bjthemost-hub/l103-drv8313-as5600/firmware/命令表与使用说明_UART与CAN_2026-09-28.md

# CH32L103_DRV8313_FOC_CAN —— 命令表与使用说明（UART + CAN）

**适用固件**：本仓库 `firmware/`
**整理日期**：2026-09-28 ｜ **依据**：全部逐条读源码核过（`cmd.c` / `motion_pv.c` / `can_bus.c` / `can_bus.h` / `board.h` / `faults.h` / `motion_pv.h`），
行号在文中标出；**不是**凭记忆或二手转述。没有实测过的项在末尾单列。

---

## 0. 两个口

| 口 | 物理 | 参数 | 说明 |
|---|---|---|---|
| UART1 控制台 | WCH-Link 自带的串口桥 → **COM15** | **115200** 8N1，命令以**回车**结束 | 人机调试口 |
| CAN1 | SN65HVD230，`PB8`=RX / `PB9`=TX | 标准帧 11bit；位时序 `board.h:73-75` = 预分频 2 / BS1 15tq / BS2 8tq / SJW 1tq（共 24tq）；`can_bus.h` 顶部注释写 **1 Mbps**（未量总线波形） | 上位机/总线控制口 |

- UART **不分大小写**（`cmd.c:495` 把小写折成大写），允许前导空格。
- **CAN 数据全部小端**（`can_bus.h` 顶部）。
- **发帧之前先认转接卡**：下面这些是**板子认的**帧。达妙那块 DM-USB2CAN 要在 COM5 上再套一层
  30 字节信封，沁恒 CH9433 EVB 直接发裸帧 —— 见 **§9**。
- 只有一方能开 COM15：脚本被打断会吊住端口，需要
  `Get-CimInstance Win32_Process | ? { $_.CommandLine -match '<脚本名>' }` 找出来 `Stop-Process -Force`。

---

## 0.5 ★ 铁律（都是踩出来的，先看这条）

> 这一段是从工程根那份索引文档搬进来的（2026-09-29 单一化）。**编号沿用旧表** ——
> 固件 `board.h` 的注释里写的"见命令表 铁律 #9"指的就是这里的第 9 条，别改号。

1. **`A` 对齐会强行拽转子** —— 对齐前电机必须能自由转；带着负载/卡死会对齐失败甚至堵转。
2. **改极对数之后必须重跑 `A`**。改极对数会把"已对齐"作废（零点电角是用旧极对数算的）。
3. **改控制器模式之前先 `B1`**（停+松轴）。`cmd_target` 一个变量被三种控制器共用（角度环=绝对多圈 rad / 速度环=rad/s / 力矩=电压 V），不看模式就切会**满压冲一下**。
4. **螺丝/外壳绝对不能碰 GND** —— 已经因此烧掉两颗 DRV8313 + 一颗 Si2319。
5. **`U`（重校电流零点）必须在电机停转时**做。
6. **上电默认相电压上限 = Vbus/√3，不用再 `L`**（`Motion_ApplyBootVoltageLimit()`，`motion_pv.c:484-493`，
   在 `main.c:140` 于 Flash 参数恢复之后调用）。24 V 母线 → **13.86 V**；Vbus 是参数
   （串口 `#0,0,36` / CAN `0x116` b4..5），改成 36 V 后上限变 20.78 V。
   ~~旧说法「上电默认只有 3.0 V」~~ 那是 `board.h` 里 `MOTOR_VOLTAGE_LIMIT` 还是 `3.0f` 的那版（**2026-09-28 之前**，
   已在 2026-09-29 更正）；现在宏是 `0.0f`（哨兵 = 跟母线走，`board.h:105`）。
7. **角度环输出还卡在 130 rad/s = 1241 rpm**（`MOTOR_VELOCITY_LIMIT`）。
   CAN/串口的速度上限给再大也没用 —— 要更高用 `0x115` 或改 `board.h`（运行时上限 150 rad/s = 1432 rpm）。
8. **汇报时用网名**（`MOT_A_V` / `MOT_B_V` / `ADC0` / `EN_A` / `PWM_A` / `+VDJ` / `G`），不要说 TP 号/位号。
9. **CAN 发帧会堵主循环 —— 所以它是被动设备，而且发帧必须有界**（2026-09-29 定案）
   - **现象**：总线没人给 ACK 时（USB-CAN 适配器没上线 / 没在收），旧固件 `CAN_Bus_SendStd()`
     在 `CAN_TransmitStatus()==Pending` 上**忙等 200000 圈**才放弃，**一帧堵约 162 ms**。
     主循环每 10 ms 想发一帧反馈 -> 被吃满 -> `LoopFOC()`（`main.c:184`）每秒只跑 **3~7 次**（正常 ~2000 次）。
     **2026-09-29 实测**：适配器不在线时 `n_tx=0`、`tx_fail` 猛涨、`TICK loopmax=162.5 ms`（最高 480 ms）、
     `loops=3~7`；适配器上线后 `tx_fail` 冻结、`loopmax=3.7 ms`、`loops≈1490~2110`。
     **排查口诀：`S` 看 `loops`，低于 ~1500 就是被 CAN 这位堵死了**（不是电机坏、不是驱动器坏）。
   - **现在的做法**：① 主动上报默认关（没有周期帧就没人来堵你）；② 发帧改成**按时间有界等待**
     （`CAN_TX_TIMEOUT_US = 2000us`，超时 `CAN_CancelTransmit` 丢帧），超时就取消这一帧 —— 宁可丢帧，不许堵环。

---

## 1. ★ 先记这一张：语义 / 单位（踩过事故的地方）

| 命令 | 绝对还是相对 | 单位 | 依据 |
|---|---|---|---|
| `G<x>@<rpm>` | **绝对**目标位置 | `x` = **圈**（不是弧度、不是度） | `cmd.c:682-688`（`Motion_RunPV(turns*_2PI, ...)`）+ `motion_pv.c:183`（`tgt_rad = target_rad` 直接赋值） |
| `P<deg>` | **绝对** | 度（可多圈） | `cmd.c:551-554` |
| `C<turns>` | **相对**（`+=`） | 圈 | `cmd.c:557-560` |
| `V<rpm>` | 速度目标 | rpm（机械） | `cmd.c:544-548` |
| `T<volts>` | 力矩目标 | V（相电压） | `cmd.c:538-541` |
| `N[<rpm>]` | 去**机械零点** | rpm | `cmd.c:622-624` + `motion_pv.c:604-618` |
| CAN `0x100` | 默认**绝对**（bit0 置 1 才相对） | mrad / 0.01 rad/s | `can_bus.h` 0x100 |

**`G` 的坑（2026-09-28 实锤）**：我把"相对 20 圈"算成弧度 `-131.2537` 发过去，固件按**圈**读
→ 目标是 `-131.25 × 2π = -824.8 rad`（-131 圈），电机真的跑出去又跑回来。
**要相对移动 N 圈**：先读 `S` 的 `shaft`，算 `目标圈数 = shaft/2π + N`，再发 `G<目标圈数>@<rpm>`。

**"小数字 ≠ 小幅度"**：想小幅验证，必须取一个**贴住当前位置**的绝对目标（先读当前位置再算），
别随手填个 `0.05`。

---

## 2. UART 命令表

### 2.1 只读 / 诊断

| 命令 | 作用 | 备注（出处） |
|---|---|---|
| `H` / `?` | 帮助 | `cmd.c:236-253` |
| `S` | 打一行状态 | `cmd.c:514-518` |
| `S0` / `S1` | 关 / 开 周期自动打印状态 | 非 0 值即开（`cmd.c:515`） |
| `W` | 运动 / 位置日志状态 | `cmd.c:618-620` |
| `Y` | AS5600 诊断（含 `raw/ang/AGC/MAG/err`，另有 `ANGLE(0x0E)/CONF(0x07)`） | `cmd.c:585-587`、`:297-300` |
| `Q` | DRV8313 / TIM3 引脚与复用诊断 | `cmd.c:594-596` |
| `I` | 故障现场 | `cmd.c:657-660` |
| `#` | 看电机参数（极对数/堵转/母线） | `cmd.c:645-649` |
| `K` | CAN 状态；`K0`/`K1` 反馈关/开；`KR` 清计数器 | `cmd.c:607-612` |
| `J` | 发一帧 CAN 测试帧 | `cmd.c:614-616` |
| `R` | 强制 I2C 总线恢复 | `cmd.c:589-592` |
| `X0` / `X1` | 关 / 开传感器轮询（`X1` 打的是 5 ms） | `cmd.c:580-583` |

### 2.2 使能 / 安全

| 命令 | 作用 | 备注（出处） |
|---|---|---|
| `E` | 合 EN **并进角度环保持当前位置** | 没对齐直接拒：`ERR: align first before enable`（`cmd.c:571-574`） |
| `D` | 失能（松轴，输出高阻） | `cmd.c:576-578` |
| `B` | 停 + **保持**（在原地） | `cmd.c:666-668` + `motion_pv.c:213-235` |
| `B1` | 停 + **松轴**（coast，断 EN） | 同上（参数非 0 即释放） |
| `O` | 清堵转故障（顺带重新使能并保持） | `cmd.c:662-664` + `motion_pv.c:636-655` |
| `A` | 对齐（**会强行拽转子**，电机必须能自由转） | `cmd.c:598-605` |
| `U` | 重标电流零点（**电机必须停着**） | `cmd.c:670-678` |
| `Z` | 把当前角度定义成 0 **并存 Flash** | `cmd.c:692-699`；改前先想清楚，它会覆盖零点 |
| `F` | 把当前位置设为**机械零点** | `cmd.c:627-630` + `motion_pv.c:433` |

### 2.3 运动

| 命令 | 语法 | 语义 | 备注（出处） |
|---|---|---|---|
| 模式 | `M0..M4` | 0=力矩(V) 1=速度环 2=角度环 3=速度开环 4=角度开环 | `M1`/`M2` **必须先对齐**；会**丢掉上一条 PV 轨迹**（`Motion_AbortPV`）（`cmd.c:520-535`） |
| 力矩 | `T<volts>` | 相电压（力矩） | 钳在 ±`voltage_limit`（`cmd.c:540`） |
| 速度 | `V<rpm>` | 机械转速 | 力矩模式下拒：`ERR: torque mode, use T<volts>`（`cmd.c:544-548`） |
| 位置(绝对) | `P<deg>` | **绝对**机械角，可多圈 | `cmd.c:551-554`；**在 HOLD 下会被每拍覆盖掉**（见坑） |
| 位置(相对) | `C<turns>` | `cmd_target += val*2π` | `cmd.c:557-560`；**它不切模式**——在 IDLE/力矩模式下会被当力矩电压用（见坑） |
| 位置(绝对+限速) | `G<turns>@<rpm>` | 走到**绝对**圈数，速度上限 rpm | `@` 省略或为 0 → 默认 **30 rpm**（`cmd.c:683-688`）；**它自己切角度环**、按速度曲线走、走完保持 |
| 回零 | `N[<rpm>]` | 走回机械零点 | 没设过零位 → `HOME: no mech zero set`（`motion_pv.c:606-610`）；速度 0 → 默认 `MOTION_HOME_VLIM_DEF = 3.14159 rad/s = 30 rpm`（`board.h:132`） |
| 设零 | `F` | 当前位置 = 机械 0 | 只写机械零点，不重置传感器累计角 |

### 2.4 参数 / 校准

| 命令 | 语法 | 说明（出处） |
|---|---|---|
| 相电压上限 | `L<volts>` | 钳在 `(0, vbus/√3]`；24 V 母线 → 最大 **13.86 V**（`cmd.c:563-568`） |
| 电机参数 | `#<pp>,<A>[,<V>]` | 极对数 / 堵转阈值(A) / 母线电压(V)；**下一项给 0 = 不改**（`#0,0,36` 只改母线）。写 Flash（`cmd.c:632-655`） |
| 量程 | — | 极对数 `1..64`（`board.h:49-50`）；堵转 `0.1..3.0 A`（`board.h:51-52`，>2.5 A 会提示 DRV8313 自身限流）；母线 `8.0..36.0 V`（`board.h:92-95`，下限出处 DRV8313 手册 6.3，上限出处用户给的关节 24~36 V） |
| 直流保持 | `@<V>[,<s>]` | 量母线电流 / 量相电阻用；默认 2 s（`cmd.c:501-506`），帮助文本写"max 5s"（`cmd.c:252`），`Cmd_DcHold` 内部的钳位本次**没逐行读** |

> ⚠ **改极对数会把"已对齐"作废**（`zero_electric_angle` 是拿旧极对数算的）→ 改完**必须重跑 `A`**，
> 否则电角度整圈都错（没劲 / 抖 / 发热 / 不走）。

> 动作的"快慢"（加减速、位置环、前馈）**不是运行时命令**，是编译期常数 —— 见 **§13**。

### 2.5 板载动作脚本（`*`，2026-09-29 上机实测）

一条命令把"等多久 → 以多快转多少 → 停多久"排成序列，**在板子上跑**，上位机不用一直喂命令
（另一颗没有 shell 的单片机发完就能走）。实现在 `motion_pv.c` 的 `Motion_Seq_*` 一段。

| 语法 | 作用 |
|---|---|
| `*{<等待us>,<±rpm>,<角度deg>,<停留ms>}{...}{...}` | 追加 N 段（`;` 也能分段，空格随便加） |
| `*!` / `*!<n>` | 跑一遍 / 跑 n 遍（n>99 按 99 算） |
| `*0` | 清空队列 **（运行中不会停，见下面的坑）** |
| `*?` | 打印队列与累计角度 |

字段**固定四个位置**，逗号分隔（第 1 列和第 4 列**单位不一样**，这是最容易记错的地方）：

| 字段 | 单位 | 含义 | 允许范围 |
|---|---|---|---|
| ① 等待 `wait` | **微秒 us** | **这一段开跑前**先等多久 | 0 .. 10000000（= 10 s） |
| ② 速度 `rpm` | rpm（机械转速） | **速度上限**；**符号就是方向**（负 = 反转） | 绝对值 1 .. 1432；不能是 0 |
| ③ 角度 `deg` | 度 | 相对**本遍起点**要转多少；**必须正数** | 0 < deg ≤ 36000（100 圈） |
| ④ 停留 `dwell` | **毫秒 ms** | **这一段跑完**再停多久才进下一段 | 0 .. 60000（= 60 s） |

**逐字段读一条例子**：`*{0,60,90,0}{1000000,-60,90,0}`

| 段 | ① 等待 | ② 速度 | ③ 角度 | ④ 停留 | 读出来的意思 |
|---|---|---|---|---|---|
| 1 | `0` | `+60` | `90` | `0` | 按下 `*!` **立刻**开跑；正方向、上限 60 rpm、转 90°；跑完**不停**，直接进第 2 段 |
| 2 | `1000000` | `-60` | `90` | `0` | **先等 1000000 us = 1 s**（这是第 2 段开跑前的等待），再反方向 60 rpm 转 90°；跑完结束 |

合起来就是：**正转 90° → 停 1 秒 → 反转 90° → 停**，净回到本遍起点。

> ⚠ 单位陷阱：第 ① 列是**微秒**、第 ④ 列是**毫秒**。
> "等 1 秒"要写 `1000000`；"停 1 秒"要写 `1000`。写成 `{1000,...}` 只是等 **1 毫秒**。
> 实测（`t24_wait.log`）：dwell=0 时 `wait=1000000` 的转场 = **+1002 ms**；
> 而 `wait=1000`（1 ms）与 `wait=0` 在本仪器上**分不出来**（地板约 1–2 ms）。

- **方向 = `rpm` 那一栏的符号**；**`deg` 必须写正数** —— 负角度一律拒，方向只能有一处（2026-09-28 的单位/符号事故）。
- 角度是**相对本遍起点**（按下开始那一刻的实际位置）算的：不跨段累积、不跨遍累积，**不用先设机械零位**。
- 上机实测（2026-09-29）：
  - 上限：16 段（`SEQ_MAX_SEG`）；`wait` 0..10000000 us；`dwell` 0..60000 ms；
    `deg` 0<deg≤36000（100 圈）；`|rpm| ≤ 1432`。**越界整行回退**，不会留半条脚本。
  - 一行只放得下 ~128 字符（`LINE_MAX`）：约 12 段。要 16 段就分两行**追加累加**。
  - 段与段的间隔 = **上一段的 `dwell` + 这一段的 `wait`**（2026-10-06 实测：dwell=2000 ms 量到 1996 ms、
    wait=2000 ms 量到 1997 ms）。**两者都为 0 时从 2026-10-06 起一点死等都没有**，见下面「段间不停顿」。
  - 每段的 `wait` 在**每一遍开头也会重放**一次。
  - 到位瞬间残余 2–8°，静置约 100 ms 后收敛到 mrad 级 → 想落点稳，段间给 100–200 ms 停留。
    （2026-10-06 起：只有**给了** wait/dwell 才会停 —— 两个都写 0 就一点不等，见下条「段间不停顿」。）
  - 段耗时很稳：16 段×2 遍 = 32 段 / 39.2 s，两遍之和与单遍×2 只差 7 ms；峰值电流 0.18 A（阈值 2.00 A）。
#### 段间不停顿（2026-10-06 起，上机实测）

判据一条：**这一段没设"开始前等待"和"跑完停留"（`wait=0` 且 `dwell=0`），就不该有任何停顿**。

| 情形 | 行为 | 实测（2026-10-06，COM15 主机时间戳） |
|---|---|---|
| 同向 + 同速度上限 + `wait=0` + `dwell=0` 的连续段 | **并成一次运动**：目标一次给到底，中途不减速停车。日志打 `seg 1-3/3` 并多一行 `^ 3 段接续成一次运动 (中途不停)`，`MOT: PV target=` 只出现一次 | 3×3000° @500 rpm：**4387 / 4385 ms**（本补丁之前的实测基线 3×2365 = 7095 ms）；3×3000° 反向同为 4385 ms；3×300° @300 rpm：1331 ms |
| 换向（`+` 后接 `−`）、或同向但速度上限不同，且后面那段 `wait=0`/`dwell=0` | 仍是**两次运动**（换向要过零，物理免不掉），但中间**一个 tick 的死等都没有**：上一段参考到位就发下一段 | 换向 3000°→−3000°：第 1 段 `done in 2265 ms` 与第 2 段 `MOT: PV target=` 落在**同一毫秒** |
| 后面那段设了 `wait` 或 `dwell` | 按设的等，不再额外叠那最多 100 ms 的定点窗口 | dwell=2000 ms → 间隔 1996 ms；wait=2000 ms → 1997 ms |
| 这一段的 `dwell ≠ 0` | **不并**（自己要停就不能并），先停够再走 | `{0,300,300,2000}{0,300,300,0}`：两段分开，中间 1996 ms |

- 合并**只**发生在"同向 + 同速度上限"（一条 PV 轨迹只有一个速度上限）。想连速度都不掉，就写成一段或统一速度上限。
- 两个都是 0 时，那最多 100 ms 的"定点窗口"也**不走了**：`seq_next_is_immediate()`（`motion_pv.c`）判断"接在后面那段是不是 0/0"，是就直接进下一段。旧行为 = 剖面减速到零 **+** 这个白等（实测残差 6~8°，够不到 `SEQ_SETTLE_RAD = 0.02 rad` 门槛，每次都走满超时支）。
- 代价：合并的那几段中途**不**定点，残余（实测 ≈0.12 rad ≈ 7°）留到这一组跑完才收敛。要每段都落得准，就**别**让它合并 —— 给该段一个非 0 的 `dwell` 即可。

- ⚠ **两个坑**：
  1. **运行中 `*0` 不会停**：`Motion_Seq_Clear()` 只清队列不动 `seq_run`，在 `*!n`(n≥2) 时会把残留的
     第一段继续跑完剩余的遍数（2026-09-29 实测，轴多走了 4×45°）。**停脚本请用 `B1` / `B`**（实测有效），
     或 `D` 失能 —— 这两种都会打 `SEQ: aborted, script dropped`。
  2. 开始跑要求**已对齐 + 已使能**：否则被拒（`SEQ: refused - not aligned` / `- driver disabled`）。
- CAN 侧的等价入口见 §3.4。

---

### 2.6 相电流波形流（`SW`，2026-10-06 加）

给上位机画实时相电流曲线用。**这条一发出去，UART1 就不再是文本控制台** ——
上位机必须切成"按二进制收"（工作台上位机的「波形」页会自动切）。

| 命令 | 作用 | 备注（出处） |
|---|---|---|
| `SW` | 打印一行：`WAVE: ON/OFF div=… (frames ~…/s) samples=… frames=… txdrop=…` | `cmd.c:533` + `wave.c:Wave_PrintInfo` |
| `SW1` / `SW0` | 开 / 关波形流 | 开会先打一行文本 `WAVE: ON …`，那行之后才是二进制 |
| `SWD<div>` | 分频：每 `div` 个采样点发一帧，`1..200`（默认 **2**） | `div<1` → `ERR: SWD<div> 1..200`（`cmd.c:536-543`） |
| `SWB<baud>` | 改 UART1 波特率（`9600..3000000`），**会自动先关波形流** | 回显在改之前用**旧**波特率发出（`cmd.c:544-553` + `wave.c:Wave_SetBaud`） |

**帧格式 —— 9 字节，小端**：

| 偏移 | 内容 |
|---|---|
| 0-1 | 帧头 `0xAA 0x55` |
| 2 | 类型 `0x01` = 三相相电流（`0x02` 留给母线 I/V，**只是预留，固件不发**） |
| 3-4 | `iU` int16，**0.001 A/LSB** |
| 5-6 | `iV` int16，同上 |
| 7-8 | `iW` int16，同上 |

- 板子采样周期 500 µs（`CS_TASK_MIN_US`），所以**标称帧率 = 2000/div**；`SWD2` → 1000 帧/s。
- **`iU` 是反推的**（`iu = -(iv+iw)`，`csense.c:204`）；`iV` 来自 PA4 / U8（V 相），
  `iW` 来自 PA1 / U10（W 相）。所以 **`iU+iV+iW ≈ 0`** —— 上位机拿它当帧校验排误同步。
- 一帧 9 B：**`SWD2` 在 115200 下是能收全的工作点**（工作台上位机实测 757 帧/s、误同步 0）；
  `SWD1` 会超过链路上限而丢帧。

**不影响 FOC**（设计前提，2026-10-06 实测）：`Wave_Sample()` 只往 2048 B 发送环形缓冲塞 9 字节就返回，
缓冲满就丢字节并计 `txdrop`，**不等待、不进 FOC 中断**。电机 500 rpm 稳转下实测：
波形关 `loopmax = 814 µs` vs 波形开 `809..832 µs`，且固件 `txdrop` 没涨。

> ⚠ 坑：板子在**失能**状态下每秒会打一段 `FAULT/CAN/TICK` 状态行
> （`main.c:243` `if(!Motion_IsEnabled() || Cmd_AutoStatus())`）。波形流开着时这坨 ASCII 会混进帧流，
> 上位机表现为「杂散」每秒涨 ~700、帧率掉到 ~650。**使能之后自动静音**，杂散归零。
> 要彻底消掉得再加一档 `auto_status = 2`（全静音），**没做**。

## 3. CAN 命令帧（主机 → 板，标准帧）

### 3.1 `0x100` 位置-速度（PV）

| 字节 | 类型 | 含义 |
|---|---|---|
| b0..3 | int32 | 目标位置，**mrad**（0.001 rad），可正可负、可多圈 |
| b4..5 | int16 | 速度上限，**0.01 rad/s** |
| b6 | flags | bit0=1 相对（相对收到命令那一刻）/ 0 绝对；bit1=1 运行 / 0 停止；bit2=1 停止时松轴 / 0 停止时保持；bit3=1 清堵转（顺带重新使能）；bit4=1 立刻把当前位置存 Flash；bit5=1 目标用**机械坐标**（需先设过机械零位）；**bit0 与 bit5 同时置位按 bit0（相对）** |
| b7 | — | 保留 0 |

### 3.2 `0x101` 纯速度

| 字节 | 类型 | 含义 |
|---|---|---|
| b0..1 | int16 | 速度，**0.01 rad/s** |
| b2 | flags | 同 `0x100` 的 b6（**bit0 / bit5 被忽略**） |
| b3..7 | — | 保留 0 |

### 3.3 其余命令

| ID | 内容 | 字节 | 回复 |
|---|---|---|---|
| `0x110` | 使能/失能 | b0: 1=使能(合 EN + 角度环保持当前位置) / 0=失能(松轴)；使能要求**已对齐**，否则回 `0x1A0`(NOT_ALIGNED) | `0x181` |
| `0x111` | 回机械原点 | b0..1 int16 速度上限 0.01 rad/s（**0 → 默认 30 rpm**） | `0x181`；没设过零位回 `0x1A0`(CMD_REJECT) |
| `0x112` | 把当前位置设为机械 0 点（立即存 Flash） | b0..7 保留 | `0x181` + `0x182` |
| `0x113` | 询问 | b0: 0=位置+速度→`0x181`，1=配置→`0x182`，2=故障→`0x183`，3=电机参数→`0x184`，`0xFF`=全回 | 按 b0 |
| `0x114` | 故障主动上报配置 | b0: 0=关 1=开（默认开）；b1: 周期重报间隔 ×100ms（0=只在变化时报，默认 10=1s） | `0x182` |
| `0x115` | 设角度环速度上限 | b0..1 int16，0.01 rad/s（≤0 忽略）；上限受 `MOTOR_VELOCITY_LIMIT_MAX=150 rad/s=1432rpm` 钳（`board.h:110`） | `0x181` |
| `0x116` | 设电机参数并存 Flash | b0 uint8 极对数（0=不改）；b1..2 int16 堵转 0.01 A（0=不改）；b3 flags **bit0 必须=1**（防呆确认位，给 0 直接拒）；b4..5 int16 母线 0.01 V（0=不改，dlc<6 视为没给） | `0x184` + `0x182` |
| `0x120` | 动作脚本**加一段**（一帧一段）：b0..1 uint16 开始前等待 [100 us]；b2..3 int16 速度 [rpm，符号=方向]；b4..5 int16 角度 [0.1 度，必须正数]；b6..7 uint16 跑完停留 [10 ms] | `0x181`；被拒回 `0x1A0`(CMD_REJECT) |
| `0x121` | 动作脚本**控制**：b0 0=清空 / 1=开始 / 2=打印；b1=遍数（0 或 1 = 一遍） | `0x181` |
| `0x122` | 动作脚本**加一段·大角度版**（2026-10-06）：布局与 `0x120` **逐字节相同**，只有角度刻度不同 —— b4..5 int16 角度 **[1 度]**（`0x120` 是 0.1 度）。要在一条帧里给 >3276.7 度的段就用它（上限 32767 度，再按 `deg ≤ 36000` 判） | `0x181`；被拒回 `0x1A0`(CMD_REJECT) |

保留 ID：`0x102..0x10F`、`0x117..0x11F`、`0x123..0x17F`。（`0x122` 已于 2026-10-06 启用作大角度段。）

> `0x116` 的几条参数是**一起校验、一起生效**：只要有一条越界就整条不作数（不会改一半），通过后只写一次 Flash。
> 拒绝条件：越界 / b3.bit0=0 / 要改极对数时驱动还在使能中。

### 3.4 `0x120` / `0x122` / `0x121` 板载动作脚本（2026-09-29 起，2026-10-06 加 `0x122`）

三帧加一帧控制，就能让板子自己跑一串动作，**上位机发完可以走**：

    主机 -> 0x120  00 00 | 3C 00 | 84 03 | 32 00    # +90度 @60rpm, 跑完停 0.5s, 不等
    主机 -> 0x120  00 00 | C4 FF | 84 03 | 32 00    # -90度 @60rpm, 停 0.5s
    主机 -> 0x121  01 01                            # 开始, 1 遍

- 实测（`work\can_seq.log` / `can_seq2.log`）：每帧回一行 `SEQ: +1 seg (CAN) -> queue n/16`；
  `0x121` b0=1 回 `SEQ: RUN 3 seg(s) x 1 pass(es)`；跑完 `SEQ: all done`。
- **进度读 `0x184`**：`b6` = 这一遍还剩几段（实测 3→2→1→0），`b7` = 正在跑第几遍（0 = 没跑）。
  上位机轮询 `0x113` b0=3 就行，不用猜。
- 单位换算**上机验过**：`wait` ×100 us、`dwell` ×10 ms（故意各设一档量转场间隔，没有 10 倍误差）。
- 非法帧（例如 rpm=0）串口打 `SEQ ERR: ...`；源码还会 `Fault_ReportReject`，
  但**被动模式下没观测到 `0x1A0` 事件帧（未验证）**。
- 运行中想停：`0x100` flags bit2（停+松轴）或串口 `B1`；**`0x121` b0=0 只是清队列，不停正在跑的**。
  （2026-10-06 又踩一次：在 dwell 里清队列，正在跑的脚本**被截断**，后半段不再跑 —— 停脚本只能用 `B1`/`B`/`D`。）
- **`0x122`（大角度段，2026-10-06 上机实测）**：角度字段只有 16 位，`0x120` 用 0.1 度/LSB 顶到 **3276.7 度**；
  要更长就得牺牲分辨率，`0x122` 用 **1 度/LSB**，上限 32767 度（再受 `deg ≤ 36000` 钳）。
  - 刻度实测（同一串字节 `00 00 64 00 5A 00 00 00`）：发 `0x120` → 队列打 `9.0 deg @ 100 rpm`；发 `0x122` → 打 `90.0 deg @ 100 rpm`。
  - 真跑：一条 `0x122` **+4000 度 @300 rpm** → 位移 **+4000.10 度**（+11.111 圈，`done in 3083 ms`）；反向 `rpm=-300` 同样 4000 度 → **−3999.99 度**。
  - 两条帧进的是同一个 `Motion_Seq_AddSeg()`，**落点 / 同向接续 / 等待 / 停留的行为完全一致**（方向仍在 `rpm` 的符号里，`deg` 仍必须写正数）。

---

## 4. CAN 反馈帧（板 → 主机）

### 4.1 `0x180` 周期反馈 / `0x181` 即时状态（布局完全相同）

| 字节 | 类型 | 含义 |
|---|---|---|
| b0..3 | int32 | 当前**机械坐标**位置，mrad（多圈）＝ 原始累计位置 − 机械零位 |
| b4..5 | int16 | 当前速度，0.01 rad/s |
| b6 | uint8 | 状态位，见 §4.3 |
| b7 | int8 | 相电流，0.1 A（三相重构后取 \|i\| 最大的那相，带符号） |

周期 = `CAN_FB_PERIOD_US = 10000`（**10 ms**，`can_bus.h`）。

### 4.2 `0x182` 配置 / `0x183` 故障 / `0x184` 电机参数 / `0x1A0` 故障事件

| ID | 字节 | 含义 |
|---|---|---|
| `0x182` | b0..3 int32 | 机械零位在原始坐标系里的位置，mrad |
| | b4..5 uint16 | 母线电压，**0.1 V**（本版硬件没有 VM 采样 → 打的是配置值） |
| | b6 flags | bit0 已设机械零位；bit1 已对齐；bit2 有 VM 采样；bit3 驱动已使能；bit4 故障主动上报开 |
| | b7 uint8 | 上报周期，×100 ms |
| `0x183` | b0..1 uint16 | 当前活动故障位（`CAN_FAULT_*`） |
| | b2..3 uint16 | 锁存故障位（出现过就保持，直到被清） |
| | b4..7 uint32 | 累计故障事件帧数 |
| `0x184` | b0 uint8 | 当前极对数 |
| | b1..2 int16 | 当前堵转阈值，0.01 A |
| | b3 flags | bit0 参数来自 Flash（不是编译默认）；bit1 已对齐；bit2 驱动已使能 |
| | b4..5 int16 | 当前母线电压，0.01 V |
| | b6 uint8 | 动作脚本：这一遍还剩几段（0 = 没在跑） |
| | b7 uint8 | 动作脚本：正在跑第几遍（0 = 没在跑） |
| `0x1A0` | b0..1 uint16 | 故障位 |
| | b2 | 0=发生 / 1=消失 |
| | b3 | b4..5 是什么：0 无 / 1 电流(0.01A) / 2 电压(0.1V) / 3 被拒命令 ID |
| | b4..5 int16 | 附加值 |
| | b6..7 uint16 | 事件时刻，ms（上电起，会回绕） |

### 4.3 状态位（`can_bus.h`）与故障位（`faults.h`）

| 状态位 | 值 | 含义 |
|---|---|---|
| `CAN_ST_RUN` | 0x01 | 位置/速度环正在跑 |
| `CAN_ST_ARRIVED` | 0x02 | 已到目标 |
| `CAN_ST_STALL` | 0x04 | 堵转过流锁存，PWM 已停 |
| `CAN_ST_SENSOR_ERR` | 0x08 | AS5600 读失败 |
| `CAN_ST_ALIGNED` | 0x10 | 有可用对齐参数 |
| `CAN_ST_POS_RESTORED` | 0x20 | 位置来自 Flash 恢复 |
| `CAN_ST_ENABLED` | 0x40 | DRV8313 EN 已合上 |
| `CAN_ST_ZERO_SET` | 0x80 | 已设过机械零位 |

| 故障位 | 值 | 含义 |
|---|---|---|
| `CAN_FAULT_STALL` | 0x0001 | 堵转（已停 PWM + 松轴） |
| `CAN_FAULT_OVERCURRENT` | 0x0002 | 相电流超限 |
| `CAN_FAULT_DISABLED` | 0x0004 | 使能过又被失能（**历史标志，不挡出力**） |
| `CAN_FAULT_VM_LOW` | 0x0008 | 母线电压低（需 VM 采样） |
| `CAN_FAULT_SENSOR` | 0x0010 | AS5600 读失败 |
| `CAN_FAULT_NOT_ALIGNED` | 0x0020 | 没对齐（有命令因此被拒） |
| `CAN_FAULT_FLASH_FAIL` | 0x0040 | 位置保存 Flash 写失败 |
| `CAN_FAULT_DRV_NFAULT` | 0x0080 | DRV8313 nFAULT 被拉低 |
| `CAN_FAULT_CMD_REJECT` | 0x0100 | 命令被拒（脉冲 1s） |

---

## 5. 典型流程

**A. 上电到能动（UART）**
```
#            看参数（pole_pairs / stall / vbus 是不是你要的）
E            合闸 + 进角度环保持
S            确认 en=1 aligned=1 stalled=0
G0.05@30     贴住当前位置的小幅验证（★ 绝对圈数）
```
> 换过电机或改过极对数：先 `A` 对齐（电机必须能自由转），再看 `S` 的 `aligned=1`。

**B. 走一段相对距离（UART）**
```
S                      记下 shaft（rad）
# 目标圈数 = shaft/2π ± N
G<目标圈数>@<rpm>       例如 shaft=-0.01 rad、要顺时针 20 圈 → G-20.002@300
```

**C. 设机械零点（UART 或 CAN）**
```
把轴挪到你想当 0 的位置
F        （CAN: 0x112）
#        确认 POSLOG: home 不再是 (never set)
```

**D. 换母线电源（不用重编）**
```
#0,0,36      只改母线电压为 36 V（存 Flash）
#            回读确认 vbus = 36.00 V [Flash]   → 相电压上限随之变成 36/√3 = 20.78 V
```

---

## 6. 坑（都会咬人）

1. **`G` 是绝对圈数** —— 见 §1。这是 2026-09-28 那次 -131 圈事故的根因。
2. **`C<turns>` 不切模式**：在 IDLE / 力矩模式下发 `C`，它只做 `cmd_target += val*2π`，
   于是这个值会被**当成力矩电压**用 → 裸关节空转（实测过一次约 23.5 圈）。**位置运动请用 `G`。**
3. **HOLD 每拍覆盖 `cmd_target`**：`E`（HOLD）下发的 `P<deg>` 会被无声抹掉；`G` 会自己切轨迹所以不受影响。
4. **改模式前先 `B1`**：`M0` 在 POS 状态下会把 `ref_rad` 当地占空比覆盖 → 满输出。
5. **`S` 的 `vel` 单点不可用于判稳态转速**（抖动可到 ±60%）；要速度用位置日志/CAN 高频记录。
6. **烧写会擦 Flash 里的电机参数与零点**（`make flash` 整片擦）：烧完要重设 `#` 与重做 `A`/`Z`/`F`。
7. **`-flto` 绝对不能开**：会吃掉中断向量表 → 烧完 LED 不闪、串口无输出。
8. **堵转阈值**：编译默认 `MOTOR_STALL_AMP = 2.0 A`（`board.h:78`），窗口 5 ms × 连续 3 个 = 15 ms（`board.h:79-80`）。
   若某颗电机的堵转规格本身就接近 2 A，往上加电压会立刻跳闸 —— 这是设计如此，不是算法坏了；用 `#<pp>,<A>` 调。
9. **`MOTOR_VELOCITY_LIMIT = 130 rad/s`（1241 rpm）** 是角度环输出的钳位（`board.h:106`），
   运行时能设到的上限是 150 rad/s（1432 rpm，`board.h:110`）。给再大的速度指令也会被钳。
10. **高速 + 传感器报错 = 真跑圈**：位置环会把"多圈计数跳变"驱动成**真实转动**（机理见家规「同一路反馈不算独立证据」）。

---

## 7. 出处与"没做/没验证"清单

**出处（逐条读过）**：`cmd.c`（分发 486-705、帮助 234-254、`Cmd_Status` 205-216）、
`motion_pv.c`（`Motion_RunPV` 170-192、`Motion_Stop` 213-235、`Motion_GotoHome` 604-618、`Motion_ClearFault` 636-655）、
`motion_pv.h`（15-17）、`board.h`（49-52、73-75、78-80、83-95、105-111、132）、
`can_bus.h`（协议全文）、`can_bus.c`（ID 分发 492-500）、`faults.h`（25-33）。

**没做 / 没验证**：
- CAN 位速率只按 `can_bus.h` 注释 + 位时序推算写 **1 Mbps**，**没有量过总线波形**。
- `@<V>[,<s>]` 的"最大 5 s"只来自帮助文本，`Cmd_DcHold` 内部的钳位没逐行读。
- `0x114` 的默认值（开 / 10×100ms）来自注释，没实测过主动上报周期。
- 本表**没有**在总线上逐条实测所有 CAN ID（UART 侧的大部分命令本轮及前几轮实测过）。
- 报告的实测数字来自台架日志（未随仓库发布）。

---

## 8. 上位机标准命令（主机侧，2026-09-29 加）

"往返运动"这类**多段动作固件里没有对应命令**，只能由 PC 侧连着下发 —— 所以它不在这张 UART/CAN 表里，
而是一条 **PC 侧的标准命令**：参数全写死在脚本里，不用再手抄那串 `--segs`。

```
tools/l103_seq.ps1
```

| 标准命令 | 动作（默认 100 rpm、每段到位停 0.5 s） |
|---|---|
| `l103_seq.ps1` | 往返：机械 0 → +1 圈 → +2 圈 → 回机械 0 |
| `l103_seq.ps1 -Preset home` | 直接回机械 0 |
| `l103_seq.ps1 -Preset nudge` | 0 → +30° → 回机械 0（60 rpm，小幅试探） |
| `l103_seq.ps1 -Preset list` | 列出所有模板 |
| `l103_seq.ps1 -DryRun` | **只算分段打印出来，一个字节都不发**（发之前先看一眼） |
| `l103_seq.ps1 -Segs "3.1416:60,0:60"` | 自己排段 |

- 段的口径：**机械坐标 rad 绝对值**（`0x100` b6 bit5），不是相对量、不是圈。
  `0` = `F` / `0x112` 设过的机械零点，没设过会被拒。
- 脚本本体在 `05_工具与日志\脚本\l103_can.py`（等价写法 `python l103_can.py seq --preset roundtrip`，
  模板写死在它的 `PRESETS` 里）。`-Preset` 也认中文：`往返 / 回零 / 试探`。
- 逐段数据落 `05_工具与日志\日志\seq_<preset>.txt`；细节与坑见 `05_工具与日志\注意事项_上位机脚本.md` §六。
- **实测**（2026-09-29，就是这套默认参数）：3 段总耗时 **3.8 s**，静置落点误差 **−0.0010 / −0.0010 / −0.0140 rad**，
  峰值电流 **0.40 A**，三段都 `[arrived]`。

---

## 9. ★ CAN 帧怎么发出去：转接卡不一样，信封不一样（2026-09-29 补）

**问题**：CAN 命令怎么这么长？能不能像 modbus 那样只发几个字节？

**答案**：**那串长的是转接卡要的，不是 L103 的协议。** 板子从头到尾只认标准 CAN 帧 ——
11 bit ID + 0~8 字节数据。换一块转接卡，"长"就没了。

| | 达妙 DM-USB2CAN | 沁恒 CH9433 EVB |
|---|---|---|
| USB 标识 | `VID_2E88 & PID_4603` | `VID_1A86 & PID_5610` |
| PC 侧看到的设备 | 一个串口 **`COM5 @921600`** | **两个**：`MI_00` = `USB To CAN`（WCH 外部接口类）；`MI_01` = `USB-SERIAL CH9433 (COM23)` |
| 需要的驱动 | 达妙自带 | `MI_00` → **CH372DRV**（`ch375wdm.inf`，服务 `CH375_A64`）；`MI_01` → `ch343ser.inf`（CH343SER） |
| 一帧多少字节 | **30**（22 字节信封 + 8 字节载荷） | `CanSendFrame(h, buf, 8, id, 0, 0)` —— 载荷 + 帧ID，**没有信封** |
| 上位机怎么写 | 往 COM5 写那 30 字节（`l103_can.py` 的 `host_frame()`） | `USBCANx64.dll` + ctypes |

### 9.1 达妙那 30 字节信封逐字段

出处：`05_工具与日志\脚本\l103_can.py` 的 `host_frame()`（函数末尾有 `assert len(b) == 30`），
结构体名 `CAN_Fream`，另见模块说明书 `dm_usb2can_frames.txt`。

| 偏移 | 字节 | 内容 |
|---|---|---|
| 0..2 | 3 | `55 AA 1E` —— 帧头 + 长度（`0x1E` = 30） |
| 3 | 1 | 命令：`HOST_CMD_FWD = 0x01`（转发一帧） |
| 4..7 | 4 | `times` uint32 小端 —— 重复几次 |
| 8..11 | 4 | `interval_ms` uint32 小端 —— 重复间隔 |
| 12 | 1 | ID 类型：0 = 标准帧 |
| 13..16 | 4 | **CAN ID** uint32 **小端** |
| 17 | 1 | 帧类型：0 = 数据帧 |
| 18..20 | 3 | 数据长度（固定 8）/ idAcc / dataAcc |
| 21..28 | 8 | **真正的 8 字节载荷 ← L103 只看这一段** |
| 29 | 1 | CRC（脚本填 0，模块忽略） |

回帧固定 16 字节：`[0] 0xAA` 帧头 / `[1]` CMD / `[2]` `canDataLen:6|canIde:1<<6|canRtr:1<<7` /
`[3..6]` CAN ID 小端 / `[7..14]` data[8] / `[15] 0x55` 帧尾。
CMD：`0x00` 心跳 / `0x11` **接收成功** / `0x12` **发送成功** / `0x01` 接收失败 / `0x02` 发送失败 / `0xEE` 通讯错误。

**实测样本**（2026-09-29 20:19:56，SSCOM 抓的、家人手发的一条"回机械原点"）：

```
发→ 55 AA 1E 01 01 00 00 00 05 00 00 00 00 11 01 00 00 00 08 00 00 00 00 00 00 00 00 00 00 00
收← AA 12 08 11 01 00 00 00 00 00 00 00 00 00 55
收← AA 11 08 81 01 00 00 00 00 00 00 00 00 F9 00 55
```

- 第一行：cmd `01` / times `1` / interval `5 ms` / **CAN ID = `11 01 00 00` 小端 = `0x111`**（回机械原点）。
- 第二行：cmd `0x12` = **发送成功**，ID 回显 `0x111` —— **这只是收条，不是板子的应答**。
- 第三行：cmd `0x11` = **接收成功**，ID = `81 01 00 00` = **`0x181`**，载荷 `00 00 00 00 00 00 F9 00`
  → 位置 0 / 速度 0 / **status `0xF9`** / 电流 0。`0xF9` = RUN + **SENSOR_ERR(0x08)** + ALIGNED + RESTORED + ENABLED + ZERO_SET。

> ⚠️ **最容易踩的坑**：第二行那张"发送成功"的收条，ID 回显的是**你发出去的 ID 不是板子应答的 ID**。
> 拿它当板子回帧，会把 `0x111` 误读成 `/ 0x181`。认 CMD：**`0x11` 才是板子来的数据**。

### 9.2 换 CH9433 要改的地方

1. **装 CH372DRV**（`MI_00`）：跑 `DRVSETUP64`，窗口标题「驱动安装(X64)」，按钮是自绘的 →
   Win32 `EnumChildWindows` + `SendMessage(BM_CLICK = 0x00F5)` 点。成功证据在 `%windir%\inf\setupapi.dev.log`：
   `Configuration: oem111.inf:usb\vid_1a86&pid_5610&mi_00` 加一行 `{Add Service: CH375_A64}`。
2. **别走串口**：`MI_01` 那个 COM23 是 CH9433 自带的 9 线 UART，**与 CAN 无关**。
   依据：`ch375wdm.inf` 里匹配 CH9433 的只有 `USB\VID_1A86&PID_5610&MI_00` 一行，全 INF 无 `MI_01`；
   `USBCAN.h:18` 的 `CanIDString` 只写 `VID_1A86&PID_5610`；demo 源码 `USBCanDemo\main.cpp` 里没有一行串口代码。
3. **上位机换 ctypes 调 DLL**：`CanCfg{nWorkMode u32, bOneShot i32, nBaudRate u32}`（12 B，用 `CanCfg(0,0,1000000)`）；
   `CanRecvData{nNum u32, Data[4]{nType u8, union{nStateFlag u8 | Frame{nSize u8, FrameId u32, Buf[8], bExtend i32, bRemote i32}}}}`（116 B）；
   `CanOpenDev(0, 1000, &cfg)`；`CanSendFrame(0, buf, 8, can_id, 0, 0)` —— **第 4 个参数才是 CAN ID**。
4. **占用**：`USBCanDemo.exe` 会**独占** `MI_00`，被占时 `CanOpenDev` 一律返回 `0xFFFFFFFFFFFFFFFF`（不是 0），脚本要判这个值。
   探测用 `CreateFileW(设备接口路径, GENERIC_READ|WRITE, 0, ...)`：`err=5` 被独占、`err=0` 空闲；释放用 `CloseMainWindow()`。
5. **不用改的**：`0x113` 轮询照旧（板子是被动设备），与转接卡无关。

完整版说明见项目文档。

---

## 10. 实测补记（2026-09-29 深夜）

**三段净位移 0 的序列，速度 ±200rpm，连跑 20 遍**：

| 项 | 实测 |
|---|---|
| 序列 | +230°/停 1 s → −240°/停 2 s → +10°/停 200 ms（每段 ±200 rpm，净位移 0） |
| 用时 | **96.82 s**（4.84 s/遍） |
| 起点 / 终点 | 回零点 `+0.057°` → 收尾 **`−0.172°`**（净偏差 `−0.229°` = `−0.0006 圈`） |
| 逐遍落点 | mean `−2.418°` / median `−1.605°` / stdev `2.112°` / min `−7.678°` / max `−0.229°` |
| 有无累积 | 前 10 遍均值 `−2.074°` vs 后 10 遍 `−2.762°`；线性斜率 `−0.056°/遍`。**围着 −2.4° 散，不是一遍比一遍偏** |
| 电流 | 采样点全程 `−0.1 ~ +0.1 A`，无 STALL / OVERCURRENT / 失能 |

对照上一轮：**回程段 dwell = 0 时**会逐遍累积（20 遍 +73.7°）；**dwell 非零**时误差不跨遍累积。
（机理：`motion_pv.c:549-557` 每遍开头 `seq_tgt_rad = shaft_angle` 重锚；dwell=0 时重锚发生在轴还没落稳时。）

**两条要留意的新东西**：

1. **200 rpm 冒出了 AS5600 读失败**：同样三段跑 20 遍，100 rpm 活动故障全程 `0x0000`（4 份日志核对），
   **200 rpm 出现 `0x0010`(SENSOR) 3 次**（按 `faults.c:23` 的 1 s 保持窗反推，失败时刻约 t = 36.9 / 49.5 / 50.9 s）。
   → 低速干净**不代表**高速干净。**查清前别上高速。**
2. **单遍耗时几乎不随 rpm 变**：100 rpm 单遍 `5.02 s`，200 rpm 单遍 `5.00 s` —— 只差 0.02 s。
   三段固定 dwell 就占 3.2 s，200 rpm 的 480° 行程本该比 100 rpm 省 0.4 s，**却没省出来**。
   → **"实际有没有跑到设定的 rpm"这件事本轮没有证据**，要独立通道（相机连拍 / 10 ms 级 CAN 采样）才能判。

（日志末尾有单位更正说明）；
报告：同目录 `outputs\工作报告_2026-09-29_三段回零序列200rpm跑20遍.md`。

**收尾时台架状态**：轴停在机械 `−0.172°`，驱动**保持使能顶住**，活动故障 `0x0000`、锁存 `0x0116`；板子队列里**还留着那三段脚本**，没清。

---

## 11. 换一颗电机的完整流程（UART 与 CAN 等价写法）

> 从工程根那份索引文档搬来的（2026-09-29 单一化）。下面的例子是 2026-09-28 换那颗 **11 极对**电机时走的流程。

| 步 | UART（COM15，敲完回车） | CAN（等价） | 应该看到 |
|---|---|---|---|
| 1 | `D` | `0x110` b0=0 | 松开（轴能用手转） |
| 2 | `#11` | `0x116` b0=11、b1..2=0、b4..5=0（或 dlc=4）、**b3 bit0=1** | `CFG: pole_pairs 14 -> 11 (对齐已作废, 请重跑 'A')` 然后 `CFG: 已存 Flash`；CAN 回 `0x184`+`0x182`+`0x181` |
| 3 | `A` | **CAN 没有对齐命令** | `ALIGN: start (motor must be free to move)` → 抖一下 → `MOT: PP check: configured=11 estimated=11 … OK` → `ALIGN: OK` |
| 4 | `F` | `0x112` | 把当前位置当机械 0 点（不需要零点就跳过） |
| 5 | `E` | `0x110` b0=1 | 使能并抱住当前位置 |

- 想连堵转阈值一起设：`#11,2.5`（2.5 A）。只改阈值不改极对数：`#0,2.5`（**不用重跑 `A`**）。
- **换成 36 V 电源**（别忘同步）：`#0,0,36`，或 CAN `0x116` dlc=6、b0=0、b1..2=0、b4..5=3600、b3 bit0=1。**不用重跑 `A`**。
- 三条一起设：`#11,2.5,24`。只想看当前参数：`#`，或 CAN `0x113` b0=3。
- 合法范围：极对数 **1..64**、堵转阈值 **0.1..3.0 A**、母线电压 **8.0..36.0 V**。越界**整条拒绝**，一条都不改。
- 阈值超过 **2.5 A** 会提示 —— DRV8313 自己的峰值限流就在 2.5 A 附近，设更大也没用。
- 母线电压改**小**的时候，相电压上限会**跟着被钳小**（打印 `CFG: voltage_limit 跟着钳到 …`）；改大**不会**自动抬 `L`，要自己 `L`。
- ⚠ **只 `#11` 不重跑 `A` 千万别转**：表现是根本不转 / 原地抖 / 憋着发热，不是"稍微偏一点"。
- 别忘了看现在装的是哪颗：**极对数跟着电机走**。2026-10-06 实测（重跑 `A`，固件自估
  `PP check: configured=11 estimated=11 (moved=0.5476 rad, 31.38 deg mech) OK`）
  **现在装的这颗是 11 极对**；`board.h` 的编译默认 14 是上一颗电机的，别照搬。
  改参数前先 `#` 看一眼。

---

## 12. 已知的小缺口（含已修记录）

> 编号 1~2 是**还没修**的；3~4 已经修好，留在这里当变更记录。

1. ★ **`K` 打印的 `LEC=` 是错的（2026-09-29 复核源码，仍未修）**
   `can_bus.c:673` 用 `errsr & 0x07u` 取 LEC，而 `SRC\Peripheral\inc\ch32l103.h:1356` 定义的是
   `CAN_ERRSR_LEC = 0x70`（**bit[6:4]**）。实测 `ERRSR=0x87000013` 时固件显示 `LEC=0x3`，
   按正确位算 `(errsr >> 4) & 7` = **1（填充错误）**。
   → **看 `K` 的 `LEC` 别信，自己按 bit[6:4] 算。**
2. `CAN命令清单_2026-09-19.md` 里原来漏了 `0x115` —— 本表已补（那份清单后来也补了）；
   那份清单整体已被本表取代，只当历史看。
3. ~~固件帮助里没有 `0x116`~~ —— **2026-09-28 已补**：`H` 现在会打 `0x116` 那一行，
   串口 `#` 的说明也改成了 `#<pp>,<A>[,<V>]`。
4. ~~`CAN_Bus_SendStd()` 的忙等没有"总线明确出错就提前退出"的分支~~ —— **2026-09-29 已修**：
   现在按**时间**有界（`board.h` 的 `CAN_TX_TIMEOUT_US = 2000us`，超时 `CAN_CancelTransmit` 丢帧），
   不再用"空转 200000 圈"兜底。这就是铁律 #9 的根因，已闭环。

---

## 13. 动作的"快慢"由哪些常数决定（2026-10-06 整定，已上机实测）

> 这几项**没有运行时命令**，改不了 Flash，只能改源码重编（本会话用
> 改常量 + 重编 + 重烧）。
> 完整报告：`docs\工作报告_2026-10-06_FOC肉_角度环速度前馈与整定.md`。

| 常数 | 文件 | 现值 | 管什么 |
|---|---|---|---|
| `MOTOR_ANG_FF_GAIN` | `board.h` | **1.0** | 位置环的**轨迹速度前馈**。0 = 退回"纯 P 跟轨迹" |
| `pid_ang_P` / `pid_ang_D` | `foc_pid.c` | **10.0 / 1.0** | 位置环 P / D（D 现在也兼一部分阻尼） |
| `pid_vel_P` / `pid_vel_I` | `foc_pid.c` | **0.3 / 2.0** | 速度环（输出直接是相电压，后面没有电流环） |
| `MOTION_PV_DECEL` | `motion_pv.h` | **300** | 轨迹的加/减速度 `v_ref = sqrt(2*a*err)`，单位 rad/s² |
| `MOTOR_ILIM_KNEE` | `board.h` | **0.75** | 软电流限幅拐点（相电流超过 `0.75 x 堵转阈值` 就把允许相电压线性收到 0） |

**实测（22 V 母线, 30° 阶跃, CAN `0x100`, vlim=600 rpm）**

| 配置 | t90 | t99 | 超调 |
|---|---|---|---|
| 老参数（DECEL=20, Pv=0.1, Pa=10, 无前馈）, 13 V | 418 ms | 498 ms | 3.24% |
| 22 V, DECEL=150, Pa=25, 无前馈 | 136~164 ms | 272~416 ms | 0~0.19% |
| **22 V, DECEL=300, FF=1.0, Pa=10, D=1.0（现用）** | **55 ms** | **171 ms** | **≤0.6%（干净跑）** |
| 22 V, DECEL=500, FF=1.0, Pa=10, D=1.0 | 44 ms | 49 ms | 7.8~11% → 刹不住，否掉 |

**速度环（`0x101` 直给，不经轨迹）**：+200 rpm → t90 **38 ms**；
+700 / +1000 rpm → 峰值 489 / 490 rpm、稳态相电流 ≤2.5 / 2.6 A、**不跳堵转**（软电流限幅在起作用）。

⚠ **"超调"这个数读之前先看有没有踩到反馈跳变**：这台架的 AS5600 **磁铁太弱**
（`Y` 读数 `ML=1 AGC=128`，3.3 V 量程上限就是 128，手册要求落在量程中心），
转动中会 **~0.7 次/秒**出现"一拍跳 100~650 mrad"的假反馈，环路会照着它出力 →
同一套参数的超调能在 0%~71% 之间跳。判据与依据见上面那份报告 §4。
