bjthemost-hub/l103-drv8313-as5600/gearbox-J/图纸与交付说明.md

# 两级行星减速机（外壳 Ø ≤ 56 mm）· 图纸与交付说明

> **数字口径**：本文所有几何/性能数字都是**本次建模算出来的设计值** —— 渐开线解析式 + 多边形精确布尔（shapely）
> + CAD（build123d/OCCT）布尔复核，脚本与校验报告见第 9 节。
> **没有实机打印件，没有测过实际背隙**。全篇唯一标「实测」的是本机对参考工程 FICO-44 的 STL 量测（第 11 节）。
> 打印后实际背隙一定比设计值大 —— 大到多少**我没有数据**，测法见 `注意事项_打印与装配.md` 第 6 节。
>
> **目录怎么读**：`outputs\ring_cont\` 是**连续内齿**（内齿一通到底，好加工，推荐）；
> `outputs\` 下同名的两个目录是**分段内齿**原版，留着做对照。两版只差齿圈（第 10 节）。
>
> **2026-09-29 新增方案 E / F**（`outputs\ring_cont\E_ratio22p22\`、`F_ratio22p22\`）：
> 模数 **0.70 / 0.80**，齿圈外径 **Ø44.458 / Ø49.952**，减速比都是 22.2245 : 1（齿数没变）。
> **E = 小外径版，F = 抗打印变形版**（家人 2026-09-29：比 0.8 模小打印会轻微变形）。
> 两版只差模数 —— **F 是 E 等比放大 8/7**，齿数/变位/齿顶高系数全同（**F 的销轴是 Ø4.06**，见第 8 节）。**只做了连续内齿一种形态**，
> 参数、取舍与对照见**第 12 节**。
>
> **2026-09-29 又新增两版「整数比」方案 G / H**（`outputs\ring_cont\G_ratio22\`、`H_ratio20\`）：
> 两级总减速比是**严格整数 22 : 1 / 20 : 1**，齿圈外径 **Ø51.552 / Ø49.673**（F 是 Ø49.952）。
> 两级齿数不同（G 12-21-54 与 18-18-54；H 12-18-48 与 16-16-48），**两级行星轮是两种零件**，见**第 13 节**。
>
> **2026-09-30 新增方案 J**（`outputs\ring_cont\J_ratio25\`）：**严格整数 25 : 1**，两级**完全同一套齿轮**
> （12-18-48，每级 3 个行星轮），所以**行星轮只有一种零件、共 6 个**，件名与件数跟 C ~ F 完全一样。
> 模数 **0.95**、齿圈外径 **Ø54.811**（≤ 56 还剩 1.19 mm）。见**第 14 节**。
>
> **2026-09-30 又新增方案 K**（`outputs\ring_cont\K_ratio16_4pl\`）：**严格整数 16 : 1**，
> **每级 4 个行星轮**（两级都是 16-16-48，所以两级同件、行星轮共 ×8），模数 **0.95**、
> 齿圈外径 **Ø55.210**（≤ 56 剩 0.79 mm）。16 能整除 4096（4096 / 16 = 256）。见**第 15 节**。
>
> **2026-10-16 新增方案 M**（`outputs\ring_cont\M_ratio25_4pl_4mm\`）：**25 : 1**（与 L 同一套齿数 12-18-48、每级 4 个行星轮），
> **齿轮齿厚 3.10 → 4.00**，**齿圈两端各比齿轮组多留 1.00 mm**（齿圈总高 13.60 = 齿轮组 11.60 + 2 × 1.00，整机总高 28.90）。
> 只动轴向 —— 端面啮合、背隙、总比与 L **逐格相同**，换来**行星轮齿根 45.9 → 35.5 MPa**（同为输出 4 N·m）。见**第 17 节**。
> **2026-10-16 又新增方案 N**（`outputs\ring_cont\N_ratio25_4pl_4mm_thin15\`）：**M 的「背隙收一半」试制版** ——
> 齿形、齿宽、齿圈高度、整机高度与 M **一字不改**，只把**齿厚减薄 thin 从 0.030 收到 0.015**（每侧削 0.0075），
> 齿侧间隙 0.060 → **0.030 mm**，齿顶厚反而涨到 0.678 / 0.822 / 1.022。
> **输出侧空回设计值 17.40′ → 约 8.7′ —— 但这是外推值**：0.015 的减薄已经低于我们多边形模型的解析度，
> 这一版的空回**算不出来**（模型直接给 0），真值要等实测。见**第 18 节**。
>
> **同时修正一处口径**：C / D / E / F 早先的报表把「两级输出空回」那一列填成了**输入侧**的数值
> （两者差一个总减速比）。第 1 / 7 节现在拆成两行写：**输出侧空回 = 输入锁死时输出端能晃多少**
> （这才是装好后用百分表在输出端量到的那个数），输入侧空回 = 输出锁死时输入端的可晃量。

---

## 1. 方案一览，怎么选
（编号 C ~ L 十个：C / D / E / F 是 2026-09-28 那四版，G / H / J / K / L 是后来的整数比版，
> I 只出了解析、没有 CAD。）

| | **方案 E（小外径）** | **方案 F（抗变形）** | **方案 C（强度优先）** | **方案 D（平顺优先）** |
|---|---|---|---|---|
| 两级总减速比 | **22.2245 : 1** | **22.2245 : 1** | **22.2245 : 1** | **20.2500 : 1** |
| 单级减速比 | 4.71429 : 1 | 4.71429 : 1 | 4.71429 : 1 | 4.50000 : 1 |
| 模数 m | **0.70 mm** | **0.80 mm** | 0.90 mm | 0.85 mm |
| 齿数 太阳 / 行星 / 齿圈 | 14 / 19 / 52 | 14 / 19 / 52 | 14 / 19 / 52 | 16 / 20 / 56 |
| 齿圈（=外壳）外径 | **Ø44.458 ≤ 56** ✅ | **Ø49.952 ≤ 56** ✅ | Ø55.443 ≤ 56 ✅ | Ø55.883 ≤ 56 ✅ |
| 齿圈壁厚 | 3.00 mm | 3.00 mm | 3.00 mm | 3.00 mm |
| 齿顶厚 太阳 / 行星 / 齿圈 | 0.496 / 0.477 / 0.657 | **0.571 / 0.550 / 0.755** | 0.524 / 0.572 / 0.853 | 0.542 / 0.526 / 0.772 |
| 太阳轮 Ø5 孔壁 / 行星轮 Ø7 孔壁 | 1.666 / 2.212 | **2.260 / 3.028** | 2.856 / 3.843 | 3.309 / 3.856 |
| 行星架盘 Ø | **33.95** | **38.95** | 44.00 | 44.00 |
| 重合度 太阳-行星 / 行星-齿圈 | 1.361 / 1.836 | 1.361 / 1.836 | 1.452 / 1.870 | 1.545 / 2.123 |
| 单级空回（设计值） | 17.85′ | 15.62′ | 13.89′ | 13.04′ |
| 两级**输出侧**空回（设计值，输入锁死） | 21.64′ | **18.93′** | 16.84′ | 15.94′ |
| 两级**输入侧**空回（设计值，输出锁死） | 102.01′ = 1.70° | **89.25′ = 1.49°** | 79.38′ = 1.32° | 71.73′ = 1.20° |
| 齿面干涉面积（整圈扫描） | 0.000000 mm² | 0.000000 mm² | 0.000000 mm² | 0.000000 mm² |

**一句话**：**要小外径选 E（Ø44.5），要打印保险选 F（Ø50，齿顶 0.55~0.76 mm，0.4 喷嘴也印得出来）；
齿最壮选 C，转得最顺选 D。** 四个方案的零件**互不通用**，文件分目录放。

**E / F 为什么取这两个模数**：E 是"模数 0.65~0.70"那一档里偏保守的一端（0.65 的太阳轮齿顶只有 0.369 mm，
已经窄过 0.4 mm 喷嘴的口径）；F 是"比 0.8 模小打印会变形"这一条的落点 —— 0.80 时三个齿顶
0.571 / 0.550 / 0.755 mm，是四版里齿顶**第二厚**的（仅次于 m = 0.90 的 C），
而且太阳轮 Ø5 孔壁 2.260 mm、行星轮 Ø7 孔壁 3.028 mm 都留足了。
代价是外径 Ø49.952（比 E 大 5.5 mm）、输出侧空回 18.93′（比 E 的 21.64′ 小 2.7′，因为分度圆大了）。
取舍过程与全模数对照表见**第 12 节**。

### 1.1 整数比两版（G / H，2026-09-29 晚）

| | **方案 G（22 : 1）** | **方案 H（20 : 1）** | 参照：方案 F |
|---|---|---|---|
| 两级总减速比 | **22.0000 : 1 = 5.5 × 4.0** | **20.0000 : 1 = 5.0 × 4.0** | 22.2245 : 1（非整数） |
| 模数 m | **0.80**（与 F 同一个模数） | 0.85 | 0.80 |
| 一级 / 二级 齿数 太阳-行星-齿圈 | 12-21-54 / 18-18-54 | 12-18-48 / 16-16-48 | 14-19-52（两级相同） |
| 齿圈（= 外壳）外径 | Ø51.552 ≤ 56 ✅ | **Ø49.673 ≤ 56 ✅**（比 F 还小 0.28） | Ø49.952 |
| 行星轮个数 一级 / 二级 | 3 / 3（共 6 件） | 3 / **4**（共 7 件） | 3 / 3（共 6 件） |
| 齿顶厚（各级最薄那处） | 0.559（一级太阳）/ 0.485（二级行星）mm | 0.597 / 0.507 mm | 0.550 / 0.571 mm |
| 太阳轮 Ø5 孔壁 一级 / 二级 | **1.540** / 3.780 mm | **1.792** / 3.305 mm | 2.260 mm |
| 重合度 太阳-行星 / 行星-齿圈 | 1.269 / 1.750（一级）、1.466 / 1.772（二级） | 1.204 / 1.466（一级）、1.382 / 1.493（二级） | 1.361 / 1.836 |
| 单级空回（设计值） | **15.64′ / 14.33′** | 16.21′ / 15.17′ | 15.62′ |
| 两级输出侧空回（设计值） | **18.24′** | 19.22′ | 18.93′ |
| 齿面干涉面积（整圈扫描） | 0.000000 mm² | 0.000000 mm² | 0.000000 mm² |

**一句话**：**要「比值正好是整数、又最接近 F 的传动比」选 G**（22 : 1，模数与 F 相同、一级 3 个行星轮，
只有 6 个行星轮要打）；**要「外径不许超过 F」选 H**（20 : 1，Ø49.673，比 F 还小一点点；
代价是二级要 4 个行星轮、共 7 件行星轮，一级重合度只有 1.204）。
两版都**不是「把 F 改几个齿」能得到的** —— 原因、以及 21 : 1 为什么只出了解析，见**第 13 节**。

### 1.2 25 : 1 的第三版（J，2026-09-30）

家人 2026-09-30：「行星轮不一样的话比较容易出错，您试试 25 : 1 的，外圈大一点没关系」。
于是有了 **方案 J** —— 三个整数比方案里**唯一做到两级行星轮同一个件**的那个：

| | **方案 J（25 : 1）** | 参照：方案 H（20 : 1） | 参照：方案 F |
|---|---|---|---|
| 两级总减速比 | **25.0000 : 1 = 5.0 × 5.0** | 20.0000 : 1 = 5.0 × 4.0 | 22.2245 : 1（非整数） |
| 模数 m | **0.95** | 0.85 | 0.80 |
| 齿数（两级相同 12-18-48） | 12 / 18 / 48 | 一级 12-18-48、二级 16-16-48 | 14 / 19 / 52 |
| 行星轮 | **只有一种零件，共 6 个**（每级 3 个） | 两种零件、共 7 个 | 一种零件、共 6 个 |
| 齿圈（= 外壳）外径 | **Ø54.811 ≤ 56** ✅ | Ø49.673 | Ø49.952 |
| 太阳轮 Ø5 D 孔壁 | **2.297 mm** | 一级 **1.792 mm** | 2.260 mm |
| 齿顶最薄处 | 0.531（太阳轮）mm | 0.507（二级行星轮）mm | 0.550（行星轮）mm |
| 单级 / 两级输出侧空回（设计值） | **14.49′ / 17.39′** | 16.21′；19.22′ | 15.62′ / 18.93′ |
| 齿面干涉面积（整圈扫描） | 0.000000 mm² | 0.000000 mm² | 0.000000 mm² |

**一句话**：要「**行星轮只有一种、不会装错**，同时减速比是整 25 : 1」就选 J；代价是齿圈 Ø54.811 ——
比 C（Ø55.443）/ D（Ø55.883）小，但比 E / F / G / H 都大（比 F 大 4.86 mm）。
J 的完整参数、为什么只能取 12-18-48、以及把「外圈余量」花在模数上的取舍，见**第 14 节**。

### 1.3 16 : 1 的第四版（K，2026-09-30，每级 4 个行星轮）

家人 2026-09-30：「**4 个行星轮我觉得值得尝试一下**」「**模数可以变的，所有东西都不是一成不变的，减速比要整数比 : 1**」
「**或者能被 360（电机圈数）或者 4096（编码器）整除**」。于是有了 **方案 K** —— 每级 4 个行星轮、总比整 16 : 1。

| | **方案 K（16 : 1）** | 参照：方案 J（25 : 1） | 参照：方案 F |
|---|---|---|---|
| 两级总减速比 | **16.0000 : 1 = 4.0 × 4.0** | 25.0000 : 1 = 5.0 × 5.0 | 22.2245 : 1（非整数） |
| 模数 m | **0.95** | 0.95 | 0.80 |
| 齿数（两级相同） | **16 / 16 / 48** | 12 / 18 / 48 | 14 / 19 / 52 |
| 行星轮个数 一级 / 二级 | **4 / 4**（共 8 个，同一个件） | 3 / 3（共 6 个） | 3 / 3（共 6 个） |
| 齿圈（= 外壳）外径 | **Ø55.210 ≤ 56** ✅ | Ø54.811 | Ø49.952 |
| 行星架盘 Ø | **43.84** | 43.39 | 38.95 |
| 单级 / 两级输出侧空回（设计值） | **13.59′ / 16.98′** | 14.49′ / 17.39′ | 15.62′ / 18.93′ |
| 齿顶厚 太阳 / 行星 / 齿圈 | **0.694 / 0.694 / 0.963 mm** | 0.531 / 0.630 / 0.956 | 0.571 / 0.550 / 0.755 |
| 重合度 太阳-行星 / 行星-齿圈 | 1.257 / **1.301** | 1.324 / 1.530 | 1.361 / 1.836 |
| 齿根弯曲应力 @ 输出 4 N·m | **44.2 MPa** | 75.5 MPa | 未算 |
| 齿面干涉面积（整圈扫描） | 0.000000 mm² | 0.000000 mm² | 0.000000 mm² |

**一句话**：要「**每级 4 个行星轮 + 总比是整数 + 能整除 4096**」就选 K —— 输出侧空回 16.98′ 是**整数比几版里最小的**（G 18.24′ / H 19.22′ / J 17.39′ / L 17.40′；
九版整体最小的是 C 16.84′、D 15.94′）。
齿顶 0.694 mm 是九版里最厚的（0.4 喷嘴很好印），齿根应力只有 J 的 59%。代价是**总比 16 比 J 的 25 小**，
而且**不在最早说的 20~30 区间里**。4 个行星轮为什么把总比顶在 16 / 20 / 25 这三个数上、以及 20 : 1 那一版
为什么这次没做，见**第 15 节**。

### 1.4 25 : 1 的第五版（L，2026-09-30，每级 4 个行星轮）

家人 2026-09-30：「**那就放开 360 度 和 4096 重来**」—— 撤掉「总比必须整除 360（电机圈数）或 4096（编码器）」
这条限制，重做一版 4 个行星轮。放开之后**真正被解锁、而且做得出来的整数比只有 25 = 5 × 5**，
于是有了 **方案 L**：**齿数跟 J 一模一样（12-18-48、m = 0.95），只把每级的行星轮从 3 个加到 4 个**。

| | **方案 L（25 : 1，每级 4 个）** | 参照：方案 J（25 : 1，每级 3 个） | 参照：方案 K（16 : 1，每级 4 个） |
|---|---|---|---|
| 两级总减速比 | **25.0000 : 1 = 5.0 × 5.0** | 25.0000 : 1 = 5.0 × 5.0 | 16.0000 : 1 = 4.0 × 4.0 |
| 模数 m | **0.95** | 0.95 | 0.95 |
| 齿数（两级相同） | **12 / 18 / 48** | 12 / 18 / 48 | 16 / 16 / 48 |
| 行星轮个数 一级 / 二级 | **4 / 4**（共 8 个，同一个件） | 3 / 3（共 6 个） | 4 / 4（共 8 个） |
| 齿圈（= 外壳）外径 | **Ø55.210 ≤ 56** ✅ | Ø54.811 | Ø55.210 |
| 行星架盘 Ø | **43.96** | 43.39 | 43.84 |
| 单级 / 两级输出侧空回（设计值） | **14.50′ / 17.40′** | 14.49′ / 17.39′ | 13.59′ / 16.98′ |
| 齿顶厚 太阳 / 行星 / 齿圈 | **0.660 / 0.806 / 1.007 mm** | 0.531 / 0.630 / 0.956 | 0.694 / 0.694 / 0.963 |
| 重合度 太阳-行星 / 行星-齿圈 | 1.136 / 1.213 | 1.324 / 1.530 | 1.257 / 1.301 |
| 齿根弯曲应力 @ 输出 4 N·m（行星轮） | **45.9 MPa** | 75.5 MPa | 44.2 MPa |
| 齿面干涉面积（整圈扫描） | 0.000000 mm² | 0.000000 mm² | 0.000000 mm² |

**一句话**：**要 25 : 1、又要每级 4 个行星轮**就选 L。齿数跟 J 一字不改，所以空回几乎没变
（14.50′ / 17.40′ vs J 的 14.49′ / 17.39′），但**每根销轴受力 92.0 N → 68.6 N**、
**行星轮齿根应力 75.5 → 45.9 MPa（降到 61%）**、齿顶也全面变厚。
代价：**行星轮 6 → 8 个**、齿圈 Ø54.811 → **Ø55.210**（离 Ø56 只剩 0.79 mm）、
**同一级的 4 个行星轮分两种摆放相位**（差半个齿距，还是同一个件 —— 装的时候对着齿槽插就行）。
它**不整除 360（14.4）也不整除 4096（163.84）** —— 这是「放开这两条」之后才成立的一版。
完整参数、为什么 22 : 1 做不出来、以及相对 J / K 的取舍，见**第 16 节**。

### 1.5 25 : 1 的第六版（M，2026-10-16，齿厚 4 mm、齿圈两端各多留 1 mm）

家人 2026-10-16：「**把齿轮的厚度加到 4mm, 最外圈多留出 1mm 的厚度 就是总超过总高度 2mm**」
（追问后确认：做 **25 : 1 那一版 = 方案 L**，改的是**齿轮齿厚**与**齿圈两端的留量**，不是整机高度）。
于是有了 **方案 M**：**齿数、模数、变位、齿顶高系数、thin、齿圈壁厚、内孔、销轴全部照抄 L**，
只改 `face / planet_w = 4.00` 与 `ring_over = 1.00`（齿圈两端各比齿轮组多留）。

| | **方案 M（25 : 1，齿厚 4 mm）** | 参照：方案 L（25 : 1，齿厚 3.10） |
|---|---|---|
| 两级总减速比 | **25.0000 : 1 = 5.0 × 5.0** | 25.0000 : 1 = 5.0 × 5.0 |
| 模数 / 齿数 | 0.95 / **12-18-48** | 0.95 / 12-18-48 |
| 行星轮个数 一级 / 二级 | 4 / 4（共 8 个，同一个件） | 4 / 4（共 8 个） |
| **齿轮齿厚**（太阳 / 行星 / 齿圈内齿） | **4.00 mm** | 3.10 mm |
| **齿圈长** | **13.60 mm**（齿轮组 11.60 + 两端各 1.00） | 10.70 mm（两端 0.30 / 0.60） |
| **整机总高** | **28.90 mm**（−6.00 … 22.90） | 27.10 mm（−6.00 … 21.10） |
| 齿圈外径 | **Ø55.210 ≤ 56** ✅ | Ø55.210 |
| 齿顶 / 齿根 / 分度（太阳轮） | 13.496 / 9.595 / 11.400 | 同左 |
| 设计背隙 太阳-行星 / 行星-齿圈 | **0.0602 / 0.0600 mm** | 0.0602 / 0.0600 |
| 单级 / 两级输出侧空回 | **14.50′ / 17.40′** | 14.50′ / 17.40′ |
| 齿根弯曲 @ 输出 4 N·m（行星轮） | **35.5 MPa** | 45.9 MPa |
| 每根销轴受力 @ 4 N·m | **68.6 N** | 68.6 N |
| 齿面干涉面积（整圈扫描） | 0.000000 mm² | 0.000000 mm² |

**一句话**：**要把齿做厚（提高齿根强度）、并且要齿圈两端各比齿轮组多留 1 mm** 就选 M。
只动轴向 —— 中心距、齿顶/齿根、齿顶厚、重合度、**背隙与空回与 L 逐格相同**
（跑 `backlash_sweep_int.py` 对出来的：thin 0.030 时两版都是单级 14.50′、输出侧 17.40′、输入侧 86.98′）。
代价：**齿圈 10.70 → 13.60、整机 27.10 → 28.90**，所以**旧 J / L 的端盖盖不住 M，得按 M 的高度重画**；
**M 的 5 个打印件与 L 不通用**（行星轮厚 0.90、齿圈高 2.90、输入太阳轮齿区 3.10 → 4.00）。
完整参数与验证见**第 17 节**。

### 1.6 M 的「背隙收一半」试制版（N，2026-10-16）

家人 2026-10-16：「**0.015 试试来, 在 4mm 的基础上, 我然后打印一个出来 我们测一下**」。
M 的背隙（输出侧 17.40′）里，thin = 0.030 本来就是**专门为打印误差留的**；家人打印机精度较好，想收一半实测一下。
于是有了 **方案 N**：**只把 thin 从 0.030 改成 0.015**，其它一个字没动。

| | **方案 N** | 参照：方案 M |
|---|---|---|
| 齿宽 face / 齿数 / 模数 / 变位 | **4.00 / 12-18-48 / 0.95 / +0.300·+0.075·+0.450** | 完全相同 |
| **thin（每齿削掉总量 / 每侧）** | **0.015 / 0.0075 mm** | 0.030 / 0.015 |
| **齿侧间隙 太阳-行星 / 行星-齿圈** | **0.0302 / 0.0300 mm** | 0.0602 / 0.0600 |
| **两级输出侧空回** | **约 8.7′（外推）** | 17.40′（算出来的） |
| 齿顶厚 太阳 / 行星 / 齿圈 | **0.678 / 0.822 / 1.022 mm** | 0.660 / 0.806 / 1.007 |
| 齿圈 Ø × 长、整机总高 | **Ø55.210 × 13.60、28.90** | 完全相同 |
| 行星轮齿根 @ 输出 4 N·m | **35.0 MPa** | 35.5 MPa |

**关键限制**：我们的空回是用多边形模型（每齿廓 40 段）算的，**thin 0.015 已经低于它的离散误差** ——
`verify_int.py` 对 N 直接给出 `lost motion 0.00000 deg`，**那是假值**。所以 8.7′ 是按 thin 的线性关系
（482.7′/mm，由 0.020 / 0.030 / 0.040 三个实测点定的）**外推**出来的，**必须实测确认**。
这也正是这一版要打出来的理由。细节见**第 18 节**。

## 2. 交付清单

```
outputs\ring_cont\C_ratio22p22\   方案 C（22.2245:1）—— 连续内齿，★ 推荐（好加工）
outputs\ring_cont\D_ratio20p25\   方案 D（20.2500:1）—— 连续内齿，★ 推荐（好加工）
outputs\ring_cont\E_ratio22p22\   方案 E（22.2245:1）—— 连续内齿，**只有这一种形态**
outputs\ring_cont\F_ratio22p22\   方案 F（22.2245:1）—— 连续内齿，**只有这一种形态**
outputs\C_ratio22p22\             方案 C（22.2245:1）—— 分段内齿（原版，保留）
outputs\D_ratio20p25\             方案 D（20.2500:1）—— 分段内齿（原版，保留）
outputs\ring_cont\G_ratio22\      方案 G（**22 : 1 整数比**）—— 连续内齿，2026-09-29 新增
outputs\ring_cont\H_ratio20\      方案 H（**20 : 1 整数比**）—— 连续内齿，2026-09-29 新增
outputs\ring_cont\J_ratio25\      方案 J（**25 : 1 整数比，两级同件**）—— 连续内齿，2026-09-30 新增
outputs\ring_cont\K_ratio16_4pl\  方案 K（**16 : 1 整数比，每级 4 个行星轮，两级同件**）—— 连续内齿，2026-09-30 新增
outputs\ring_cont\L_ratio25_4pl\  方案 L（**25 : 1 整数比，每级 4 个行星轮，两级同件**）—— 连续内齿，2026-09-30 新增
outputs\ring_cont\M_ratio25_4pl_4mm\  方案 M（**25 : 1，每级 4 个行星轮，齿厚 4 mm，齿圈两端各多留 1 mm**）—— 连续内齿，2026-10-16 新增
outputs\ring_cont\N_ratio25_4pl_4mm_thin15\  方案 N（**方案 M 的背隙收一半版，thin 0.015**）—— 连续内齿，2026-10-16 新增（**试制件**）
outputs\ring_cont\J_ratio25_gear_only\  方案 J 的输入轮「只有齿轮」版（无轮毂、无延长端），2026-10-13 新增
outputs\ring_cont\L_ratio25_gear_only\  方案 L 的输入轮「只有齿轮」版（同上，齿厚 3.10），2026-10-16 新增
outputs\ring_cont\M_ratio25_gear_only\  方案 M 的输入轮「只有齿轮」版（同上，齿厚 4.00），2026-10-16 新增
outputs\ring_cont\N_ratio25_gear_only\  方案 N 的输入轮「只有齿轮」版（同上，齿厚 4.00、thin 0.015），2026-10-16 新增
```

**两种齿圈只差"内齿怎么走"，其余 4 种零件完全一样**，详见第 10 节。方案 E / F 只做了连续内齿版，没有分段版。

每个目录里：

| 文件 | 是什么 | 打印几件 |
|---|---|---|
| `01_ring_gear.step/.stl` | **齿圈**（内齿，兼外壳） | 1 |
| `02_planet_gear.step/.stl` | **行星轮**（两级共用同一个件） | **6** |
| `03_input_sun.step/.stl` | **输入太阳轮**（齿轮 + Ø10×6 轮毂，带 Ø5 D 型盲孔） | 1 |
| `04_carrier1_sun2.step/.stl` | **一级行星架**（3 根销轴 + 顶上长着二级太阳轮） | 1 |
| `05_output_carrier.step/.stl` | **二级行星架 + 输出凸台**（Ø8×8） | 1 |
| `00_assembly.step/.stl` | 装配体（**只用来看/检查，不要拿去打印**） | — |
| `图纸1_端面啮合.png` | 1:1 真实齿形端面啮合 + 尺寸标注 | — |
| `图纸2_齿形放大.png` | 太阳-行星、行星-齿圈啮合区放大 | — |
| `图纸3_轴向半剖.png` | 轴向半剖（真实 Z 分层 + 尺寸链） | — |
| `渲染1_剖开轴测.png` | 剖开轴测（齿圈与两个行星架切掉一半） | — |
| `渲染2_爆炸轴测.png` | 爆炸轴测（看两级怎么叠） | — |
| `渲染3_齿圈内齿.png` | 齿圈单件（连续内齿版：看一条通彻的内齿；分段版：看两段内齿带与中段让位孔） | — |
| `渲染4_输入太阳轮D孔.png` | 输入太阳轮（从孔口看 + 轴向剖切，看 Ø5 D 孔） | — |

`outputs\ring_cont\图纸4_方案对照.png` 是 **C / D / E / F / G / H / J / K / L / M 十方案并排对照**（连续内齿版，2026-10-16 重出，
已加 G / H / J / K / L / M 六列；两级齿数不同的方案按「一级 | 二级」分列写）；
`outputs\图纸4_方案对照.png` 是 2026-09-28 的旧版 C/D 两列（分段内齿版）。

**C ~ J 每方案共 10 件塑料件**：齿圈 1 + 行星轮 6 + 输入太阳轮 1 + 行星架 2（**K / L 是 12 件** —— 行星轮 8 个）。
**G / H 的文件名不一样，件数也不同** —— 两级齿数不同，两级行星轮是两种零件：
`01_ring_gear`（1）、`02_planet_s1`（一级行星轮）、`03_planet_s2`（二级行星轮）、`04_input_sun`（1）、
`05_carrier1_sun2`（1）、`06_output_carrier`（1）。**G** = 一级 3 个 + 二级 3 个 = **6 件行星轮（10 件塑料件）**；
**H** = 一级 3 个 + 二级 4 个 = **7 件行星轮（11 件塑料件）**。
**J 与 C ~ F 用的是同一套件名、同一套件数**（`01_ring_gear` / `02_planet_gear` / `03_input_sun` /
`04_carrier1_sun2` / `05_output_carrier`，行星轮 6 个是同一个件，共 10 件塑料件）—— 因为 J 的两级
就是同一套齿轮，不存在「两级不一样」这个出错点。
**K / L / M 也是这一套件名**，区别只有两处：行星轮 **8 个**（一级 4 + 二级 4，都是 `02_planet_gear` 这一种）、
两个行星架各 **4 根销轴**，共 **12 件塑料件**。（M 的齿厚是 4.00，K / L 是 3.10 —— 见第 17 节。）

## 3. 齿轮副参数表

| 参数 | 方案 C | 方案 D | **方案 E** | **方案 F** |
|---|---|---|---|---|---|
| 压力角 α | 20° | 20° | 20° | 20° |
| 模数 m | 0.90 | 0.85 | **0.70** | **0.80** |
| 变位系数 x 太阳 / 行星 / 齿圈 | +0.2012 / −0.0913 / +0.0186 | +0.0842 / −0.0956 / −0.1070 | +0.2000 / −0.0900 / +0.0200 | +0.2000 / −0.0900 / +0.0200 |
| 齿顶高系数 太阳 / 行星 / 齿圈 | 1.05 / 1.15 / 1.00 | 0.95 / 1.05 / 1.00 | 0.95 / 1.10 / 1.00 | 0.95 / 1.10 / 1.00 |
| 中心距 a | **14.94659 mm** | **15.29029 mm** | **11.62519 mm** | **13.28593 mm** |
| 啮合角 α_w | 20.9937° | 19.8998° | 20.9945° | 20.9945° |
| 齿厚减薄 thin（每齿总量） | 0.030 mm（每侧 0.015） | 0.030 mm（每侧 0.015） | 0.030 mm（每侧 0.015） | 0.030 mm（每侧 0.015） |
| 太阳轮 齿顶 Ø / 齿根 Ø | 14.659 / 10.712 | 15.378 / 11.618 | 11.260 / 8.330 | **12.868 / 9.520** |
| 输入太阳轮 轮毂 | Ø10.00 × 6.00，内孔见下 | 同左 | 同左 | 同左 |
| 行星轮 齿顶 Ø / 齿根 Ø / 内孔 Ø | 18.812 / 14.686 / **7.00** | 18.642 / 14.712 / **7.00** | 14.564 / 11.424 / **7.00** | **16.644 / 13.056 / 7.00** |
| 行星轮 齿宽 | **3.10 mm** | **3.10 mm** | **3.10 mm** | **3.10 mm** |
| 行星轮 内孔壁厚（齿根处） | 3.843 mm | 3.856 mm | 2.212 mm | **3.028 mm** |
| 齿圈 内齿顶 Ø / 内齿根 Ø | 45.227 / 49.443 | 45.699 / 49.883 | 35.178 / 38.458 | **40.204 / 43.952** |
| 齿圈 外径 / 长 | 55.443 / 10.70 | 55.883 / 10.70 | 44.458 / 10.70 | **49.952 / 10.70** |
| 行星轮个数 / 每级；销轴 Ø | 3；3.60 | 3；3.60 | 3；3.60 | 3；**4.06** |
| 行星架盘 Ø / 厚 | 44.00 / 3.00 | 44.00 / 3.00 | 33.95 / 3.00 | **38.95** / 3.00 |
**输入太阳轮的 Ø5 D 型孔**（这是你点名要的）：带宽（圆孔部分）**Ø5.00**，
D 平面到轴心 **2.00 mm** —— 也就是**对面距 4.50 mm**，等于一根 Ø5 轴削掉 **0.50 mm**；
**孔深 8.00 mm**（你要 ≥5），盲孔顶留 **1.10 mm** 壁；孔口 **0.55×45° 倒角**。
孔壁到齿根 2.856 mm（C）/ 3.309 mm（D）/ 1.666 mm（E）/ **2.260 mm（F）**。
（G / H / J 的孔壁见第 13 / 14 节：G 一级 1.540、H 一级 1.792、**J 2.297 mm**。）

## 4. 轴向尺寸链（Z 从「一级行星轮下平面」= 0 算起，单位 mm）

| 层 | Z 范围 | 说明 |
|---|---|---|
| 输入太阳轮 轮毂 | −6.00 … 0 | Ø10.00，Ø5 D 孔从这里往上钻 8.00 |
| 一级太阳轮齿 | 0 … 3.10 | 齿顶 Ø14.659（C）/ Ø15.378（D）/ Ø11.260（E）/ Ø12.868（F） |
| **一级行星轮 ×3** | **0 … 3.10** | 齿宽 3.10，内孔 Ø7.00 |
| 一级销轴（属一级行星架） | 0 … 3.40 | Ø3.60（**方案 F：Ø4.06**），穿在行星轮 Ø7 内孔里 |
| 一级行星架盘 | 3.40 … 6.40 | Ø44.00 × 3.00（**E Ø33.95 / F Ø38.95 / G Ø40.63 / H Ø38.69 / J Ø43.39**） |
| 二级太阳轮齿（长在一级架上） | 5.50 … 9.80 | 下沉 **1.20** 嵌进架盘（不是细颈连接） |
| **二级行星轮 ×3** | **6.70 … 9.80** | 与一级同一件 |
| 二级销轴（属二级行星架） | 6.70 … 10.10 | Ø3.60（**方案 F：Ø4.06**） |
| 二级行星架盘 | 10.10 … 13.10 | Ø44.00 × 3.00（**E Ø33.95 / F Ø38.95 / G Ø40.63 / H Ø38.69 / J Ø43.39**） |
| 输出凸台 | 13.10 … 21.10 | Ø8.00 × 8.00 |
| **齿圈** | **−0.30 … 10.40** | 长 10.70；连续版内齿 −0.30…10.40 一通到底 / 分段版两段 −0.30…3.40、6.40…10.10 |
| ↳ 齿圈中段 | 3.40 … 6.40 | （**分段内齿版**才有这个让位孔：Ø49.443(C) / Ø49.883(D)，避让 Ø44 架盘，单边 2.722 / 2.942）；连续版这一段也是内齿 |
| **整机总高** | **−6.00 … 21.10** | **27.10 mm** |

行星轮上下各留 **0.30 mm** 轴向间隙（打印件不会靠层纹打架）。

> **方案 E / F 的差别**：这套 Z 分层**完全没变**（总高仍 27.10 mm），变的只是跟着齿圈缩的直径 ——
> 太阳轮齿顶 Ø11.260(E) / Ø12.868(F)、**两个行星架盘 Ø33.95(E) / Ø38.95(F)**（不是 Ø44）、
> 齿圈 Ø44.458(E) / Ø49.952(F)。齿圈仍是 −0.30…10.40 连续内齿。
>
> **G / H / J 同理**：Z 分层一模一样，变的只是直径 —— 两个行星架盘 **G Ø40.63 / H Ø38.69 / J Ø43.39**，
> 齿圈 Ø51.552(G) / Ø49.673(H) / **Ø54.811(J)**。
>
> **K / L 同理**：Z 分层也一模一样（总高 27.10），架盘 Ø43.84(K) / Ø43.96(L)，齿圈 Ø55.210。
>
> **方案 M（2026-10-16）不一样 —— 它的 Z 分层自己一套**（齿厚 3.10 → 4.00，齿圈两端各多留 1.00）：

| 层 | Z 范围 | 说明 |
|---|---|---|
| 输入太阳轮 轮毂 | −6.00 … 0 | Ø10.00，Ø5 D 孔往上钻 **8.90**（齿面下留 1.10 顶壁） |
| 一级太阳轮齿 / **一级行星轮 ×4** | 0 … **4.00** | 齿厚 4.00；一级销轴 0 … 4.30 |
| 一级行星架盘 | 4.30 … 7.30 | Ø43.96 × 3.00 |
| 二级太阳轮齿 / **二级行星轮 ×4** | 7.60 … **11.60** | 二级销轴 7.60 … 11.90 |
| 二级行星架盘 | 11.90 … 14.90 | Ø43.96 × 3.00 |
| 输出凸台 | 14.90 … 22.90 | Ø8.00 × 8.00 |
| **齿圈** | **−1.00 … 12.60** | **长 13.60**（连续内齿，一通到底） |
| **整机总高** | **−6.00 … 22.90** | **28.90 mm** |

> M 的**齿轮组** = 0.00 … 11.60（长 11.60），齿圈 −1.00 … 12.60 **两端各多 1.00**，
> 所以齿圈总高 13.60 = 11.60 + 2 × 1.00 —— 这就是家人要的「总超过总高度 2 mm」。
> 一级行星轮上端与一级行星架盘下平面之间仍留 0.30 轴向间隙（`gap = 0.30`，与 L 同一口径）。

## 5. 要你自己画的两端（接口边界）

外壳两端按你的要求**没有做**，但边界定死了：

- **输入端**：太阳轮轮毂下端面在 **Z = −6.00**，外径 **Ø10.00**；
  孔口倒角 **Ø6.10 × 45°**（0.55 mm）。端盖上给它的让位建议 ≥ Ø10.2，轴向别顶到轮毂端面（留 0.2~0.3）。
- **输出端**：输出凸台 **Ø8.00 × 8.00**，凸台顶在 **Z = 21.10**；二级行星架盘外径 **Ø44.00**（**方案 E：Ø33.95**，**方案 F：Ø38.95**），
  盘顶面 Z = 13.10。端盖上要有 Ø44 的让位腔 + Ø8 的输出轴孔（或直接做成推力面压住架盘）。
  （架盘外径按方案变：**E Ø33.95 / F Ø38.95 / G Ø40.63 / H Ø38.69 / J Ø43.39**，让位腔按对应值留。）
- **夹紧**：整套的轴向定位靠两个端盖把 **齿圈两端面（Z = −0.30 / 10.40）** 和
  **二级架盘顶面 / 太阳轮轮毂端面** 夹住 —— 端盖要能把齿圈压死（齿圈是固定件，不是转动的）。
- **齿圈外侧**：Ø55.443(C) / Ø55.883(D) / **Ø44.458(E)** / **Ø49.952(F)** / Ø51.552(G) / Ø49.673(H) / **Ø54.811(J)**，
  长 10.70，外圆是光面，可直接做你的外壳上的夹持台阶。

## 6. 装配相位（不用你找相位）

- 相位已经烘进零件：按 STEP 的方位装入即可，**齿圈不能反过来装**。
- 同一级的 3 个行星轮相位本来相同，6 个行星轮是同一个件，插进去自然对。
- 装配保证条件：(Zs + Zp) % 3 == 0 —— C (14+19)%3 = 0 ✅，D (16+20)%3 = 0 ✅，E (14+19)%3 = 0 ✅、F (14+19)%3 = 0 ✅（与 C 同齿数）。
  （做不到 0 就不能用 3 个均布行星轮。）
- **G / H 也满足**：G 一级 (12+21)%3 = 0、二级 (18+18)%3 = 0；H 一级 (12+18)%3 = 0，
  二级 4 个行星轮要 (16+48)%4 = 0 ✅（4 个均布 90°）。
- **G / H 的行星轮相位按级分开**：两级行星轮齿数不同（G 21 / 18，H 18 / 16），所以两级行星轮**零件不同、相位也不同**
  （G 一级 17.1429° / 二级 0.0000°；H 一级 10.0000° / 二级 11.2500°）；二级太阳轮长在一级行星架上，
  相对齿圈还多烘了一个相位（**G −30.0000° / H −22.5000°**），不烘这一下二级两处啮合的相位对不上。
  这些都做进零件了，**照 STEP 方位装就行，不用自己找相位**。
- **M 与 L 是同一套齿数**（12-18-48、每级 4 个），所以相位关系与 L 完全相同：4 个行星轮
  **10.0000° × 2 / 0.0000° × 2**（两组，差半个齿距 = 10°），齿圈烘入 **60.0000°**，两级太阳轮各烘入 **10.0000°**；
  4 个轮仍是**同一个件**，插进去只有一种角度能落到位。`design_v3.py` 重跑输出的 `phi_sun` 就是
  **10.0000 / 0.0000 / 10.0000 / 20.0000**（`20.0000 ≡ 0.0000`，同一个齿距相位）。
- **J 是两级完全相同的一套齿轮**，所以两级的行星轮相位都一样（**10.0000°**），齿圈烘入 **60.0000°**，
  二级太阳轮烘入 **10.0000°** —— 两级之间没有「不一样」的相位要照顾。6 个行星轮是同一个件，随便插。
- 装配顺序见 `注意事项_打印与装配.md` 第 4 节。
- **方案 M（2026-10-16）的边界不一样，单独记一笔**：输入端轮毂端面仍在 **Z = −6.00**、外径 Ø10.00；
  输出凸台仍 Ø8.00 × 8.00，但凸台顶到 **Z = 22.90**（二级架盘顶面 **Z = 14.90**，架盘 Ø43.96）；
  **齿圈 Ø55.210、长 13.60，两端面在 Z = −1.00 / 12.60** —— 夹紧面就从这两个面改成了这两个。
  因此**旧 J / L 的端盖盖不住 M**，端盖要按 M 的这三个高度重画。

## 7. 背隙：设计值 vs 打印后（老实说）

**本设计给的是「设计背隙」**（多边形最小间隙 + 齿厚减薄 thin = 0.030 mm/齿 算出来的）：

| | 太阳-行星 | 行星-齿圈 | 单级空回 | 两级**输出侧**空回 | 两级**输入侧**空回 |
|---|---|---|---|---|---|
| 方案 C | 0.0602 mm | 0.0599 mm | 0.23151° = **13.89′** | 16.84′ | 79.38′ = 1.32° |
| 方案 D | 0.0601 mm | 0.0555 mm | 0.21735° = **13.04′** | 15.94′ | 71.73′ = 1.20° |
| **方案 E** | 0.0601 mm | 0.0599 mm | 0.29753° = **17.85′** | 21.64′ | 102.01′ = 1.70° |
| **方案 F** | 0.0601 mm | 0.0599 mm | 0.26031° = **15.62′** | **18.93′** | **89.25′ = 1.49°** |
| **方案 G** | 0.0600 / 0.0602 mm | 0.0600 / 0.0600 mm | **15.64′ / 14.33′** | **18.24′** | 72.97′ = 1.22° |
| **方案 H** | 0.0602 / 0.0601 mm | 0.0600 / 0.0600 mm | **16.21′ / 15.17′** | 19.22′ | 76.87′ = 1.28° |
| **方案 J** | 0.0601 mm | 0.0599 mm | **14.49′** | **17.39′** | **86.94′ = 1.45°** |

「单级空回」= 太阳和齿圈都固定、行星架还能正反摇摆的总角度（G / H 那两列是「一级 / 二级」两个数）；
「输出侧空回」= **输入锁死时输出端能晃多少** = 二级空回 + 一级空回 / 二级单级比；
「输入侧空回」= 输出锁死时输入端的可晃量，比输出侧大**单级减速比**倍
（C / E / F 是 4.71429 倍、D 是 4.5 倍、**G / H / J 看各自的二级单级比：G 4.0、H 4.0、J 5.0**；
**不是**总减速比 —— 拿 C 对一下：79.38′ / 16.84′ = 4.714）。
**这两个别混**：早先 C~F 的报表把输入侧的数值填在了「输出空回」那一列（数值差 4.5~4.7 倍），2026-09-29 已改；
装好后在输出端量到的是**输出侧**那个数。
（背隙是**圆周向**在行星轮节圆 r = m·Zp/2 处量的。）

**方案 E / F 自己的 thin ↔ 背隙表**：见**第 12.4 节**（E 和 F 是等比关系，同一个 thin 对应的
空回角度比就是 0.8 : 0.7 —— E 的输入侧 102.0′ 对应 F 的输入侧 89.3′，E 的输出侧 21.6′ 对应 F 的 18.9′）。

> thin = 0.015 那一行没列：这个值已经低于多边形模型的解析度（算出来是 0.000°，显然不真实），
> 想要更紧的配合得靠打样实测，不能信表里的数。

**为什么不用更小的 thin**：那等于把齿做满、理论零背隙，FDM 打出来几乎必然咬死。
想更紧：先把 0.030 这一套打出来实测，再决定降一档还是两档 —— 说一句我重出（改一个数，几分钟）。

## 8. 销轴 vs 轴承内孔

**2026-09-29 家人指定：销轴做 Ø4.06。** 方案 **F / G / H / J** 都已按 **Ø4.06** 出（销轴长 3.40，
穿在行星轮 Ø7.00 内孔里，径向间隙 1.47 mm）—— F 是 `04`/`05`，G / H 是 `05`/`06`，J 又是 `04`/`05`。
C / D / E 三个方案仍是 **Ø3.60**（径向 1.70 mm），没有跟着改 ——
**各方案的架盘外径和销轴都不一样，零件不能互换**。

背景（最早那版的两句话对不上）：家人原文写「行星轮的内径在 **3.6 mm**（装一个外径 **7 mm** 的轴承）」。
行星轮内孔 **Ø7.00** 是为装**外径 7 mm** 的轴承（内孔壁在齿根处 F 3.028 mm / E 2.212 mm）；
但 Ø7 外径的微型轴承常见的是 **683ZZ（内孔 3 × 外径 7 × 厚 3）**，"外径 7 + 内孔 3.6" 的型号我没查到。

| 你手上那个 Ø7 轴承的内孔 | 现在这套能不能用 |
|---|---|
| **4.06**（给定值） | ✅ 直接用，`04`/`05` 上的 Ø4.06 销轴正好 |
| **4.0**（MR74ZZ 4×7×2.5 那类） | ⚠️ 标称 Ø4.00 的孔配 Ø4.06 的销轴是**过盈**（0.06 mm）—— 打印件销轴一般还会偏粗，多半插不进；要留间隙就把销轴改小，说一声 |
| **3.0 / 3.6**（683ZZ 那类） | ❌ Ø4.06 插不进去，得改销轴直径（几分钟，只动两个架，行星轮不动） |

**建议先用卡尺量一下手上那个 Ø7 轴承的内孔再开打。** 行星轮本身（Ø7.00 内孔）三种情况都能用，不用改。
另外：如果轴承厚 **2.5**（不是 3），行星轮内孔深 3.10 会有 **0.6 mm** 轴向活动量 —— 加薄垫片，或告诉我按 2.5 改孔深。

## 9. 文件与脚本索引 / 校验报告

- `outputs\验证报告_C-D_设计与CAD对照.txt`（分段版）/ `outputs\ring_cont\验证报告_连续内齿_设计与CAD对照.txt`
  —— 剖面积对照、30 对两两体积交、齿圈与两个行星架的两两交、轴向间隙、整圈运动扫描、空回、需求核对
- `outputs\验证报告_C-D_导出文件检查.txt` / `outputs\ring_cont\验证报告_连续内齿_导出文件检查.txt`
  —— 每个 STL 的封闭性（开放/非流形边）、每个 STEP 的回读体积
- `outputs\ring_cont\验证报告_连续内齿_整数比方案.txt`（脚本 `work\verify_int.py`，跑法 `verify_int.py C D E F G H J K L M N`）
  —— 含 **C / D / E / F / G / H / J / K / L / M / N 十一套**（2026-10-16 重出，加了 M 与 N）
  —— **N 的空回那一项是假值 0.00000**（减薄量低于模型解析度），只有齿侧间隙可信，见第 18.2 节
  —— **整数比方案专用**：逐级剖面积对照 / 两两 CAD 布尔交 / 逐级干涉与整圈扫描 / 逐级背隙与两级空回 / 需求核对
- `work\design_v3_report.txt` / `design_v3.json` —— **十二套**方案（C / D / E / F / G / H / I / J / K / L / M / N）的完整参数与解析验证
  （一条命令全出：`.\venv\Scripts\python.exe design_v3.py`；只要几套就写方案字母，如 `design_v3.py G H`）
- `work\backlash_table_int.txt`（脚本 `work\backlash_sweep_int.py`）—— **C / D / E / F / G / H / J / K / L / M 十套**的
  thin ↔ 背隙表，**两级分开列**，并给出两级合并的输出侧 / 输入侧空回（2026-10-16 重出，加了 M；**M 与 L 逐格相同**）
- `work\backlash_table_v3.txt` —— 旧版（只有 C / D / E / F，单级口径）
- `outputs\ring_cont\验证报告_方案M_齿根弯曲应力.txt`（脚本 `work\_m_stress.py`）—— M 的齿根弯曲网格表 + 许用反推
- `outputs\ring_cont\验证报告_方案N_齿根弯曲应力.txt`（脚本 `work\_n_stress.py`）—— N 的齿根弯曲网格表 + 许用反推
- `outputs\ring_cont\N_ratio25_4pl_4mm_thin15\说明_方案N_thin0015_背隙一半.md` /
  `工作报告_2026-10-16_方案N_背隙收一半.md` —— N 的交付说明与流水账（**试制版，等实测**）
- `outputs\ring_cont\M_ratio25_4pl_4mm\说明_方案M_齿厚4mm.md` /
  `工作报告_2026-10-16_方案M_齿厚4mm齿圈加长.md` —— M 的交付说明与流水账
- 生成脚本（都在 `work\`）：`build_mode.py`（**分段 / 连续内齿的切换，一个环境变量**）、
  `part_layout.py`（**唯一的 Z 分层 + 内齿带定义**，零件与图纸共用）、`gear_mk.py`（渐开线齿廓）、
  `cad_geom.py`（同齿廓的样条+圆弧版，STEP 小、齿面光滑）、`stage_lib.py`（shapely 装配/干涉/背隙）、
  `design_v3.py`、`scan5.py`（56 mm 内的可行齿数组合全扫，365 组）、`build_parts.py`（build123d 建模导出）、
  `verify_v3.py`、`check_exports_v3.py`、`draw2d.py`（2D 图纸）、`softrender.py` + `render3d.py`（3D 渲染）
- 复现（分段齿圈版）：`cd work` → `.\venv\Scripts\python.exe design_v3.py` → `build_parts.py` → `verify_v3.py` → `draw2d.py` → `render3d.py`
- 复现（连续内齿版）：先 `$env:PLANETARY_RING="cont"`，再跑上面同样 5 条命令 —— 产物全部落到 `outputs\ring_cont\`（不会覆盖原版）

**校验结果摘要**（都是上面脚本跑出来的）：

| 项目 | 结果 |
|---|---|
| 30 对两两 CAD 布尔交 | 最大 \|体积\| = **0.000000000 mm³**（无干涉） |
| 整圈运动扫描（一个齿距/240 步 + 整圈/720 步） | 三相干涉全 **0.000e+00 mm²** |
| 剖面积：CAD vs 多边形模型 | 齿圈 −0.0024%，行星轮 +0.0026%，太阳轮 −0.0077%<br>方案 E：齿圈 −0.0016%，行星轮 −0.0102%，太阳轮 −0.0190%；方案 F：齿圈 −0.0018%，行星轮 −0.0093%，太阳轮 −0.0177% |
| 七个方案共 **44 个 STL** | 开放/非流形边 **= 0**，可直接切片（C / D / E / F / G / H / J 全查了，每方案 6~7 个） |
| 七个方案共 **44 个 STEP** | 全部回读成功，`solids=1`（零件）/ `10`（装配）/ `11`（H 的装配：二级 4 个行星轮）；体积与逐件求和一致（最大差 0.0003 mm³） |
| 单套 5 种件的体积（STEP 精确值） | 连续内齿版：C **18581.1** / D **18678.7** / E **12439.7** / F **15393.9 mm³**；分段内齿版：C 18058.5 / D 18170.3 mm³ |
| 整机（1 齿圈 + 1 太阳 + 6 行星 + 2 架） | 连续内齿版：C **21361.24** / D **21427.41** / E **13875.57** / F **17456.69 mm³**；分段内齿版：C 20842.98 / D 20923.42 mm³ |
| G / H（整数比：1 齿圈 + 2 太阳 + 3+3 / 3+4 行星 + 2 架） | G 整机 **18607.95 mm³**（单套 6 种件 16829.10，`solids=10`）；H 整机 **17608.83 mm³**（单套 15795.69，`solids=11`） |
| G / H / J 的两两 CAD 布尔交与整圈扫描 | G 30 对 / H 37 对 / J 30 对，最大 \|体积\| = **0.000000000 mm³**；三相干涉全 **0.000e+00 mm²** |
| J（25 : 1 两级同件：1 齿圈 + 1 太阳 + **6 个同件行星轮** + 2 架） | 整机 **21050.99 mm³**（单套 5 种件 18235.62，`solids=10`） |

> 体积是 CAD 算出来的**几何体积**。**要打多少克丝、打多久，我这里没有数**（那得真切片才知道）——
> 需要的话我可以用本机切片器给你跑一份预估（带时间和克数）。

## 10. 齿圈内齿的两种做法：分段 / 连续

家人提出：内齿中间那条让位台阶**加工不出来**，要一通到底。于是同一套设计出两版齿圈：

| | **连续内齿（推荐）**<br>`outputs\ring_cont\...` | **分段内齿（原版）**<br>`outputs\...` |
|---|---|---|
| 内齿 Z 范围 | **−0.30 … 10.40，整条 10.70 一通到底** | 两段：−0.30…3.40、6.40…10.10 |
| 中段 3.40…6.40 | 也是内齿 | Ø49.443(C)/Ø49.883(D) 让位孔（+顶部 10.10…10.40 让位台阶） |
| 加工 | **一次走刀/一次插齿就能做出整条内齿** | 要分两段走刀，中段还要单独镗让位孔 |
| 齿圈体积（设计值） | C 7221.328 / D 7218.542 / **E 5343.902 / F 6258.506** mm³ | C 6625.274 / D 6637.020 mm³ |
| 一级行星架盘（Ø44）与内齿顶的径向间隙 | **C 0.6133 / D 0.8493 / E 0.6142 / F 0.6269 mm**（设计值，CAD 布尔实测 0 干涉） | 相对让位孔 2.722 / 2.942 mm |

**两版都做了同样完整的校验**（各自的 `验证报告_*.txt`）：30 对两两布尔交 = 0、
齿圈/太阳轮/两个行星架两两布尔交 = 0、整圈运动扫描 0、空回与背隙一样。
**（方案 E / F 只做了连续内齿这一种形态，没有分段版。）**

**零件只有齿圈不同，其余 4 种可以互换**（行星轮 6 个、输入太阳轮、两个行星架，两版通用）。

> **目录名为什么叫 `ring_cont` 而不写中文**：本机实测（2026-09-28）`build123d.export_stl()`
> 在**中文路径下会静默不写文件**（不报错、`os.path.exists()` 为 False，同一文件写 ASCII 目录就正常）；
> `export_step()` 不受影响。所以这台机器上用 build123d 导 STL，**路径里别带中文**。

---

## 11. 参考件 FICO-44 的实测（本机量的，只读未改）

参考工程 FICO-44 位于本机独立目录（**只读，全程没改它**）。
本机量测（脚本 `work\analyze_stl.py` 等，报告 `work\stl_report*.txt`）：

- 两级、标称减速比 30、全部 3D 打印（PLA / Ender-3S）
- `44wcq.stl` 外齿圈：**外径 52.00 mm，m = 2.0，Zr = 18**
- 第一级行星轮齿宽 **2.895 mm**

本设计相对它的改进：同样卡在 ≤56 mm 里，齿宽从 2.895 加到 **3.10**，
减速比按你后来的要求落在 **22.22 / 20.25**（而不是硬顶到 30+），并且做了完整的干涉/背隙/导出校验。
---

## 12. 方案 E（m = 0.70）与方案 F（m = 0.80）—— 2026-09-29 新增的两版

家人 2026-09-29 先要“模数在 0.65 ~ 0.70 之间”，出了 **方案 E（m = 0.70，齿圈 Ø44.458）**；
随后提到“**比 0.8 模小的话打印出来会轻微变形**”，于是又出了 **方案 F（m = 0.80，齿圈 Ø49.952）**。
两个都留着：**要小外径用 E，要打印保险用 F**（建议先打一套 F 试）。

两版的**齿数、变位、齿顶高系数、啮合角、重合度完全一样** —— F 就是 E 按 **8/7** 等比放大，
所以减速比一致（22.2245 : 1）；不一样的只有尺寸、壁厚 / 齿顶厚（一起变厚），以及同一个 `thin`
折算出的空回角度（**F 比 E 小 12.5%**，就是 7/8）。唯一“不严格等比”的地方是 `thin = 0.030 mm`
这个绝对量不跟着放大，对 F 反而有利：太阳轮齿顶 0.571 mm，比严格按 8/7 折算的 0.566 mm 略厚。

### 12.1 模数怎么定：先把模数往下扫一遍

把方案 C 的齿数 / 变位 / 齿顶高系数整套固定住，只把模数往下扫（脚本 `work\probe_module.py`，
原始输出 `work\probe_module_out.txt`）：

| 模数 m | 齿圈外径 | 齿顶厚 太阳 / 行星 / 齿圈 | 太阳轮 Ø5 孔壁 | 行星轮 Ø7 孔壁 | 两级**输入侧**空回（thin=0.030） |
|---|---|---|---|---|---|
| 0.90（= 方案 C） | 55.443 | 0.524 / 0.572 / 0.853 | 2.856 | 3.843 | 79.4′ |
| 0.80 | 49.950 | 0.462 / 0.504 / 0.755 | 2.261 | 3.027 | 89.3′ |
| 0.75 | 47.203 | 0.431 / 0.471 / 0.706 | 1.963 | 2.619 | 95.2′ |
| 0.70 | 44.456 | 0.400 / 0.437 / 0.657 | 1.666 | 2.211 | 102.0′ |
| 0.65 | 41.709 | 0.369 / 0.404 / 0.608 | 1.368 | 1.803 | 109.9′ |
| 0.60 | 38.962 | 0.338 / 0.370 / 0.559 | 1.071 | 1.395 | 119.0′ |

（全是**设计计算值，未实测**。这一扫统一用 **C 的齿顶高系数 1.05 / 1.15** —— 所以 0.80 那行的齿顶厚是
0.462 / 0.504 mm；后面真正交付的 **F 把太阳 / 行星的齿顶高系数改成 0.95 / 1.10**，
齿顶因此变厚到 **0.571 / 0.550 mm**，比表里这行好。）

**齿数不变时，齿圈外径基本与模数成正比** —— 想小就能小，但一起变小的还有壁厚和齿顶厚：

- **打印下限**：齿顶厚就是齿最尖处的宽度。0.65 时太阳轮齿顶只有 0.369 mm，**比 0.4 mm 喷嘴口径还窄**，
  这种齿顶尖 FDM 印不出方角（会圆头甚至缺料）。（“齿顶厚 ≥ 喷嘴口径”是**推论，不是实测**；
  0.4 喷嘴的话 0.80 这一档（0.55 ~ 0.76 mm）是稳的，0.70 及以下要试。）
- **Ø5 D 孔壁**：0.65 只剩 1.368 mm 要传全部输入扭矩；0.70 有 1.666 mm；**0.80（F）有 2.260 mm**。
- **背隙反而变差**：圆周背隙是 `thin` 这个**绝对毫米数**定死的，同一个毫米误差落在更小的分度圆上 =
  更大的转角 —— 两级**输入侧**空回从 0.90 的 79.4′ 涨到 0.70 的 102.0′
  （换成输出侧就除以单级比 4.71429：16.8′ → 21.6′；同一列里两级的数都按这个比值走）。**打印公差也是绝对毫米量，
  同样会被小模数放大**；这条和“背隙越小越好”是冲突的，是选小外径必须付的价。

### 12.2 为什么最后落在 m = 0.80（F）

家人 2026-09-29 的反馈：**比 0.8 模小打印会轻微变形**。这条把下限钉在 0.80，于是：

- 三个齿顶厚 **0.571 / 0.550 / 0.755 mm** —— 四版里仅次于 C（m = 0.90），0.4 mm 喷嘴印方角有余量；
- 太阳轮 Ø5 孔壁 **2.260 mm**、行星轮 Ø7 孔壁 **3.028 mm**（对比 E 的 1.666 / 2.212 —— 那是 E 最弱的地方）；
- 代价：齿圈外径 **Ø49.952**（比 E 大 5.494 mm，仍远小于 56 的上限）、**输入侧**空回 89.3′
  （比 E 的 102.0′ 小 12.7′；换成输出侧是 F 18.9′ 对 E 21.6′）。

**为什么不再往上取 0.90（也就是 C 的模数、齿顶最厚）**：齿圈外径会顶到 Ø55.443，离 56 的上限只剩 0.557 mm；
家人要的是“小一点”，所以停在 0.80。C 也还在（同一个 `VARIANTS` 字典里），想要最壮的齿就用它。

### 12.3 最终参数（E 与 F 并列）

| 参数 | 方案 E | 方案 F |
|---|---|---|
| 模数 m / 齿数 | 0.70 / **14 – 19 – 52** | 0.80 / **14 – 19 – 52** |
| 两级总减速比 | **22.2245 : 1** | **22.2245 : 1** |
| 变位 x 太阳 / 行星 / 齿圈 | +0.2000 / −0.0900 / +0.0200 | +0.2000 / −0.0900 / +0.0200 |
| 齿顶高系数 太阳 / 行星 / 齿圈 | 0.95 / 1.10 / 1.00 | 0.95 / 1.10 / 1.00 |
| 中心距 a | **11.62519 mm** | **13.28593 mm** |
| 啮合角 α_w / 中心距变动 dy | 20.9945° / +0.10742 m | 20.9945° / +0.10742 m |
| 齿顶厚 太阳 / 行星 / 齿圈 | 0.496 / 0.477 / 0.657 mm | **0.571 / 0.550 / 0.755 mm** |
| 重合度 太阳-行星 / 行星-齿圈 | 1.361 / 1.836 | 1.361 / 1.836 |
| 太阳轮 齿顶 Ø / 齿根 Ø | 11.260 / 8.330 | 12.868 / 9.520 |
| 太阳轮 轮毂 Ø / Ø5 孔壁 | Ø10.00 / 1.666 | Ø10.00 / **2.260** |
| 行星轮 齿顶 Ø / 齿根 Ø / 内孔 / 齿宽 | 14.564 / 11.424 / **7.00** / **3.10** | 16.644 / 13.056 / **7.00** / **3.10** |
| 行星轮 Ø7 孔壁（齿根处） | 2.212 | **3.028** |
| 齿圈 内齿顶 Ø / 内齿根 Ø / 外径 | 35.178 / 38.458 / **44.458** | 40.204 / 43.952 / **49.952** |
| 齿圈 长 / 壁厚 | 10.70 / 3.00 | 10.70 / 3.00 |
| 一级 / 二级行星架盘 Ø | **33.95** | **38.95** |
| 架盘 vs 齿圈内齿顶 让位（单边） | 0.614 mm | 0.627 mm |
| 齿顶间隙 行星顶/齿圈根、太阳顶/行星根 | +0.322 / +0.283 mm | +0.368 / +0.324 mm |
| 销轴 Ø / 每级行星轮个数 | 3.60 / 3 | **4.06** / 3 |
| 行星轮分布圆 Ø（= 2a） | Ø23.250 | Ø26.572 |
| 相邻两行星轮中心距 2·a·sin60° | 20.135 mm | 23.011 mm |
| 相邻行星轮净间隙 | 5.572 mm | 6.368 mm |
| 太阳轮 Ø5 D 孔 | Ø5.00，D 面到轴心 2.00（对面距 4.50），深 8.00 | 同左 |
| 轴向分层（太阳轮毂底 −6.00 … 输出凸台顶 21.10） | 27.10 mm | 27.10 mm |

**换模数不是只改一个数**：`work\part_layout.py` 里的行星架盘外径原来是常数 44.00（按 Ø45.227 的内齿顶定的）。
E / F 的齿圈内齿顶只有 Ø35.178 / Ø40.204，架盘得跟着缩到 **Ø33.95 / Ø38.95**（单边让位 0.614 / 0.627 mm，
和 C 的 0.613 同一个口径）。轴向那套 27.10 mm 的分层完全没变（它由行星轮厚 3.10 和轴承高度决定），
所以 E 出来是个 **Ø44.5 × 27.1 的细长件**，F 是 **Ø50 × 27.1**。

### 12.4 齿侧间隙 thin ↔ 背隙（两版用同一个 thin）

`thin` 是**每个齿两侧一共削掉多少毫米**（每侧 thin/2）。调大 = 好装配、好打印，但空回变大。

| thin（mm / 齿） | E 单级 | E 两级输出侧 | E 两级输入侧 | F 单级 | F 两级输出侧 | F 两级输入侧 |
|---|---|---|---|---|---|---|
| 0.020 | 11.90′ | 14.42′ | 68.0′ = 1.13° | 10.41′ | 12.62′ | 59.5′ = 0.99° |
| **0.030（两版交付值）** | **17.85**′ | 21.64′ | 102.0′ = 1.70° | **15.62**′ | 18.93′ | 89.3′ = 1.49° |
| 0.040 | 23.81′ | 28.86′ | 136.1′ = 2.27° | 20.83′ | 25.25′ | 119.0′ = 1.98° |
| 0.060 | 35.71′ | 43.28′ | 204.1′ = 3.40° | 31.25′ | 37.88′ | 178.6′ = 2.98° |
| 0.080 | 47.61′ | 57.71′ | 272.1′ = 4.53° | 41.66′ | 50.50′ | 238.1′ = 3.97° |
| 0.100 | 59.52′ | 72.15′ | 340.1′ = 5.67° | 52.08′ | 63.13′ | 297.6′ = 4.96° |

「两级输出侧」= 单级 × (1 + 1/单级减速比 4.71429) —— 两级同一套齿轮，这是**恒等式**，不是另算的；
「两级输入侧」= 单级 × (1 + 4.71429)，也就是早先报表里被误标成「输出」的那一列。

（`work\backlash_table_v3.txt` 的 E 段与 F 段；全是**设计值，没实测**。“单级”= 太阳与齿圈都固定、
三个行星轮被两边同时夹住还能晃多少；“两级输出侧”= 单级 × (1 + 1/4.71429)、“两级输入侧”= 单级 × (1 + 4.71429)。
想更小就把 `thin` 调到 0.020（E 输出侧 14.42′ / F 输出侧 12.62′），代价是齿更紧、打印公差容易卡。）

### 12.5 校验结果（与 C / D 同一套脚本、同一个标准）

**方案 F**

- 30 对两两 CAD 布尔交：最大 |体积| = **0.000000000 mm³**
- 齿圈 / 太阳轮 / 两个行星架两两布尔交（6 对）：**0**
- 整圈运动扫描（一个齿距 240 步 + 整圈 720 步）：三相干涉全 **0.000e+00 mm²**
- 齿圈内齿顶 vs 行星架盘：让位 **0.6269 mm**（对齿圈内齿根 2.5010 mm；CAD 布尔交 = 0）
- 剖面积 CAD vs 多边形：齿圈 **−0.0018 %**、行星轮 **−0.0093 %**、太阳轮 **−0.0177 %**
- 12 个 STL：开放 / 非流形边 **= 0**；各 STEP 回读 `solids=1`，装配件 `solids=10`
- 单套 5 种件 **15393.856 mm³**；整机（1 齿圈 + 1 太阳 + 6 行星 + 2 架）**17456.693 mm³**；齿圈单独 **6258.506 mm³**
- 销轴 **Ø4.06**（家人 2026-09-29 指定）；行星轮 Ø7 内孔到销轴外径的径向间隙 **1.470 mm**。两个架各涨了 28.228 mm³
  （= 3 根 × π/4 × (4.06² − 3.60²) × 3.40 mm 长，算得 28.23，实测 28.228）

**方案 E**（同一口径）

- 30 对两两 CAD 布尔交最大 |体积| = **0.000000000 mm³**；整圈扫描三相干涉全 **0.000e+00 mm²**
- 齿圈内齿顶 vs 行星架盘让位 **0.6142 mm**（对齿圈内齿根 2.2540 mm）
- 剖面积：齿圈 **−0.0016 %**、行星轮 **−0.0102 %**、太阳轮 **−0.0190 %**
- 12 个 STL 非流形边 **= 0**；单套 5 种件 **12439.738 mm³**；整机 **13875.571 mm³**

原始报告：`outputs\ring_cont\验证报告_连续内齿_设计与CAD对照.txt`、`验证报告_连续内齿_导出文件检查.txt`。

### 12.6 两处外观上的说明

1. **太阳轮轮毂比齿根粗**：E 的齿根 Ø8.33、F 的 Ø9.52，但轮毂都是 **Ø10.00** —— 齿根下面会有一圈凸台。
   这是有意的：Ø5 D 孔周围要留够壁（E 只有 1.666 mm，再薄顶不住输入扭矩）。凸台在 Z = −6.00 … 0 这一段，
   和行星轮不在同一个平面上，不干涉（CAD 布尔交已核）。想让它缩进齿根里，把 `work\part_layout.py`
   的 `sun_hub_dia` 改成 8.5（E）/ 9.7（F）即可，说一声我重出。
2. **架盘外径不是 44**：见 12.3 末段。谁要是拿 C 的架盘去配 E / F 的齿圈，是装不进去的。

### 12.7 复现

```
cd work
$env:PLANETARY_RING="cont"
.\venv\Scripts\python.exe design_v3.py
.\venv\Scripts\python.exe build_parts.py
.\venv\Scripts\python.exe verify_v3.py
.\venv\Scripts\python.exe check_exports_v3.py
.\venv\Scripts\python.exe draw2d.py
.\venv\Scripts\python.exe render3d.py
```

C / D / E / F 四个方案在同一个 `VARIANTS` 字典里（`work\design_v3.py`），一次全出。
`PLANETARY_RING=cont` 才会写进 `outputs\ring_cont\`；**E / F 只有连续内齿版**，没有分段版。

---

## 13. 方案 G（22 : 1）与方案 H（20 : 1）—— 整数比，2026-09-29 新增

家人 2026-09-29 打印了 F 之后提的要求：**「修改一个严格的 20:1 或 21:1 或 22:1，就是整数的比值，尺寸尽量跟 F 靠近」**。

### 13.1 为什么整数比不是「把 F 的齿数改一改」

两级行星减速机（齿圈固定、太阳轮输入、行星架输出）单级比就是

    r = 1 + Zr / Zs

本设计两级**共用一个齿圈**（齿圈即外壳，一件）和一个模数，所以能变的只有两级的太阳/行星齿数，约束是：

    Zr = Zs1 + 2·Zp1 = Zs2 + 2·Zp2        总比 = r1 · r2
    (Zs + Zr) % k == 0                    每个行星轮级的装配条件（k = 行星轮个数）

F 是两级完全相同的 14/19/52，单级 4.71429，总比 4.71429² = **22.2245（不是整数）**。
要整数比就得**两级齿数不同** —— 改几个齿是做不到的。这也是为什么 G / H 的两级行星轮**不是同一个零件**。

### 13.2 20 / 21 / 22 三档里为什么只出 G 和 H

在 ≤Ø56 的壳里把三档都凑出来了（解析脚本 `work\design_v3.py`，报告 `work\design_probe_report.txt`）：

| | **G（22 : 1）** | H（20 : 1） | I（21 : 1） |
|---|---|---|---|
| 一级 / 二级 齿数 | 12-21-54 / 18-18-54 | 12-18-48 / 16-16-48 | 12-24-60 / 24-18-60 |
| 模数 m | **0.80** | 0.85 | 0.75 |
| 齿圈外径 | Ø51.552 | **Ø49.673** | Ø53.325 |
| 行星轮个数 一级 / 二级 | 3 / 3 | 3 / 4 | 3 / 3 |
| 交付 | **STEP + STL + 全套图纸/渲染/校验** | 同左 | **只有解析（没出 CAD）** |

**21 : 1 只出解析的原因**：21 = 6 × 3.5 能凑出来，但齿圈要 **60 齿**，m ≥ 0.80 时外径 **Ø56.5 —— 顶破 Ø56 上限**；
一路降到 **m = 0.75** 才装得下（Ø53.325），而「比 0.8 模小打印会轻微变形」这条已经把下限钉在 0.80 了。
所以 I 留在 `VARIANTS` 里作参考（解析：单级空回 15.29′ / 13.11′，输出侧空回 17.48′），**没有出零件**。

**G / H 里更推荐哪个**：要**整数比 + 最接近 F 的传动比**选 **G**（22 : 1；模数与 F 相同，打印参数/经验可以直接照搬；
一级 3 个行星轮，共 6 件行星轮）；要**外径一定不超过 F** 选 **H**（Ø49.673，比 F 的 Ø49.952 还小 0.28 mm；
代价是二级 4 个行星轮、共 7 件行星轮，一级重合度只有 1.204）。两版都留着了。

### 13.3 最终参数

| 参数 | **方案 G（22 : 1）** | **方案 H（20 : 1）** |
|---|---|---|
| 两级总减速比 | **22.0000 : 1 = 5.5 × 4.0** | **20.0000 : 1 = 5.0 × 4.0** |
| 模数 m | 0.80 | 0.85 |
| 一级 齿数 太阳/行星/齿圈（行星轮数） | 12 / 21 / 54（3 个） | 12 / 18 / 48（3 个） |
| 二级 齿数 太阳/行星/齿圈（行星轮数） | 18 / 18 / 54（3 个） | 16 / 16 / 48（**4 个，90° 均布**） |
| 变位 x 一级 太阳/行星/齿圈 | +0.300 / −0.140 / +0.020 | +0.300 / −0.030 / +0.240 |
| 变位 x 二级 太阳/行星/齿圈 | +0.100 / −0.040 / +0.020 | +0.080 / +0.080 / +0.240 |
| 齿顶高系数 太阳/行星/齿圈 | 0.95 / 1.10 / 1.00（两级同） | 1.05 / 1.15 / 1.00（两级同） |
| 中心距 a 一级 / 二级 | **13.32376 / 14.44742 mm** | **12.96639 / 13.73136 mm** |
| 啮合角 α_w 一级 / 二级 | 21.4144° / 20.5104° | 22.4804° / 21.4554° |
| 中心距变动 dy 一级 / 二级 | +0.15470 m / +0.05927 m | +0.25458 m / +0.15455 m |
| 齿顶厚 太阳/行星/齿圈 一级 | 0.559 / 0.610 / 0.773 mm | 0.597 / 0.658 / 0.853 mm |
| 齿顶厚 太阳/行星/齿圈 二级 | 0.586 / 0.485 / 0.773 mm | 0.613 / 0.507 / 0.853 mm |
| 重合度 太阳-行星 / 行星-齿圈 一级 | 1.269 / 1.750 | 1.204 / 1.466 |
| 重合度 太阳-行星 / 行星-齿圈 二级 | 1.466 / 1.772 | 1.382 / 1.493 |
| 太阳轮 齿顶 Ø / 齿根 Ø 一级 | 11.352 / 8.080 mm | 12.062 / 8.585 mm |
| 太阳轮（二级，长在行星架上）齿顶/齿根 | 15.985 / 12.560 mm | 15.258 / 11.611 mm |
| 行星轮 齿顶 Ø / 齿根 Ø 一级 | 18.088 / 14.576 mm | 16.771 / 13.124 mm |
| 行星轮 齿顶 Ø / 齿根 Ø 二级 | 16.001 / 12.336 mm | 15.428 / 11.611 mm |
| 行星轮 内孔壁厚（齿根处）一级 / 二级 | 3.788 / 2.668 mm | 3.062 / 2.306 mm |
| 齿圈 内齿顶 Ø / 内齿根 Ø / 外径 | **41.880 / 45.552 / Ø51.552** | **39.941 / 43.673 / Ø49.673** |
| 齿圈 长 / 壁厚 | 10.70 / 3.00 mm | 10.70 / 3.00 mm |
| 行星架盘 Ø（一级 / 二级） | 40.63 / 40.63 mm | 38.69 / 38.69 mm |
| 架盘 vs 齿圈内齿顶 让位（单边） | 0.6248 mm | 0.6254 mm |
| 相邻行星轮净间隙 一级 / 二级 | 4.989 / 9.022 mm | 5.687 / 3.991 mm |
| 行星轮内孔 / 销轴 / 齿宽 | Ø7.00 / Ø4.06 / 3.10 mm | 同左 |
| 太阳轮 Ø5 D 孔壁 一级 / 二级 | **1.540** / 3.780 mm | **1.792** / 3.305 mm |
| 轴向总高（−6.00 … 21.10） | 27.10 mm（与 C~F 完全一样） | 同左 |
| 行星轮烘入相位 一级 / 二级 | 17.1429° / 0.0000° | 10.0000° / 11.2500° |
| 齿圈烘入相位 | 63.3333° | 60.0000° |
| 二级太阳轮烘入相位 | −30.0000° | −22.5000° |

（全是**设计值，未实测**。）

**与 F 保持不变的**：齿圈长 10.70、行星轮齿宽 3.10、行星轮内孔 Ø7.00、销轴 Ø4.06、总高 27.10、Ø5 D 孔（深 8.00）；
**变了的**：齿圈外径（G 比 F 大 1.60 mm、H 比 F 小 0.28 mm）、行星架盘外径（F Ø38.95 → G Ø40.63 / H Ø38.69）、
两级齿数，以及 **G / H 的两级行星轮变成两种零件**。

### 13.4 齿圈是一件，可两级的 dy 不一样 —— 这一点是怎么处理的

两级共用一件齿圈，但两级算出来的中心距变动量 **dy 不同**（G 一级 +0.15470 m、二级 +0.05927 m；
H +0.25458 m / +0.15455 m）。而 dy 决定**齿圈内齿顶半径**（`rt = m·(Zr/2 − add + x) + dy·m`），一件齿圈只能有一个值。

处理办法：**齿圈按一级的 dy 出**（内齿顶 G Ø41.880 / H Ø39.941），二级就用这一件齿圈去啮合。这样安全的原因：
两级都满足标准行星条件 Zr = Zs + 2·Zp，dy 大的那一级让齿圈的齿更「浅」；二级拿到的是**比它自己需要的更大的内齿顶**，
即**齿顶间隙偏大、只会更不容易干涉**（代价是二级的行星-齿圈重合度略降一点）。

校验时**两级都对着这一件真实齿圈算**（`stage_lib.Stage` 的 `ring_dy` 覆盖），不是各算各的理想齿圈 ——
`验证报告_连续内齿_整数比方案.txt` 里那行 `ring dy (ONE part -> stage 1's value)` 就是记这个口径的。
（改之前两级是各按自己的 dy 算的，2026-09-29 已改成上面这个物理口径；一级的数一个都没动，
二级的空回变化在 0.003′ 量级。）

### 13.5 校验结果

原始报告：`outputs\ring_cont\验证报告_连续内齿_整数比方案.txt`（脚本 `work\verify_int.py`）、
`outputs\ring_cont\验证报告_连续内齿_导出文件检查.txt`。

**方案 G**

- 剖面积 CAD vs 多边形：齿圈 **−0.0018 %**、一级行星轮 −0.0073 %、二级行星轮 +0.0026 %、一级太阳轮 −0.0044 %、二级太阳轮 −0.0059 %
- 两两 CAD 布尔交 **30 对**（24 行星轮-其他件 + 6 行星轮-行星轮）：最大 \|体积\| = **0.000000000 mm³**
- 逐级整圈扫描（一个齿距 240 步 + 整圈 720 步）：三相干涉全 **0.000e+00 mm²**
- 单级空回 **15.64′ / 14.33′**；两级输出侧 **18.24′**、输入侧 72.97′
- 齿圈内齿顶 Ø41.880 vs 行星架盘 Ø40.63：单边 **0.6248 mm**（这一件是实物布尔交，= 0）
- 12 个 STL 开放/非流形边 **= 0**；单套 6 种件 16829.100 mm³；整机 **18607.946 mm³**（`solids=10`）

**方案 H**（同一套脚本、同一个标准）

- 剖面积：齿圈 **−0.0015 %**、一级行星轮 −0.0055 %、二级行星轮 −0.0110 %、一级太阳轮 −0.0043 %、二级太阳轮 −0.0024 %
- 两两 CAD 布尔交 **37 对**（二级 4 个行星轮）：最大 \|体积\| = **0.000000000 mm³**
- 整圈扫描：三相干涉全 **0.000e+00 mm²**
- 单级空回 **16.21′ / 15.17′**；两级输出侧 **19.22′**、输入侧 76.87′
- 齿圈内齿顶 Ø39.941 vs 行星架盘 Ø38.69：单边 **0.6254 mm**
- 12 个 STL 非流形边 **= 0**；单套 6 种件 15795.685 mm³；整机 **17608.831 mm³**（`solids=11`）

### 13.6 取舍 —— 哪些地方比 F 差（老实说）

1. **输入太阳轮变细**：单级比要做到 5.0 ~ 5.5（F 是 4.71429），一级太阳轮只能取 **12 齿**，
   于是 Ø5 D 孔到齿根只剩 **G 1.540 mm / H 1.792 mm**（F 是 2.260 mm，C 是 2.856 mm）。
   输入扭矩全靠这一圈壁传到齿上 —— **这是 G / H 相对 F 最实质的退步**。输入扭矩不小、或者要反复拆装的话，
   建议用 F；或者把一级太阳轮加到 14 齿（那就不是整数比了，说一声我出）。
2. **H 的一级重合度只有 1.204**（G 1.269，F 1.361）—— 12 齿小齿轮 + 齿圈 Ø48 的组合里，齿圈内齿顶被 dy = 0.25458 m
   削得比较浅。能转、干涉为 0，但齿数交替承载的平稳性不如 G。
3. **多一种零件**：G / H 的两级行星轮齿数不同 = **两种行星轮**（G 一级 21 齿 ×3 + 二级 18 齿 ×3；H 一级 18 齿 ×3 + 二级 16 齿 ×4）。
   F 的 6 个行星轮是完全同一个件。H 还要多打 1 个行星轮和 1 根销轴（二级 4 个）。
4. **整数比本身没有性能好处**：它的意义只是「输入 22 圈 = 输出 1 圈」这种好算好用的关系。
   如果不需要这个，F 的 22.2245 齿数更宽裕、壁更厚。反过来说，G 的**输出侧空回 18.24′ 比 F 的 18.93′ 还小一点**，
   齿圈也只大 1.6 mm —— 整数比并没有把性能换掉多少。

### 13.7 复现

```
cd work
$env:PLANETARY_RING="cont"
.\venv\Scripts\python.exe design_v3.py            # 解析：C / D / E / F / G / H / I 全出（只要几套就写字母）
.\venv\Scripts\python.exe build_parts.py G H      # 出 STEP + STL（G / H）
.\venv\Scripts\python.exe verify_int.py G H       # 整数比专用校验报告
.\venv\Scripts\python.exe check_exports_v3.py     # 全部方案的 STL 封闭性 / STEP 回读
.\venv\Scripts\python.exe draw2d.py               # 图纸（含六方案对照）
.\venv\Scripts\python.exe render3d.py G H         # 3D 渲染
.\venv\Scripts\python.exe backlash_sweep_int.py # C~H 六套的 thin <-> 背隙表（见 13.8）
```

> **C / D / E / F 的零件没有任何改动**：2026-09-29 复核 —— `design_v3.json` 里 C~F 的每一个数值与改动前逐位相同
> （只有 G / H / I 的二级多边形模型数值变了，见 13.4）。

### 13.8 G / H 的 `thin` ↔ 背隙

口径与第 12.4 节完全一样（`thin` = **每个齿两侧一共**削掉多少毫米；调大 = 好装配 / 好打印、空回变大）。
**全是设计值，没实测。** 两级合并的公式和 C~F 一样，只是 G / H 的两级不是同一套齿轮：

    输出侧（输入锁死） = 二级单级空回 + 一级单级空回 / 4.0
    输入侧（输出锁死） = 一级单级空回 + 二级单级空回 × 4.0

（G、H 的二级单级比都是 4.0。这两式就是设计脚本里算两级的原式，不是另编的。）

| thin（mm / 齿） | G 一级 / 二级 单级空回 | G 两级输出侧 | G 两级输入侧 | H 一级 / 二级 单级空回 | H 两级输出侧 | H 两级输入侧 |
|---|---|---|---|---|---|---|
| 0.020 | 10.44′ / 9.56′ | 12.17′ | 48.67′ | 10.82′ / 10.11′ | 12.81′ | 51.26′ |
| **0.030（交付值）** | **15.64′ / 14.33′** | **18.24′** | 72.97′ = 1.22° | **16.21′ / 15.17′** | **19.22′** | 76.87′ = 1.28° |
| 0.040 | 20.85′ / 19.10′ | 24.32′ | 97.27′ | 21.60′ / 20.22′ | 25.62′ | 102.50′ |
| 0.060 | 31.26′ / 28.65′ | 36.47′ | 145.87′ | 32.38′ / 30.34′ | 38.43′ | 153.72′ |
| 0.080 | 41.68′ / 38.20′ | 48.62′ | 194.48′ | 43.17′ / 40.45′ | 51.24′ | 204.95′ |
| 0.100 | 52.09′ / 47.75′ | 60.77′ | 243.09′ | 53.95′ / 50.55′ | 64.04′ | 256.17′ |

`thin` = 0.015 那一行没列：它已经低于多边形模型的解析度（算出来是 0.000°），不真实 —— 与第 7 节末尾同一条。
七套（C~J）的完整表在 `work\backlash_table_int.txt`；刻度是**线性**的，实测差多少就按比例调 `thin`。

---

## 14. 方案 J（25 : 1，两级同件）—— 2026-09-30 新增

家人 2026-09-30 的要求：**「行星轮不一样的话比较容易出错，您试试 25 : 1 的，外圈大一点没关系」**。
J 就是冲着这两条去的 —— 一个 25 : 1 的整数比，而且**两级行星轮是同一个零件**。

### 14.1 25 : 1 为什么只能是「两级同件」这一种

两级共用一个齿圈、一个模数，并且**两级行星轮是同一个零件**（Zp1 = Zp2）时：

    Zr = Zs1 + 2·Zp1 = Zs2 + 2·Zp2   且   Zp1 = Zp2
    ⇒ Zs1 = Zs2 = Zs     ⇒  单级比 rs = 1 + Zr / Zs     ⇒  总比 = rs²

总比要**严格整数**，rs 就得是整数；20 ~ 30 之间只有 **25 = 5²**。rs = 5 ⇒ **Zr = 4·Zs**。
而在 ≤Ø56 的壳里，能满足这个比例、又摆得下一个太阳轮 + 3 个行星轮 + 齿圈的最小齿数组是
**12-18-48**（12 + 2×18 = 48，每级 3 个行星轮，装配条件 (12+48) % 3 = 0）。本工程的齿数全扫脚本
`work\scan5.py`（Ø56 内 365 组）里，25 : 1 就是这个齿数。

所以 J 的齿数**没有可挑的余地** —— 也正因为两级是同一套齿轮，**行星轮只有一种零件、共 6 个**，
不存在 G / H 那种「一级行星轮和二级行星轮不能混」的出错点。

### 14.2 外圈大一点，这点余量花在哪儿了

25 : 1 的骨架（12-18-48）比 F 的（14-19-52）小，但输入太阳轮的 **Ø5 D 孔**没变小；单级比一提到 5.0，
一级太阳轮就只剩 12 齿 —— 这正是 G / H 相对 F 最实质的退步（Ø5 孔壁 G 一级 1.540 / H 一级 1.792 mm，
F 2.260 mm）。J 把「外圈可以放宽」的余量**花在模数上**：12-18-48 固定不动，只把 m 往上抬。

（下面这组数是本模型算出来的设计值，未实测；齿顶高系数用 J 最终的 1.15 / 1.25。）

| 模数 m | 齿圈外径 | 太阳轮 Ø5 孔壁 | 齿顶厚 太阳 / 行星 / 齿圈 | 单级空回（thin = 0.030） |
|---|---|---|---|---|
| 0.90 | Ø52.242 | 2.045 | 0.502 / 0.595 / 0.904 mm | 15.29′ |
| **0.95（= 方案 J）** | **Ø54.811 ≤ 56** ✅ | **2.297** | **0.531 / 0.630 / 0.956 mm** | **14.49′** |
| 1.00 | **Ø57.380 > 56 ❌ 放不下** | 2.550 | 0.561 / 0.665 / 1.008 mm | 13.77′ |

- 外径随模数涨：从 0.95 → 1.00 这两档算下来是**每 +0.01 模数涨约 0.51 mm**，照这个斜率，齿圈到 Ø56
  的模数上限约 **0.97** —— **0.95 就是 0.05 一档里最大的那个**（0.95 → Ø54.811，离 56 还剩 1.19 mm）。
- 重合度在三个模数下**完全一样**（1.324 / 1.530）：重合度由齿数、变位、齿顶高系数决定，跟模数无关。
- 齿顶高系数也从 H 一级的 1.05 / 1.15 提到 **1.15 / 1.25**，把一级重合度从 **1.204 提到 1.324**；
  代价是太阳轮齿顶厚从 0.597 降到 **0.531 mm**（仍比 0.4 mm 喷嘴口径宽）。

### 14.3 最终参数（与 H / F 并列）

| 参数 | **方案 J（25 : 1）** | 参照 H（20 : 1） | 参照 F（22.2245 : 1） |
|---|---|---|---|
| 两级总减速比 | **25.0000 : 1 = 5.0 × 5.0** | 20.0000 : 1 = 5.0 × 4.0 | 22.2245 : 1（非整数） |
| 模数 m | **0.95** | 0.85 | 0.80 |
| 齿数 太阳 / 行星 / 齿圈（两级相同） | **12 / 18 / 48** | 一级 12-18-48、二级 16-16-48 | 14 / 19 / 52（两级相同） |
| 行星轮 | **只有一种件，共 6 个（每级 3 个）** | 两种件、共 7 个 | 一种件、共 6 个 |
| 齿圈（= 外壳）外径 / 壁厚 | **Ø54.811 ≤ 56** ✅ / 3.00 mm | Ø49.673 / 3.00 | Ø49.952 / 3.00 |
| 齿圈 内齿顶 Ø / 内齿根 Ø | 44.640 / 48.811 mm | 39.941 / 43.673 | 40.204 / 43.952 |
| 中心距 a / 啮合角 α_w / 中心距变动 dy | 14.49185 mm / 22.4804° / +0.25458 m | 一级 12.96639 / 22.4804° / +0.25458 m | 13.28593 / 20.9945° / +0.10742 |
| 变位 x 太阳 / 行星 / 齿圈 | +0.3000 / −0.0300 / +0.2400 | 一级同左 | +0.2000 / −0.0900 / +0.0200 |
| 齿顶高系数 太阳 / 行星 / 齿圈 | **1.15 / 1.25 / 1.00** | 1.05 / 1.15 / 1.00 | 0.95 / 1.10 / 1.00 |
| 齿顶厚 太阳 / 行星 / 齿圈 | 0.531 / 0.630 / 0.956 mm | 一级 0.597 / 0.658 / 0.853 | 0.571 / 0.550 / 0.755 |
| 重合度 太阳-行星 / 行星-齿圈 | **1.324 / 1.530** | 一级 1.204 / 1.466 | 1.361 / 1.836 |
| 太阳轮 齿顶 Ø / 齿根 Ø | 13.671 / 9.595 mm | 一级 12.062 / 8.585 | 12.868 / 9.520 |
| 行星轮 齿顶 Ø / 齿根 Ø / 内孔壁厚 | 18.934 / 14.668 / **3.834 mm** | 一级 16.771 / 13.124 / 3.062 | 16.644 / 13.056 / 3.028 |
| 行星架盘 Ø | **43.39 mm** | 38.69 | 38.95 |
| 相邻行星轮净间隙 | +6.166 mm | 一级 +5.687 | — |
| 架盘 vs 齿圈内齿顶 让位（单边） | 0.6248 mm | 0.6254 | 0.6269 |
| 太阳轮 Ø5 D 孔壁 | **2.297 mm** | 一级 **1.792** | 2.260 |
| 根切校核 x_min 太阳 / 行星 / 齿圈 | +0.298 / −0.053 / −1.807 → OK | OK | OK |
| 单级空回（设计值） | **14.49′** | 16.21′ / 15.17′ | 15.62′ |
| 两级**输出侧**空回（设计值，输入锁死） | **17.39′** | 19.22′ | 18.93′ |
| 两级**输入侧**空回（设计值，输出锁死） | **86.94′ = 1.45°** | 76.87′ = 1.28° | 89.25′ = 1.49° |
| 行星轮内孔 / 销轴 / 齿宽 | Ø7.00 / Ø4.06 / 3.10 mm | 同左 | 同左 |
| 装配相位 | 一级行星轮 10.0000°、齿圈烘入 60.0000°、二级太阳轮 10.0000°（两级相同） | 10.0000 / 60.0000 / −22.5000 | — |
| 轴向总高（−6.00 … 21.10） | 27.10 mm（与 C ~ H 完全一样） | 同左 | 同左 |
| 单套 5 种件 / 整机（STEP 几何体积） | 18235.618 / **21050.989 mm³** | 15795.685 / 17608.831 | 15393.856 / 17456.693 |

（全是**设计值，未实测**；未含 3D 打印公差。体积是 CAD 算出来的**几何体积**，
**要打多少克丝、打多久我这里没有数** —— 那得真切片才知道。）

**与 C ~ F 完全不变的**：件名与件数（`01_ring_gear` / `02_planet_gear` ×6 / `03_input_sun` /
`04_carrier1_sun2` / `05_output_carrier`，共 10 件塑料件）、齿圈长 10.70、行星轮齿宽 3.10、
行星轮内孔 Ø7.00、销轴 Ø4.06、总高 27.10、Ø5 D 孔深 8.00。
**变了的**：模数（0.95）、齿数（12-18-48）、齿圈外径（Ø54.811）、行星架盘 Ø（43.39）。

### 14.4 J 的 `thin` ↔ 背隙

口径与第 12.4 / 13.8 节完全一样（`thin` = **每个齿两侧一共**削掉多少毫米；调大 = 好装配 / 好打印、空回变大）。
**全是设计值，没实测。** J 的两级**完全同一套齿轮**，所以两级合并就是「单级 × (1 + 1/5)」（输出侧）
和「单级 × (1 + 5)」（输入侧）—— 和 C ~ F 用的是同两式，只是单级比换成 5.0。

| thin（mm / 齿） | J 单级空回 | J 两级输出侧 | J 两级输入侧 |
|---|---|---|---|
| 0.020 | 9.66′ | 11.59′ | 57.97′ |
| **0.030（交付值）** | **14.49′** | **17.39′** | 86.94′ = 1.45° |
| 0.040 | 19.32′ | 23.18′ | 115.91′ = 1.93° |
| 0.060 | 28.97′ | 34.76′ | 173.81′ = 2.90° |
| 0.080 | 38.61′ | 46.33′ | 231.67′ = 3.86° |
| 0.100 | 48.26′ | 57.91′ | 289.55′ = 4.83° |

七套（C ~ J）的完整表在 `work\backlash_table_int.txt`；刻度是**线性**的，实测差多少就按比例调 `thin`。
`thin` = 0.015 那一行没列 —— 与第 7 节末尾同一条：它已低于多边形模型的解析度，算出来不真实。

### 14.5 校验结果（与 C ~ H 同一套脚本、同一个标准）

- 剖面积 CAD vs 多边形：齿圈 **−0.0017 %**、行星轮 **+0.0021 %**、太阳轮 **−0.0003 %**
- **30 对**两两 CAD 布尔交（24 对行星-对件 + 6 对行星-行星）：最大 |体积| = **0.000000000 mm³**；
  对照组（行星轮与自己）**564.059 mm³**，正好等于该件的实体积
- 齿圈 / 太阳轮 / 两个行星架两两布尔交：**0**
- 整圈运动扫描（一个齿距 240 步 + 整圈 720 步）：三相干涉全 **0.000e+00 mm²**
- 齿圈内齿顶 Ø44.640 vs 行星架盘 Ø43.39：单边让位 **0.6248 mm**（实物布尔交 = 0）
- 6 个 STL：开放 / 非流形边 **= 0**；6 个 STEP 全部回读成功，`solids=1`（零件）/ `10`（装配），
  装配体积与逐件求和差 **0.0003 mm³**
- 需求核对：齿圈 Ø54.811 ≤ 56 ✅ / 总比 25.000000 是严格整数 25 ✅ / 太阳轮 Ø5 孔深 8.00 ≥ 5 ✅ /
  行星轮内孔 Ø7.00 ✅ / 行星轮齿宽 3.10 ∈ [3.0, 3.2] ✅ / 无根切 ✅ / 无干涉 ✅

原始报告：`outputs\ring_cont\验证报告_连续内齿_整数比方案.txt`（含 G / H / J）、
`outputs\ring_cont\验证报告_连续内齿_导出文件检查.txt`。

### 14.6 取舍 —— 哪些地方比别版差（老实说）

1. **「行星轮只有一种」这条做到了** —— 6 个完全相同的 `02_planet_gear`，两级随便插，不会装错。
   这是 J 相对 G / H 唯一但也是家人点名的那条优势。
2. **输出侧空回 17.39′**：比 F（18.93′）小 1.54′，**是三个整数比方案里最小的**（G 18.24′ / H 19.22′）；
   但比 C（16.84′）/ D（15.94′）略大 —— 那两版模数更大、齿圈也更大，本来背隙就小。
3. **齿圈 Ø54.811，七版里第三大**（D Ø55.883 > C Ø55.443 > J），比 F 大 4.86 mm；
   离 56 上限还剩 1.19 mm。**热床和两个端盖要按 Ø54.811 留**，别照 F 的 Ø49.95 做。
4. **齿顶最薄 0.531 mm（太阳轮）**：只比 F 的 0.550 薄 0.019，比 C 的 0.524 还略厚，
   更比 G 0.485 / H 0.507 / E 0.477 厚 —— 0.4 mm 喷嘴能印出方角，不需要 E 那种换小喷嘴的特殊要求。
5. **一级重合度 1.324**：比 G（1.269）/ H（1.204）好，仍不及 F（1.361）/ C（1.452）。
6. **整机 21050.989 mm³**：比 F 重 3594.30 mm³，但比 C（21361.24）/ D（21427.41）轻
   —— 齿圈大了一圈，架盘也跟着涨到 Ø43.39。
7. **跨方案零件不能互换**：J 的模数 0.95、齿圈 48 齿、架盘 Ø43.39，和 C ~ H 的任何一件都配不上。

### 14.7 复现

```
cd work
$env:PLANETARY_RING="cont"
.\venv\Scripts\python.exe design_v3.py          # 解析全出，写 design_v3.json（draw2d.py 读的就是它）
.\venv\Scripts\python.exe build_parts.py J      # 出 STEP + STL 到 outputs\ring_cont\J_ratio25\
.\venv\Scripts\python.exe verify_int.py G H J   # 整数比专用校验报告
.\venv\Scripts\python.exe check_exports_v3.py   # 全部方案的 STL 封闭性 / STEP 回读
.\venv\Scripts\python.exe draw2d.py             # 图纸（含七方案对照）
.\venv\Scripts\python.exe render3d.py J         # 3D 渲染
.\venv\Scripts\python.exe backlash_sweep_int.py # C ~ J 七套的 thin <-> 背隙表
```

> `design_v3.py J`（带字母）只写 `design_probe.json`，**不会**动 `design_v3.json` —— `draw2d.py` 读的是后者，
> 所以重出图纸前要先跑一次不带参数的 `design_v3.py`。

## 15. 方案 K（16 : 1，每级 4 个行星轮）—— 2026-09-30 新增

家人 2026-09-30 的要求：「**4 个行星轮我觉得值得尝试一下**」「**打断一下，4 个行星轮，模数可以变的，所有东西都不是一成不变的，
减速比要整数比 : 1**」「**或者能被 360（电机圈数）或者 4096（编码器）整除**」。

### 15.1 4 个行星轮把比值卡在哪儿（几何硬约束）

4 个行星轮均布 90°，相邻两个的行星轮齿顶圆不能打架：

    2·a·sin 45° = 1.41421·a  >  行星轮齿顶圆直径 da_p

把 Zp = (Zr − Zs)/2、Zr = (r − 1)·Zs 代进去，等价于

    Zs·[0.70711 − 0.14645·(r − 1)]  >  (2·add_p + 2·x_p − 2·dy)

方括号在 **r ≈ 5.83** 处变号 —— 也就是说**单级比撑不到 5.8**。两级都上 4 个行星轮时，总比上限就是 **5.83² ≈ 34**，
再扣掉变位/齿顶高系数/孔壁这些实打实的约束，实际能用的只有下面几个。**这不是取舍，是几何上限**，
所以「4 个行星轮 + 总比 20 ~ 30」这两条本身就很难同时满足。

### 15.2 上限之内的整数比：哪几个真能做出来

扫描脚本 `work\scan_k4_geo.py`（模数 0.80 ~ 1.05 全扫，变位/齿顶高系数按网格搜）的结果，
**全是设计值、没实测**；「输出扭矩上限」按齿根 20 MPa 许用反推：

| 候选总比 | 拆法 | 360 ÷ r | 4096 ÷ r | 4 行星轮能做出来吗 | 输出扭矩上限（20 MPa 许用） |
|---|---|---|---|---|---|
| **16 : 1** | 4 × 4 | 22.5 ❌ | **256 ✅** | ✅ 16-16-48 ×4 / 16-16-48 ×4 | **1.91 N·m**（K 交付版 1.81） |
| **20 : 1** | 4 × 5 | **18 ✅** | 204.8 ❌ | ✅ 16-16-48 ×4 / 12-18-48 ×4 | 1.72 N·m |
| 25 : 1 | 5 × 5 | 14.4 ❌ | 163.84 ❌ | ✅ 12-18-48 ×4 / 12-18-48 ×4 | 1.72 N·m |
| 24 : 1 | 4 × 6 | 15 ✅ | 170.67 ❌ | ❌ **无可行解**（单级比 6 > 5.83） | — |
| 18 : 1 | — | 20 ✅ | — | ❌ 无可行解 | — |
| 21 / 22 / 28 : 1 | — | — | — | ❌ 全部无可行解 | — |

- 表中 25 : 1 那一行虽然做得出来，但相邻行星轮净间隙只剩 **1.683 mm**（K 是 4.646），太挤，且 360 / 4096 都整除不了。
- 24 : 1 这一档很典型：**360 / 24 = 15 是整数**，可惜单级比 6 已经超出 5.83 的上限，做不出来。

**所以「4 个行星轮 + 整数比 + 整除 360 或 4096」只剩两个候选：16（整除 4096）和 20（整除 360、且正好在 20~30 里）。**

### 15.3 这一版为什么选 16 : 1

1. **两级完全同件**：16 = 4×4 → 两级都是 16-16-48，**行星轮只有一种零件、共 8 个**；
   20 = 4×5 → 一级 16-16-48、二级 12-18-48，两级行星轮是两种零件（和 H 一样，多一个装错的可能）。
2. **单摆放相位**：(Zs + Zp) % 4 = (16 + 16) % 4 = 0 → 4 个行星轮**同一相位**（11.25°）就装得上；
   20 的一级 (12 + 18) % 4 = 2 → 两组相位（装是对的，但摆位要分两组）。
3. **扭矩更大**：按同一套齿根算法（`work\_k_stress.py`）算，16 比 20 的输出扭矩上限高约 11%
   （1.91 / 1.72 N·m，20 MPa 许用反推）；交付版（x = +0.15/+0.15/+0.45）在输出 4 N·m 时是 **44.2 MPa**。
4. **正好整除 4096**：4096 / 16 = **256** —— 输出轴转一圈 = 编码器 256 个计数（一个计数 = 输出 0.00549°）。
   360 / 16 = 22.5 不是整数；这一条是用 4096 满足的。

代价（老实说）：**总比 16 比 J 的 25 小**，输出扭矩的放大倍数少；而且它**不在家人最早说的 20~30 区间**里。
要「落在 20~30 而且整除 360」，那只能是 **20 : 1 的 4 行星轮版**（上表第二行）——
外径和 K 几乎一样、齿圈可以共用，代价是两级行星轮变成两种零件、扭矩少 11%。**没做，等家人拍。**

### 15.4 最终参数（与 J / H 并列）

| 参数 | **方案 K（16 : 1）** | 参照 J（25 : 1） | 参照 H（20 : 1） |
|---|---|---|---|
| 两级总减速比 | **16.0000 : 1 = 4.0 × 4.0** | 25.0000 : 1 = 5.0 × 5.0 | 20.0000 : 1 = 5.0 × 4.0 |
| 模数 m | **0.95** | 0.95 | 0.85 |
| 齿数 太阳 / 行星 / 齿圈 | **16 / 16 / 48**（两级相同） | 12 / 18 / 48（两级相同） | 一级 12-18-48、二级 16-16-48 |
| 行星轮 | **一种件、共 8 个（每级 4 个）** | 一种件、共 6 个 | 两种件、共 7 个 |
| 齿圈（= 外壳）外径 / 壁厚 | **Ø55.210 ≤ 56** ✅ / 3.00 | Ø54.811 / 3.00 | Ø49.673 / 3.00 |
| 齿圈 内齿顶 Ø / 内齿根 Ø | 45.091 / 49.210 mm | 44.640 / 48.811 | 39.941 / 43.673 |
| 中心距 a / 啮合角 α_w / dy | 15.46815 mm / 22.5713° / +0.28226 m | 14.49185 / 22.4804° / +0.25458 | 一级 12.96639 / 22.4804° / +0.25458 |
| 变位 x 太阳 / 行星 / 齿圈 | +0.1500 / +0.1500 / +0.4500 | +0.3000 / −0.0300 / +0.2400 | 一级同左 |
| 齿顶高系数 太阳 / 行星 / 齿圈 | 1.15 / 1.15 / 1.00 | 1.15 / 1.25 / 1.00 | 1.05 / 1.15 / 1.00 |
| 齿顶厚 太阳 / 行星 / 齿圈 | **0.694 / 0.694 / 0.963 mm** | 0.531 / 0.630 / 0.956 | 一级 0.597 / 0.658 / 0.853 |
| 重合度 太阳-行星 / 行星-齿圈 | 1.257 / 1.301 | 1.324 / 1.530 | 一级 1.204 / 1.466 |
| 太阳轮 齿顶 Ø / 齿根 Ø / Ø5 孔壁 | 17.134 / 13.110 / **4.055 mm** | 13.671 / 9.595 / 2.297 | 一级 12.062 / 8.585 / 1.792 |
| 行星轮 齿顶 Ø / 齿根 Ø / Ø7 孔壁 | 17.134 / 13.110 / **3.055 mm** | 18.934 / 14.668 / 3.834 | 一级 16.771 / 13.124 / 3.062 |
| 行星架盘 Ø | **43.84 mm** | 43.39 | 38.69 |
| 相邻行星轮净间隙 | +4.742 mm | +6.166 | 一级 +5.687 |
| 架盘 vs 齿圈内齿顶 让位（单边） | 0.6257 mm | 0.6248 | 0.6254 |
| 单级 / 两级输出侧空回（thin = 0.030） | **13.59′ / 16.98′** | 14.49′ / 17.39′ | 一级 16.21′；两级 19.22′ |
| 两级输入侧空回 | 67.94′ = 1.13° | 86.94′ = 1.45° | 76.87′ = 1.28° |
| 销轴 Ø / 行星轮内孔 Ø | 4.06 / 7.00 mm | 4.06 / 7.00 | 4.06 / 7.00 |
| 整机体积（STL） | 22012.153 mm³ | 21050.989 | — |
| 轴向总长 | 27.10 mm | 27.10 | 27.10 |

齿圈/行星架/轴向尺寸链、端盖让位这些和 J 完全同一套，只是数换了：**齿圈轴向还是 10.70（z −0.30…10.40），
总长还是 27.10 mm，行星轮内孔还是 Ø7、销轴还是 Ø4.06、齿宽还是 3.10**。

### 15.5 K 的 `thin` ↔ 背隙

口径与第 12.4 / 13.8 / 14.4 节完全一样（`thin` = **每个齿两侧一共**削掉多少毫米；调大 = 好装好印、空回变大）。
K 的两级是同一套齿轮，所以两级合并同样是「单级 × (1 + 1/4)」（输出侧）和「单级 × (1 + 4)」（输入侧）。**全是设计值。**

| thin（mm / 齿） | K 单级空回 | K 两级输出侧 | K 两级输入侧 |
|---|---|---|---|
| 0.020 | 9.07′ | 11.33′ | 45.34′ |
| **0.030（交付值）** | **13.59′** | **16.98′** | **67.94′ = 1.13°** |
| 0.040 | 18.11′ | 22.64′ | 90.54′ = 1.51° |
| 0.060 | 27.15′ | 33.94′ | 135.75′ = 2.26° |
| 0.080 | 36.20′ | 45.25′ | 180.98′ = 3.02° |
| 0.100 | 45.24′ | 56.56′ | 226.22′ = 3.77° |

八套（C ~ K）的完整表在 `work\backlash_table_int.txt`；刻度是**线性**的，实测差多少就按比例调 `thin`。
`thin` = 0.015 那一行没列 —— 它已低于多边形模型的解析度，算出来是假的（第 7 节末尾同一条）。

### 15.6 校验结果（与 C ~ J 同一套脚本、同一个标准）

- 剖面积 CAD vs 多边形：齿圈 **−0.0013 %**、行星轮 **−0.0133 %**、太阳轮 **−0.0117 %**
- **44 对**两两 CAD 布尔交（**32 对行星-对件 + 12 对行星-行星** —— 4 个行星轮互相之间也是两两检查的）：
  最大 |体积| = **0.000000000 mm³**；对照组（行星轮与自己）**440.380 mm³**，正好等于该件实体积
- 齿圈 / 太阳轮 / 两个行星架两两布尔交：**0**
- 整圈运动扫描（一个齿距 240 步 + 整圈 720 步）：三相干涉全 **0.000e+00 mm²**
- 齿圈内齿顶 Ø45.091 vs 行星架盘 Ø43.84：单边让位 **0.6257 mm**（实物布尔交 = 0）
- 6 个 STL：开放 / 非流形边 **= 0**；6 个 STEP 全部回读成功，零件 `solids=1`、装配 `solids=12`，
  装配体积与逐件求和差 **0.0002 mm³**
- 齿根弯曲（和 J 同一套算法，`work\_k_stress.py`）：输出 4 N·m 时行星轮 **44.2 MPa**、太阳轮 44.2、齿圈 19.0；
  每根行星销受力 64.6 N（J 是 92.0 N）
- 需求核对：齿圈 Ø55.210 ≤ 56 ✅ / 总比 16.000000 是严格整数 ✅ / **4096 ÷ 16 = 256 整除** ✅ /
  太阳轮 Ø5 孔深 8.00 ≥ 5 ✅ / 行星轮内孔 Ø7.00 ✅ / 行星轮齿宽 3.10 ∈ [3.0, 3.2] ✅ / 无根切 ✅ / 无干涉 ✅

原始报告：`outputs\ring_cont\验证报告_连续内齿_整数比方案.txt`（含 G / H / J / K）、
`验证报告_连续内齿_导出文件检查.txt`、`验证报告_方案K_齿根弯曲应力.txt`。

### 15.7 取舍 —— 哪些地方比别版差（老实说）

1. **总比只有 16**：比 J（25）/ G（22）/ H（20）/ F（22.22）都小，输出扭矩放大倍数最少的那一档；
   换来的好处是**每级 4 个行星轮**（单销受力 64.6 N vs J 的 92.0 N）和**两级同件**。
2. **不在 20~30 区间**：家人最早说的是 20~30，K 是靠「整除 4096」这条进来的。要落在区间里就得做 20 : 1（15.3 节末）。
3. **齿圈 Ø55.210 与 L 并列第三大**（D Ø55.883 > C Ø55.443 > K = L Ø55.210 > J Ø54.811），
   离 Ø56 上限只剩 **0.79 mm**。**热床和两个端盖要按 Ø55.210 留**，别照 J 的 Ø54.811 或 F 的 Ø49.95 做。
4. **行星架盘涨到 Ø43.84**（J 是 43.39）：4 个行星轮要占更大的圆周，架盘得跟着大一圈。
5. **重合度偏低**：行星-齿圈 1.301、太阳-行星 1.257 —— 九版里最低的是后加的 L（1.213 / 1.136），K 排在它前面。
   原因是 16 齿的太阳/行星对上 4 个行星轮的挤位，变位只能这么取。转动会比 J / F 略"硬"一点。
6. **零件数最多**：12 件塑料件（1 齿圈 + **8 行星轮** + 1 太阳轮 + 2 行星架），比 J / F 多 2 个行星轮。
   但行星轮尺寸小（Ø17.13、厚 3.10），8 个一起打也不费事。
7. **跨方案零件不能互换**：K 的模数 0.95、齿圈 48 齿但**内齿顶 Ø45.091**（J 是 Ø44.640），架盘 Ø43.84；
   和 C ~ J 的任何一件都配不上。**注意 K 和 J 的齿圈都是 48 齿、外径只差 0.40 mm，别拿混了。**

### 15.8 复现

```
cd work
$env:PLANETARY_RING="cont"
.\venv\Scripts\python.exe design_v3.py            # 解析全出，写 design_v3.json
.\venv\Scripts\python.exe build_parts.py K        # 出 STEP + STL 到 outputs\ring_cont\K_ratio16_4pl\
.\venv\Scripts\python.exe verify_int.py C D E F G H J K L   # 整数比专用校验报告（必须显式列方案）
.\venv\Scripts\python.exe _k_stress.py            # K 的齿根弯曲应力
.\venv\Scripts\python.exe check_exports_v3.py     # 全部方案的 STL 封闭性 / STEP 回读
.\venv\Scripts\python.exe draw2d.py               # 图纸（含九方案对照）
.\venv\Scripts\python.exe render3d.py K L         # 3D 渲染
.\venv\Scripts\python.exe scan_k4_geo.py          # 4 行星轮各候选总比的几何 + 应力扫描
```

> `verify_int.py` **不给参数时只跑「两级齿数不同」的方案（G / H）** —— 要 C ~ L 全套必须像上面那样把字母列全，
> 否则报告会被写短（这个坑 2026-09-30 踩过一次）。

## 16. 方案 L（25 : 1，每级 4 个行星轮）—— 2026-09-30 新增

家人 2026-09-30：「**那就放开 360 度 和 4096 重来**」—— 把「总比必须整除 360（电机圈数）或 4096（编码器）」
这条撤掉，重做一版 4 个行星轮。

### 16.1 放开这两条之后，为什么落在 25 : 1

把 15.2 节那张表按新口径重排，4 个行星轮 + 整数比能做得出来的只有 16 / 20 / 25 三个：

| 候选总比 | 拆法 | 360 ÷ r | 4096 ÷ r | 放开 360 / 4096 之后 | 4 行星轮做得出来吗 |
|---|---|---|---|---|---|
| 16 : 1 | 4 × 4 | 22.5 ❌ | **256 ✅** | 本来就行（靠 4096 进来的） | ✅ 16-16-48（= K），两级同件 |
| 20 : 1 | 4 × 5 | **18 ✅** | 204.8 ❌ | 本来就行（靠 360 进来的） | ✅ 16-16-48 ×4 / 12-18-48 ×4，**两级是两种行星轮** |
| **25 : 1** | 5 × 5 | 14.4 ❌ | 163.84 ❌ | **只有它被放开** | ✅ **12-18-48 ×4（= L）**，两级同件 |
| 22 : 1 | 4 × 5.5 | — | — | — | ❌ r = 5.5 那一级：12-21-54 连均布装配条件都过不了（(Zs+Zr) % 4 = 66 % 4 = 2）；(Zs+Zr) 能被 4 整除的组合（16-28-72）齿圈 **Ø77.16 > 56** ❌ |
| 24 / 21 / 18 / 28 : 1 | — | — | — | — | ❌ 无可行解（单级比撑不到 5.83 以上，见 15.1） |

**结论：放开 360 / 4096 真正解锁的只有 25 : 1**。（22 : 1 名义上也被放开，但 r = 5.5 那一级在 4 个行星轮下过不去 —— 12-21-54 不满足均布装配条件 (Zs+Zr) % 4 == 0，能满足的组合齿圈外径 Ø77.16；两问都用 `work\_probe_22.py` 现算过。）
25 : 1 还有个额外好处 —— 它正好是 **J 的那个比值**，齿数 12-18-48 一个字都不用改，
连「两级行星轮是同一个件」这条也保住了。

### 16.2 3 个行星轮改 4 个，哪些参数必须跟着改

齿数照 J，但行星轮从 3 个加到 4 个之后，相邻两个行星轮之间只剩 90°，
**净间隙从 J 的 6.166 mm 掉到 1.850 mm**（r = 5 已经贴着 4 行星轮能到的上限），
变位和齿顶高系数必须重配，否则齿顶会互相打架。下面这组是从 **128 组可行组合**里挑的
（扫描脚本 `work\_scan_l25.py`，结果 `work\_scan_l25_out.txt`；**全是设计值，没实测**）：

| 取舍项 | J（3 个行星轮） | **L（4 个行星轮）** | 为什么这么取 |
|---|---|---|---|
| 变位 x 太阳 / 行星 / 齿圈 | +0.300 / −0.030 / +0.240 | **+0.300 / +0.075 / +0.450** | 行星轮由负变正，把齿顶往回收，给相邻轮让位 |
| 齿顶高系数 太阳 / 行星 / 齿圈 | 1.15 / 1.25 / 1.00 | **1.15 / 1.15 / 1.00** | 行星轮齿顶高 1.25 → 1.15，齿顶圆小一圈 |
| 齿圈外径 | Ø54.811 | **Ø55.210** | 中心距 14.49185 → 14.57955，外径跟着涨 0.399 |
| 相邻行星轮净间隙 | 6.166 mm | **1.850 mm** | 4 个行星轮的几何代价，改不掉 |
| 齿顶厚 太阳 / 行星 / 齿圈 | 0.531 / 0.630 / 0.956 | **0.660 / 0.806 / 1.007** | 重配之后反而都比 J 厚（0.4 喷嘴更省心） |
| 重合度 太阳-行星 / 行星-齿圈 | 1.324 / 1.530 | **1.136 / 1.213** | 这是 L 相对 J 唯一明显退步的地方 |
| 单级空回（设计值） | 14.49′ | **14.50′** | 分度圆一样大，基本没变 |

### 16.3 最终参数（与 J / K 并列）

| 参数 | **方案 L（25 : 1，每级 4 个）** | 参照 J（25 : 1，每级 3 个） | 参照 K（16 : 1，每级 4 个） |
|---|---|---|---|
| 两级总减速比 | **25.0000 : 1 = 5.0 × 5.0** | 25.0000 : 1 = 5.0 × 5.0 | 16.0000 : 1 = 4.0 × 4.0 |
| 模数 m / 压力角 | **0.95 / 20°** | 0.95 / 20° | 0.95 / 20° |
| 齿数 太阳 / 行星 / 齿圈 | **12 / 18 / 48**（两级相同） | 12 / 18 / 48（两级相同） | 16 / 16 / 48（两级相同） |
| 行星轮 | **一种件、共 8 个（每级 4 个）** | 一种件、共 6 个 | 一种件、共 8 个 |
| 齿圈（= 外壳）外径 / 壁厚 / 长 | **Ø55.210 / 3.00 / 10.70** | Ø54.811 / 3.00 / 10.70 | Ø55.210 / 3.00 / 10.70 |
| 齿圈 内齿顶 Ø / 内齿根 Ø | **45.214 / 49.210 mm** | 44.640 / 48.811 mm | 45.091 / 49.210 mm |
| 中心距 a / 啮合角 α_w | **14.57955 mm / 23.2992°** | 14.49185 / 22.4804° | 15.46815 / 22.5713° |
| 变位 x 太阳 / 行星 / 齿圈 | **+0.300 / +0.075 / +0.450** | +0.300 / −0.030 / +0.240 | +0.150 / +0.150 / +0.450 |
| 齿顶高系数 太阳 / 行星 / 齿圈 | **1.15 / 1.15 / 1.00** | 1.15 / 1.25 / 1.00 | 1.15 / 1.15 / 1.00 |
| 齿厚减薄 thin（每齿总量） | **0.030 mm**（每侧 0.015） | 0.030 mm | 0.030 mm |
| 太阳轮 齿顶 Ø / 齿根 Ø | **13.496 / 9.595** | 13.671 / 9.595 | 17.134 / 13.110 |
| 行星轮 齿顶 Ø / 齿根 Ø / 内孔 Ø | **18.768 / 14.867 / 7.00** | 18.934 / 14.668 / 7.00 | 17.134 / 13.110 / 7.00 |
| 行星轮 齿宽 / 内孔壁厚（齿根处） | **3.10 mm / 3.934 mm** | 3.10 / 3.834 | 3.10 / 3.055 |
| 行星架盘 Ø / 销轴 Ø | **43.96 / 4.06** | 43.39 / 4.06 | 43.84 / 4.06 |
| 齿顶厚 太阳 / 行星 / 齿圈 | **0.660 / 0.806 / 1.007 mm** | 0.531 / 0.630 / 0.956 | 0.694 / 0.694 / 0.963 |
| 重合度 太阳-行星 / 行星-齿圈 | **1.136 / 1.213** | 1.324 / 1.530 | 1.257 / 1.301 |
| 设计背隙 太阳-行星 / 行星-齿圈 | **0.0602 / 0.0600 mm** | 0.0601 / 0.0599 | 0.0601 / 0.0600 |
| 单级空回 / 两级输出侧空回 | **14.50′ / 17.40′** | 14.49′ / 17.39′ | 13.59′ / 16.98′ |
| 两级输入侧空回 | **86.98′ = 1.45°** | 86.94′ = 1.45° | 67.94′ = 1.13° |
| 相邻行星轮净间隙 | **1.850 mm** | 6.166 mm | 4.742 mm |
| 齿根弯曲 @ 输出 4 N·m（行星轮 / 每根销轴受力） | **45.9 MPa / 68.6 N** | 75.5 MPa / 92.0 N | 44.2 MPa / 64.6 N |
| 齿面干涉面积（整圈扫描） | **0.000000 mm²** | 0.000000 mm² | 0.000000 mm² |

### 16.4 L 的 `thin` ↔ 背隙

`thin` 是"每个齿的齿厚减薄总量"，**背隙与它成正比**（线性，这就是它的定义）。L 的表（`work\backlash_table_int.txt` 第 9 套，
口径与 C ~ K 相同，**都是解析 + 多边形模型算出来的设计值，没实测**）：

| thin（mm） | 太阳-行星 (mm) | 行星-齿圈 (mm) | 单级空回 | 两级输出侧 | 两级输入侧 |
|---|---|---|---|---|---|
| 0.020 | 0.0402 | 0.0400 | 9.67′ | 11.60′ | 58.02′ |
| **0.030 ★ 交付版** | **0.0602** | **0.0600** | **14.50′** | **17.40′** | **86.98′ = 1.45°** |
| 0.040 | 0.0802 | 0.0800 | 19.32′ | 23.19′ | 115.94′ |
| 0.060 | 0.1202 | 0.1200 | 28.97′ | 34.76′ | 173.80′ |
| 0.080 | 0.1602 | 0.1600 | 38.61′ | 46.33′ | 231.67′ |
| 0.100 | 0.2001 | 0.2000 | 48.26′ | 57.91′ | 289.57′ |

（`thin = 0.015` 那一行没列：减薄量已经低于多边形模型的解析度，算出来是假的 —— 和第 7 节末尾同一条。）

九套（C ~ L）的完整表在 `work\backlash_table_int.txt`。

### 16.5 校验结果（与 C ~ K 同一套脚本、同一个标准）

- 剖面积 CAD vs 多边形模型：齿圈 **−0.0012 %**、行星轮 **−0.0112 %**、太阳轮 **−0.0036 %**
- **44 对**两两 CAD 布尔交（**32 对行星-对件 + 12 对行星-行星** —— 一级 4 个 + 二级 4 个，行星之间也两两查）：
  最大 |体积| = **0.000000000 mm³**；对照组（行星轮与自己）= 574.807 mm³，正好等于该件实体积
- 齿圈 / 太阳轮 / 两个行星架两两布尔交：**0**
- 整圈运动扫描（一个齿距 240 步 + 整圈 720 步）：三相干涉全 **0.000e+00 mm²**
- 齿圈内齿顶 Ø45.214 vs 行星架盘 Ø43.96：单边让位 **0.6271 mm**（实物布尔交 = 0）
- 6 个 STL：开放 / 非流形边 **= 0**；6 个 STEP 全部回读成功，零件 `solids=1`、装配 `solids=12`，
  装配 STL 体积与逐件求和差 **0.0003 mm³**
- 齿根弯曲（`work\_l_stress.py`，与 J / K 同一套算法）：输出 4 N·m 时行星轮 **45.9 MPa**、太阳轮 45.0、齿圈 18.8；
  每根行星销受力 **68.6 N**（J 是 92.0 N）
- 装配相位（`verify_int.py` [3.1] + `build_parts.py` 的 info 行）：4 个行星轮 **10.0000° × 2 / 0.0000° × 2**（两组，差半个齿距）
- 需求核对：齿圈 Ø55.210 ≤ 56 ✅ / 总比 25.000000 是严格整数 ✅ / 太阳轮 Ø5 孔深 8.00 ≥ 5 ✅ /
  行星轮内孔 Ø7.00 ✅ / 行星轮齿宽 3.10 ∈ [3.0, 3.2] ✅ / 无根切 ✅ / 无干涉 ✅
  （**360 ÷ 25 = 14.4、4096 ÷ 25 = 163.84 都不整除** —— 这一版是按"放开这两条"选的，见 16.1）

原始报告：`outputs\ring_cont\验证报告_连续内齿_整数比方案.txt`（含 G / H / J / K / L）、
`验证报告_连续内齿_导出文件检查.txt`、`验证报告_方案L_齿根弯曲应力.txt`。

### 16.6 取舍 —— 哪些地方比别版差（老实说）

1. **同一级的 4 个行星轮分两种摆放相位**：Zs + Zp = 12 + 18 = 30，30 % 4 = 2 ≠ 0，
   所以 4 个轮分两组（10.0000° × 2 / 0.0000° × 2，相差半个齿距 = 10°）。
   **零件还是同一个件**（插入后每个轮只有一种角度能落到位，对着齿槽一转就到位），
   但不像 K 那样"一个角度通吃"—— 这是 k = 4 配 12-18-48 的必然结果。
2. **行星轮 6 → 8 个**：两个行星架各 4 根销轴，行星架盘 Ø43.39 → **Ø43.96**；多打 2 个行星轮。
3. **齿圈 Ø55.210**：比 J 大 0.399 mm，离 Ø56 只剩 0.79 mm。**它和 K 的外径完全相同**，
   但齿数组合不同（K 16-16-48 / L 12-18-48），内齿顶也不同（K Ø45.091 / L Ø45.214）—— **别拿混了**。
4. **重合度 1.136 / 1.213，是九版里最低的**：转起来比 J / F 略"硬"一点。
5. **不整除 360 / 4096**：控制上不能像 K 那样"输出一圈 = 256 个编码器计数"。
   换回来的是**减速比 25（K 是 16）** —— 同样输入扭矩下输出扭矩多 56%，而齿根应力还比 K 略低。
6. 相对 J 的**好处**（同一个 25 : 1）：每根销轴受力 **92.0 → 68.6 N**、行星轮齿根 **75.5 → 45.9 MPa**、
   三个齿顶厚全面变厚（0.660 / 0.806 / 1.007），而空回几乎没变（17.40′ vs 17.39′）。

### 16.7 复现

```
cd work
$env:PLANETARY_RING="cont"
.\venv\Scripts\python.exe design_v3.py                # 解析全出，写 design_v3.json
.\venv\Scripts\python.exe build_parts.py L            # 出 STEP + STL 到 outputs\ring_cont\L_ratio25_4pl\
.\venv\Scripts\python.exe verify_int.py C D E F G H J K L   # 整数比专用校验报告（必须显式列方案）
.\venv\Scripts\python.exe _l_stress.py                # L 的齿根弯曲应力
.\venv\Scripts\python.exe check_exports_v3.py C D E F G H J K L   # STL 封闭性 / STEP 回读
.\venv\Scripts\python.exe draw2d.py                   # 图纸（含九方案对照）
.\venv\Scripts\python.exe render3d.py L               # 3D 渲染
.\venv\Scripts\python.exe _scan_l25.py                # 25 : 1 / 4 行星轮的 128 组可行解扫描
```

> **L 这一版顺带改掉了 `build_parts.py` 里一个隐藏前提**：原来装配体里 k 个行星轮是按**同一个**自转角摆的，
> 那只在 `(Zs + Zp) % k == 0` 时成立（K 是 16+16 = 32，32 % 4 = 0，所以没露出来）。
> L 的 12 + 18 = 30，30 % 4 = 2 —— 现在改成从 `stage_lib` 逐个取行星轮自己的相位，
> 并把这条件单独写成断言。**校验报告 [2] 段那 44 对布尔交就是照着这个装配体做的。**

---

## 17. 方案 M（25 : 1，齿厚 4 mm，齿圈两端各多留 1 mm）—— 2026-10-16 新增

家人 2026-10-16：「**把齿轮的厚度加到 4mm, 最外圈多留出 1mm 的厚度 就是总超过总高度 2mm**」
（追问确认为：① 齿轮齿厚 **3.10 → 4.00**；② **齿圈**两端各比齿轮组多留 **1.00**；③ 做 **25 : 1（= 方案 L）**这一版。）

### 17.1 只改了两处

齿数、模数、压力角、变位、齿顶高系数、齿厚减薄 thin、齿圈壁厚、行星轮内孔 Ø7、销轴 Ø4.06、
行星架盘 Ø43.96 —— **一个数字都没动**，全部照抄 L。改的只有：

| 参数 | L | **M** |
|---|---|---|
| 齿轮齿厚 `face` / `planet_w`（太阳轮 / 行星轮 / 齿圈内齿） | 3.10 mm | **4.00 mm** |
| 齿圈两端各比**齿轮组**多留 `ring_over` | （老口径，相对行星架盘留 0.30 / 0.60） | **1.00 / 1.00** |
| 齿圈长 | 10.70 | **13.60** |
| 整机总高 | 27.10 | **28.90** |

`part_layout.py` 为此新增了 `ring_over` 分支：**只在方案写了 `ring_over` 时才走**，
所以 C ~ L 的 Z 链一个数没变（`work\_chk_M_chain.py` 逐值对过：L 的链「改前 = 改后」为 True）。

### 17.2 轴向尺寸链

见第 4 节末尾 M 的表（轮毂 −6.00…0 / 齿轮组 0.00…11.60 / 齿圈 −1.00…12.60 / 总高 28.90）。

### 17.3 最终参数（与 L / J 并列）

| 参数 | **方案 M（25 : 1，齿厚 4）** | 参照 L（25 : 1，齿厚 3.10） | 参照 J（25 : 1，每级 3 个） |
|---|---|---|---|
| 两级总减速比 | **25.0000 : 1 = 5.0 × 5.0** | 25.0000 : 1 | 25.0000 : 1 |
| 模数 m / 压力角 | **0.95 / 20°** | 0.95 / 20° | 0.95 / 20° |
| 齿数 太阳 / 行星 / 齿圈 | **12 / 18 / 48**（两级相同） | 12 / 18 / 48 | 12 / 18 / 48 |
| 行星轮 | **一种件、共 8 个（每级 4 个）** | 一种件、共 8 个 | 一种件、共 6 个 |
| **齿轮齿厚** | **4.00 mm** | 3.10 mm | 3.10 mm |
| 齿圈 外径 / 壁厚 / 长 | **Ø55.210 / 3.00 / 13.60** | Ø55.210 / 3.00 / 10.70 | Ø54.811 / 3.00 / 10.70 |
| 齿圈 内齿顶 Ø / 内齿根 Ø | **45.214 / 49.210** | 45.214 / 49.210 | 44.640 / 48.811 |
| 中心距 a / 啮合角 α_w | **14.57955 mm / 23.2992°** | 14.57955 / 23.2992° | 14.49185 / 22.4804° |
| 变位 x 太阳 / 行星 / 齿圈 | **+0.300 / +0.075 / +0.450** | 同左 | +0.300 / −0.030 / +0.240 |
| 齿顶高系数 太阳 / 行星 / 齿圈 | **1.15 / 1.15 / 1.00** | 同左 | 1.15 / 1.25 / 1.00 |
| 齿厚减薄 thin（每齿总量） | **0.030 mm**（每侧 0.015） | 0.030 mm | 0.030 mm |
| 太阳轮 齿顶 Ø / 齿根 Ø | **13.496 / 9.595** | 13.496 / 9.595 | 13.671 / 9.595 |
| 行星轮 齿顶 Ø / 齿根 Ø / 内孔 Ø | **18.768 / 14.867 / 7.00** | 18.768 / 14.867 / 7.00 | 18.934 / 14.668 / 7.00 |
| 行星轮 内孔壁厚（齿根处） | **3.934 mm** | 3.934 mm | 3.834 mm |
| 行星架盘 Ø / 销轴 Ø | **43.96 / 4.06** | 43.96 / 4.06 | 43.39 / 4.06 |
| 齿顶厚 太阳 / 行星 / 齿圈 | **0.660 / 0.806 / 1.007** | 同左 | 0.531 / 0.630 / 0.956 |
| 重合度 太阳-行星 / 行星-齿圈 | **1.136 / 1.213** | 同左 | 1.324 / 1.530 |
| 设计背隙 太阳-行星 / 行星-齿圈 | **0.0602 / 0.0600 mm** | 同左 | 0.0601 / 0.0599 |
| 单级空回 / 两级输出侧空回 | **14.50′ / 17.40′** | 14.50′ / 17.40′ | 14.49′ / 17.39′ |
| 两级输入侧空回 | **86.98′ = 1.45°** | 86.98′ = 1.45° | 86.94′ = 1.45° |
| 相邻行星轮净间隙 | **1.850 mm** | 1.850 mm | 6.166 mm |
| 齿根弯曲 @ 输出 4 N·m（行星轮 / 每根销轴受力） | **35.5 MPa / 68.6 N** | 45.9 MPa / 68.6 N | 75.5 MPa / 92.0 N |
| 齿面干涉面积（整圈扫描） | **0.000000 mm²** | 0.000000 mm² | 0.000000 mm² |
| 单套 5 种件 / 整机（STEP 回读） | **20983.964 / 26173.194 mm³** | — | — |

### 17.4 M 的 `thin` ↔ 背隙

**M 的表与 L 的表逐格相同**（轴向加厚不动啮合，这是跑 `backlash_sweep_int.py` 对出来的）：

| thin（mm） | 太阳-行星 (mm) | 行星-齿圈 (mm) | 单级空回 | 两级输出侧 | 两级输入侧 |
|---|---|---|---|---|---|
| 0.020 | 0.0402 | 0.0400 | 9.67′ | 11.60′ | 58.02′ |
| **0.030 ★ 交付版** | **0.0602** | **0.0600** | **14.50′** | **17.40′** | **86.98′ = 1.45°** |
| 0.040 | 0.0802 | 0.0800 | 19.32′ | 23.19′ | 115.94′ |
| 0.060 | 0.1202 | 0.1200 | 28.97′ | 34.76′ | 173.80′ |
| 0.080 | 0.1602 | 0.1600 | 38.61′ | 46.33′ | 231.67′ |
| 0.100 | 0.2002 | 0.2000 | 48.26′ | 57.91′ | 289.57′ |

### 17.5 校验结果（与 C ~ L 同一套脚本、同一个标准）

- 剖面积 CAD vs 多边形模型：齿圈 **−0.0012 %**（675.879 / 675.887 mm²）、行星轮 **−0.0112 %**、太阳轮 **−0.0036 %**
- **44 对**两两 CAD 布尔交：最大 |体积| = **0.000000000 mm³**；
  对照组（行星轮与自己）= **742.277 mm³**，正好等于该件实体积
- 齿圈 / 太阳轮 / 两个行星架两两布尔交：**0**
- 整圈运动扫描（一个齿距 240 步 + 整圈 720 步）：三相干涉全 **0.000e+00 mm²**
- 齿圈内齿顶 Ø45.214 vs 行星架盘 Ø43.96：单边让位 **0.6271 mm**
- 6 个 STL：开放 / 非流形边 **= 0**；6 个 STEP 全部回读成功，零件 `solids=1`、装配 `solids=12`，
  装配 STL 体积与逐件求和差 **0.0003 mm³**（26173.195 vs 26173.194 mm³）
- 齿根弯曲（`work\_m_stress.py`，与 J / K / L 同一套算法）：输出 4 N·m 时行星轮 **35.5 MPa**、太阳轮 34.8、齿圈 14.6；
  每根行星销受力 **68.6 N**。**加厚把行星轮齿根从 45.9（L）降到 35.5 MPa，即 77 %**
- 需求核对：**ALL REQUIREMENTS MET** —— 齿圈 Ø55.210 ≤ 56 ✅ / 总比 25.000000 严格整数 ✅ /
  太阳轮 Ø5 孔深 8.90 ≥ 5 ✅ / 行星轮内孔 Ø7.00 ✅ / 行星轮齿宽 4.00 ∈ [4.00, 4.00] ✅ / 无根切 ✅ / 无干涉 ✅
- `design_v3.py` 重跑（11 套）exit=0；**C ~ L 逐字段与改动前一致、无漂移**

原始报告：`outputs\ring_cont\验证报告_连续内齿_整数比方案.txt`（十套）、
`验证报告_连续内齿_导出文件检查.txt`、`验证报告_方案M_齿根弯曲应力.txt`。

### 17.6 取舍 —— 哪些地方比别版差（老实说）

1. **轴向变长**：整机 27.10 → **28.90 mm**，齿圈 10.70 → **13.60 mm**。
   **旧 J / L 的端盖盖不住 M**，您自己画的端盖要按 **齿圈 −1.00 / 12.60、轮毂端面 −6.00、凸台顶 22.90** 重画。
2. **M 的 5 个打印件与 L 不通用**：行星轮厚 0.90（销轴长度、行星架销孔、Z 分层全跟着走）、
   齿圈高 2.90、输入太阳轮齿区 3.10 → 4.00。**别混装。**
3. **换来的好处**：同为输出 4 N·m，行星轮齿根 **45.9 → 35.5 MPa**（降到 77 %）、
   齿面接触面积也大了 29 %（3.10 → 4.00）—— 但**齿面接触应力这一项本轮没有算**，
   上面只有齿根弯曲。
4. **齿圈 Ø55.210 没变**，离 Ø56 仍是 0.79 mm —— 加厚走的是轴向，没有多占径向。
5. 背隙、空回、重合度、齿顶厚这些**与 L 完全一样**（不是"差不多"，是逐格相同）。

### 17.7 复现

```
cd work
$env:PLANETARY_RING="cont"
.\venv\Scripts\python.exe design_v3.py                     # 解析全出（含 M），写 design_v3.json
.\venv\Scripts\python.exe build_parts.py M                 # 出 STEP + STL 到 outputs\ring_cont\M_ratio25_4pl_4mm\
.\venv\Scripts\python.exe verify_int.py C D E F G H J K L M   # 整数比专用校验（必须显式列方案）
.\venv\Scripts\python.exe _m_stress.py                     # M 的齿根弯曲应力
.\venv\Scripts\python.exe check_exports_v3.py C D E F G H J K L M   # STL 封闭性 / STEP 回读
.\venv\Scripts\python.exe draw2d.py                        # 图纸（方案对照现为十列 C ~ M）
.\venv\Scripts\python.exe render3d.py M                    # 3D 渲染
.\venv\Scripts\python.exe _chk_M_chain.py                  # 核对 M 的 z 链 + L 有没有被带偏
.\venv\Scripts\python.exe build_M_input_sun_gear_only.py   # M 的「只有齿轮」版
.\venv\Scripts\python.exe build_N_input_sun_gear_only.py   # N 的「只有齿轮」版
```

> 未验证：**没有打印、没有实测背隙**。打印后实际背隙一定大于设计值 17.40′（输出侧），大多少**没有数据**；
> 量法见 `注意事项_打印与装配.md` 第 6 节。

---

## 18. 方案 N（M 的「背隙收一半」试制版，thin 0.015）—— 2026-10-16 新增

### 18.1 只改了一个数

齿形、齿宽（4.00）、齿圈高度（13.60）、整机高度（28.90）、内孔、销轴、行星架的 Z 分层
**与 M 一字不改**，只有 **`thin` 0.030 → 0.015**（每齿两侧总共少削 0.015，每侧削 0.0075）。

| 参数 | M | **N** |
|---|---|---|
| thin（每齿总量 / 每侧） | 0.030 / 0.015 mm | **0.015 / 0.0075 mm** |
| 齿侧间隙 太阳-行星 / 行星-齿圈 | 0.0602 / 0.0600 mm | **0.0302 / 0.0300 mm** |
| 齿顶厚 太阳 / 行星 / 齿圈 | 0.660 / 0.806 / 1.007 | **0.678 / 0.822 / 1.022 mm** |
| 齿顶 Ø / 齿根 Ø / 中心距 / 齿圈外径 | 13.496 / 9.595 / 14.57955 / Ø55.210 | **完全相同** |
| 两级输出侧空回 | 17.40′（算出来的） | **约 8.7′（外推，不可算 —— 见 18.2）** |
| 单套 5 种件 / 整机 | 20983.964 / 26173.194 mm³ | 21009.119 / 26212.841 mm³ |

### 18.2 ⚠️ 这一版的空回算不出来，8.7′ 是外推值

背隙/空回是用**多边形模型**（每齿廓 40 段）算的。thin 0.030 时模型还有解析度；
**thin 0.015 时那点减薄量已经小于离散误差**，`verify_int.py` 对 N 直接输出：

```
single-mesh backlash: planet-sun 0.0302 mm  planet-ring 0.0300 mm  | carrier lost motion 0.00000 deg = 0.00 arcmin
[3.3] two-stage lost motion ... output play (input locked)  = 0.00000 deg = 0.00 arcmin
```

**`0.00000` 是假值**，不是"真的没背隙"。所以空回只能用 thin 的线性关系外推 ——
报告里 thin 0.020 / 0.030 / 0.040 三点完美落在一条**过原点**的直线上（斜率 **482.7 角分每 mm**）：

| thin | 单级空回 | 两级输出侧 | 两级输入侧 |
|---|---|---|---|
| 0.030（M，**算出来的**） | 14.50′ | 17.40′ | 86.98′ |
| 0.020（**算出来的**） | 9.67′ | 11.60′ | 58.02′ |
| **0.015（N，外推）** | **7.24′** | **8.69′** | **43.5′** |

**齿侧间隙那两行（0.0302 / 0.0300 mm）是解析计算的、可信；空回角度是外推的、要实测。**
（`work\backlash_table_int.txt` 里**没有 N 这一套** —— 因为这个表就是这么算的，对 N 只会给出假值。
要让它对 N 可信，得提高 `n_flank` 重跑，本次没有做。）

### 18.3 校验结果（与 C ~ M 同一套脚本、同一个标准）

- 剖面积 CAD vs 多边形模型：齿圈 **−0.0011 %**、行星轮 −0.0111 %、太阳轮 −0.0035 %
- 两两 CAD 布尔交 **44 对**：最大 |体积| = **0.000000000 mm³**；对照组 = **744.349 mm³**（= 该件实体积）
- 整圈运动扫描（一齿距 240 步 + 整圈 720 步）：三相干涉全 **0.000e+00 mm²**
- 6 个 STL 开放 / 非流形边 **全部 = 0**；6 个 STEP 回读成功，零件 `solids=1`、装配 `solids=12`，
  装配 STL 体积与逐件求和差 **0.0003 mm³**
- 齿根弯曲（`work\_n_stress.py`）：输出 4 N·m 时行星轮 **35.0 MPa**、太阳轮 34.3、齿圈 14.3；
  每根行星销 68.6 N。反推（行星轮）：许用 30 MPa → 3.43 N·m、**40 MPa → 4.57 N·m**
- 需求核对：**ALL REQUIREMENTS MET**

原始报告：`outputs\ring_cont\验证报告_连续内齿_整数比方案.txt`（十一套）、
`验证报告_连续内齿_导出文件检查.txt`、`验证报告_方案N_齿根弯曲应力.txt`。

### 18.4 用它之前要知道的四件事

1. **它是试制件，不是替换版**。设计上"应该"把背隙收一半，但**这一半能不能兑现要实测** ——
   打印件齿厚本身的偏差通常就在 0.01~0.05 mm 这个量级，正好和这半刀是同一个数量级。
2. **N 与 M 的件不能混装**：每齿厚度差 0.015 mm，混装后测出来的数既不是 17.40′ 也不是 8.69′，
   等于白测。**打 N 的时候把 M 的件收起来。**
3. **缝小一半，对毛刺和齿厚偏差敏感一倍**：装之前把齿圈内齿、行星轮齿廓的毛刺清干净，
   比 0.030 那版更要紧。**如果装完转不动/明显发涩**，说明您打印件的齿厚是偏厚的，
   那就回到 thin 0.030，或者在切片器里对 `02_planet_gear` / `03_input_sun` 做一点负的 XY 补偿。
4. **怎么量**：按 `注意事项_打印与装配.md` 第 6 节（输入端夹死、齿圈固定、输出凸台上 50 mm 摆臂 + 百分表）。
   **1 mm 端点位移 = 68.75′**，所以 N 的设计预期是 **0.127 mm** 端点位移，M 是 **0.253 mm** ——
   差一倍，打印件一致性够好的话量得出来。**两版都量为好。**

### 18.5 复现

```
cd work
$env:PLANETARY_RING="cont"
.\venv\Scripts\python.exe design_v3.py                       # 解析全出（含 N），写 design_v3.json
.\venv\Scripts\python.exe build_parts.py N                   # 出 STEP + STL 到 outputs\ring_cont\N_ratio25_4pl_4mm_thin15\
.\venv\Scripts\python.exe verify_int.py C D E F G H J K L M N   # 整数比专用校验（必须显式列方案）
.\venv\Scripts\python.exe _n_stress.py                       # N 的齿根弯曲应力
.\venv\Scripts\python.exe check_exports_v3.py N              # STL 封闭性 / STEP 回读
.\venv\Scripts\python.exe draw2d.py                          # 图纸（方案对照现为十一列 C ~ N）
.\venv\Scripts\python.exe render3d.py N                      # 3D 渲染
.\venv\Scripts\python.exe build_N_input_sun_gear_only.py     # N 的「只有齿轮」版
.\venv\Scripts\python.exe make_N_input_gear_only_figs.py     # 该版的图纸 + 渲染
```

> 未验证：**没打印、没实测背隙** —— 这一版的核心数字（8.69′）就是外推的，等实物。

### 18.6 N 的输入轮「只有齿轮」版（2026-10-16 追加）

家人要的「不带其他东西的太阳轮」= 把 N 整机的输入轮（Ø10×6 轮毂 + Ø5 D 盲孔）外面的东西全部去掉，
只留齿轮本体：**12 齿 × m0.95、齿宽 4.00、thin 0.015**，z 0.00 … 4.00。
目录 `outputs\ring_cont\N_ratio25_gear_only\`（做法与 J / L / M 的「只有齿轮」版同一套，只换方案）。

- 三件只差中心孔：A `03_input_sun_gear_only.step`（Ø6 通孔，**311.359 mm³**）、
  B `..._D5.step`（Ø5 D 通孔，**351.102 mm³**）、C `..._solid.step`（实心，**427.606 mm³**）。
- 与 M 那套同孔型逐件比，**每件正好 +1.422 mm³**（= 齿加厚 0.015 多出来的料）；
  这个差值也与整机 `03_input_sun` 的差（729.963 − 728.541 = 1.422）对得上。
- 核对：z = 1.00 处截面积 **88.2884 mm²**，与已交付的 `N_ratio25_4pl_4mm_thin15\03_input_sun.step` 相同；
  装进 N 整机后与其余 11 件逐对布尔交 **全部 0**；`00_assembly.step` 回读 12 个 solid、25891.737 mm³，
  交叉自证 25891.737 + 418.604 = 26310.341 ↔ 整机回读 26310.342。
- **N 与 M 的「只有齿轮」件也不能混用**（每齿差 0.015 mm），替整机件时要整套换。

图纸 / 渲染在同目录：`图纸_N输入轮_只有齿轮_尺寸.png`、`渲染1~3.png`。
详情：`说明_N输入轮_只有齿轮.md`。
