bjthemost-hub/l103-drv8313-as5600/hardware/docs/CH32L103_generated_v2.png

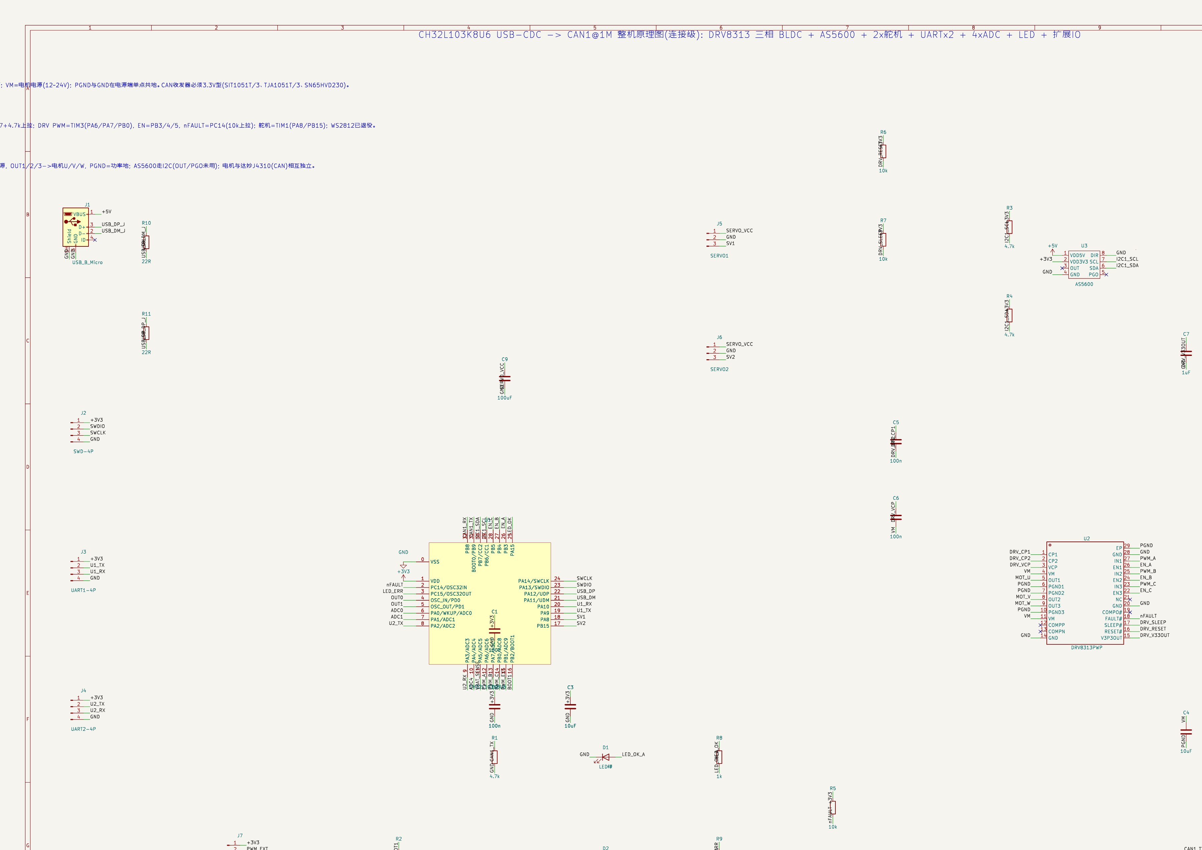
hardware/docs/CH32L103_generated_v2.png
