bjthemost-hub/l103-drv8313-as5600/hardware/docs/原理图_整机_v3.png

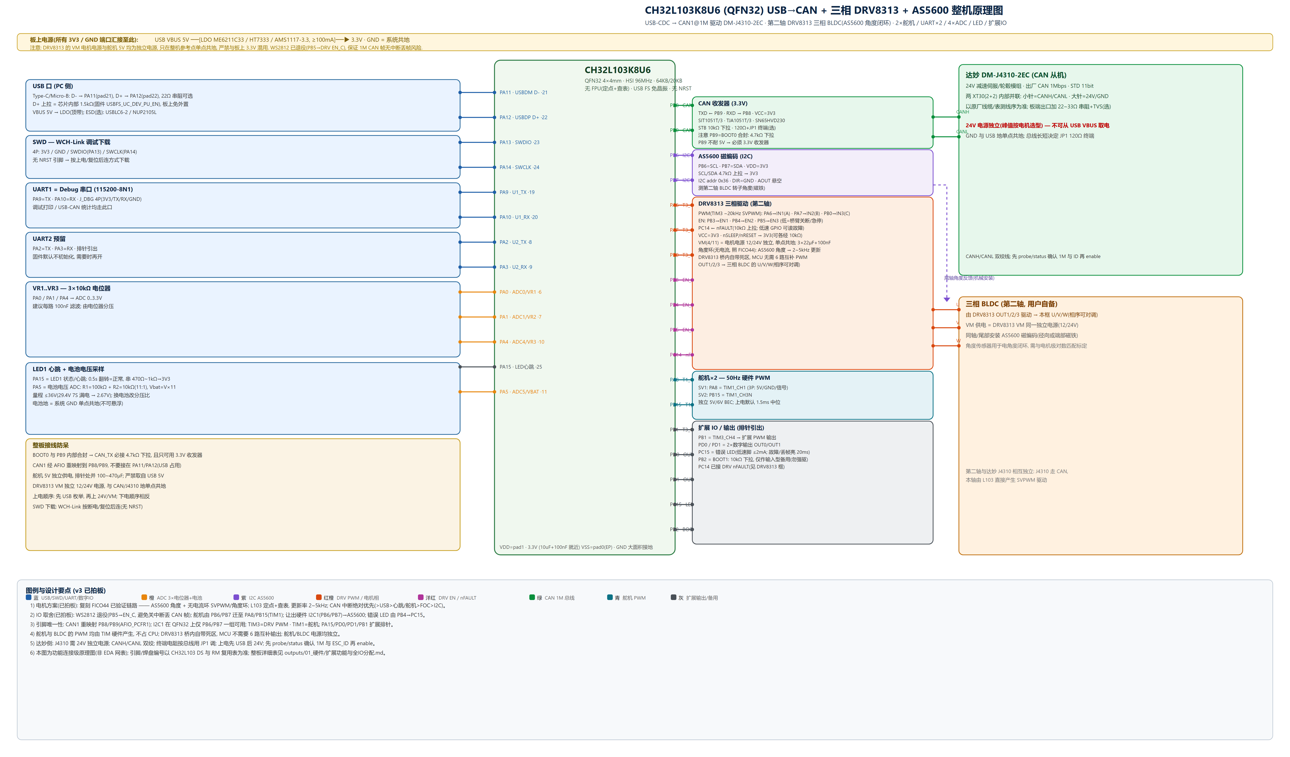
hardware/docs/原理图_整机_v3.png
