bjthemost-hub/l103-drv8313-as5600/gearbox-J/J_ratio25/01_ring_gear.step

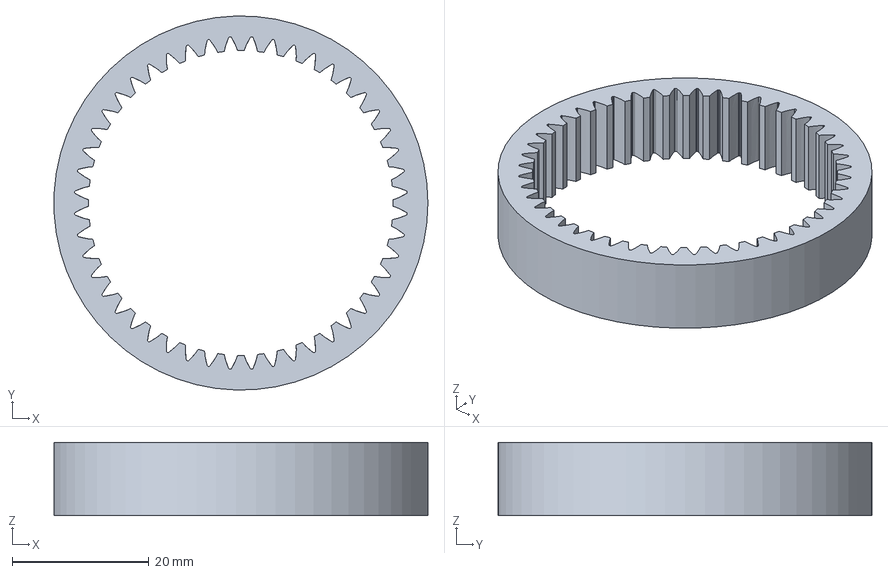
[picture p7: CAD file, 2026-10-27]
gearbox-J/J_ratio25/01_ring_gear.step
54.8 x 54.8 x 10.7 mm
