bjthemost-hub/l103-drv8313-as5600/gearbox-J/J_ratio25/04_carrier1_sun2.step

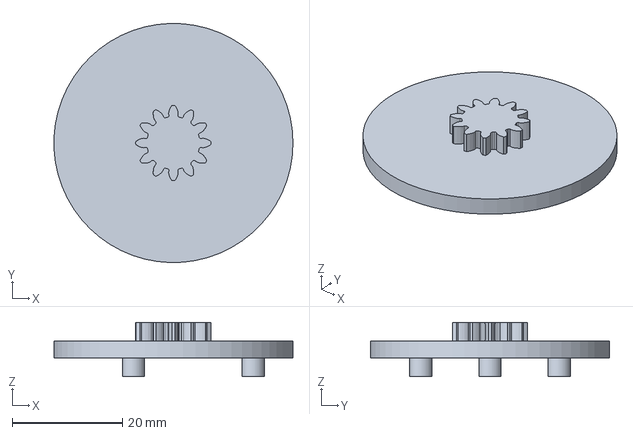
[picture p8: CAD file, 2026-10-27]
gearbox-J/J_ratio25/04_carrier1_sun2.step
43.4 x 43.4 x 9.80 mm
