bjthemost-hub/l103-drv8313-as5600/gearbox-J/J_ratio25/05_output_carrier.step

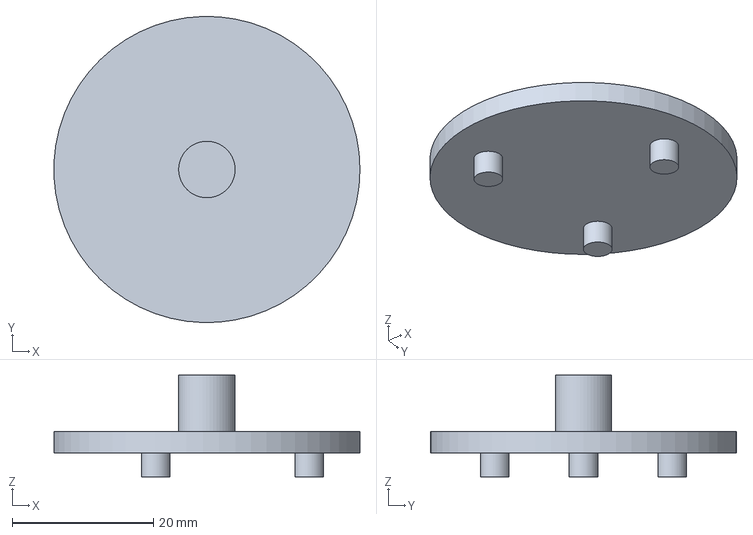
[picture p9: CAD file, 2026-10-27]
gearbox-J/J_ratio25/05_output_carrier.step
43.4 x 43.4 x 14.4 mm
