bjthemost-hub/l103-drv8313-as5600/hardware/L103_CANUSB_DRV8313.pdf

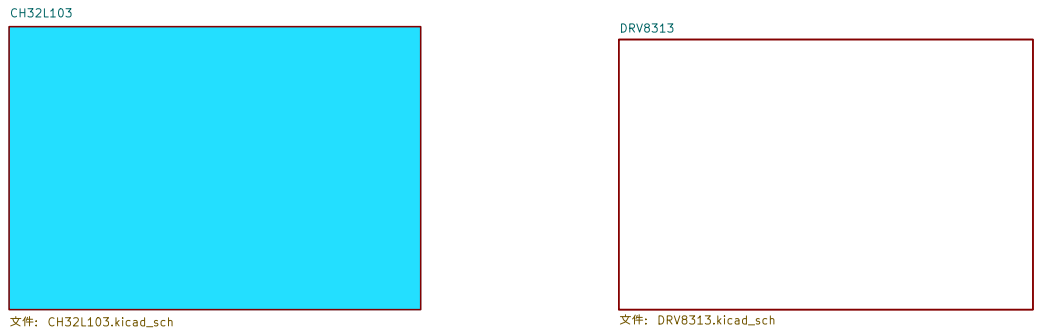
[picture p10: page 1]

Size: A4 | Rev:
KiCad E.D.A. 10.0.0 | Id: 1/3

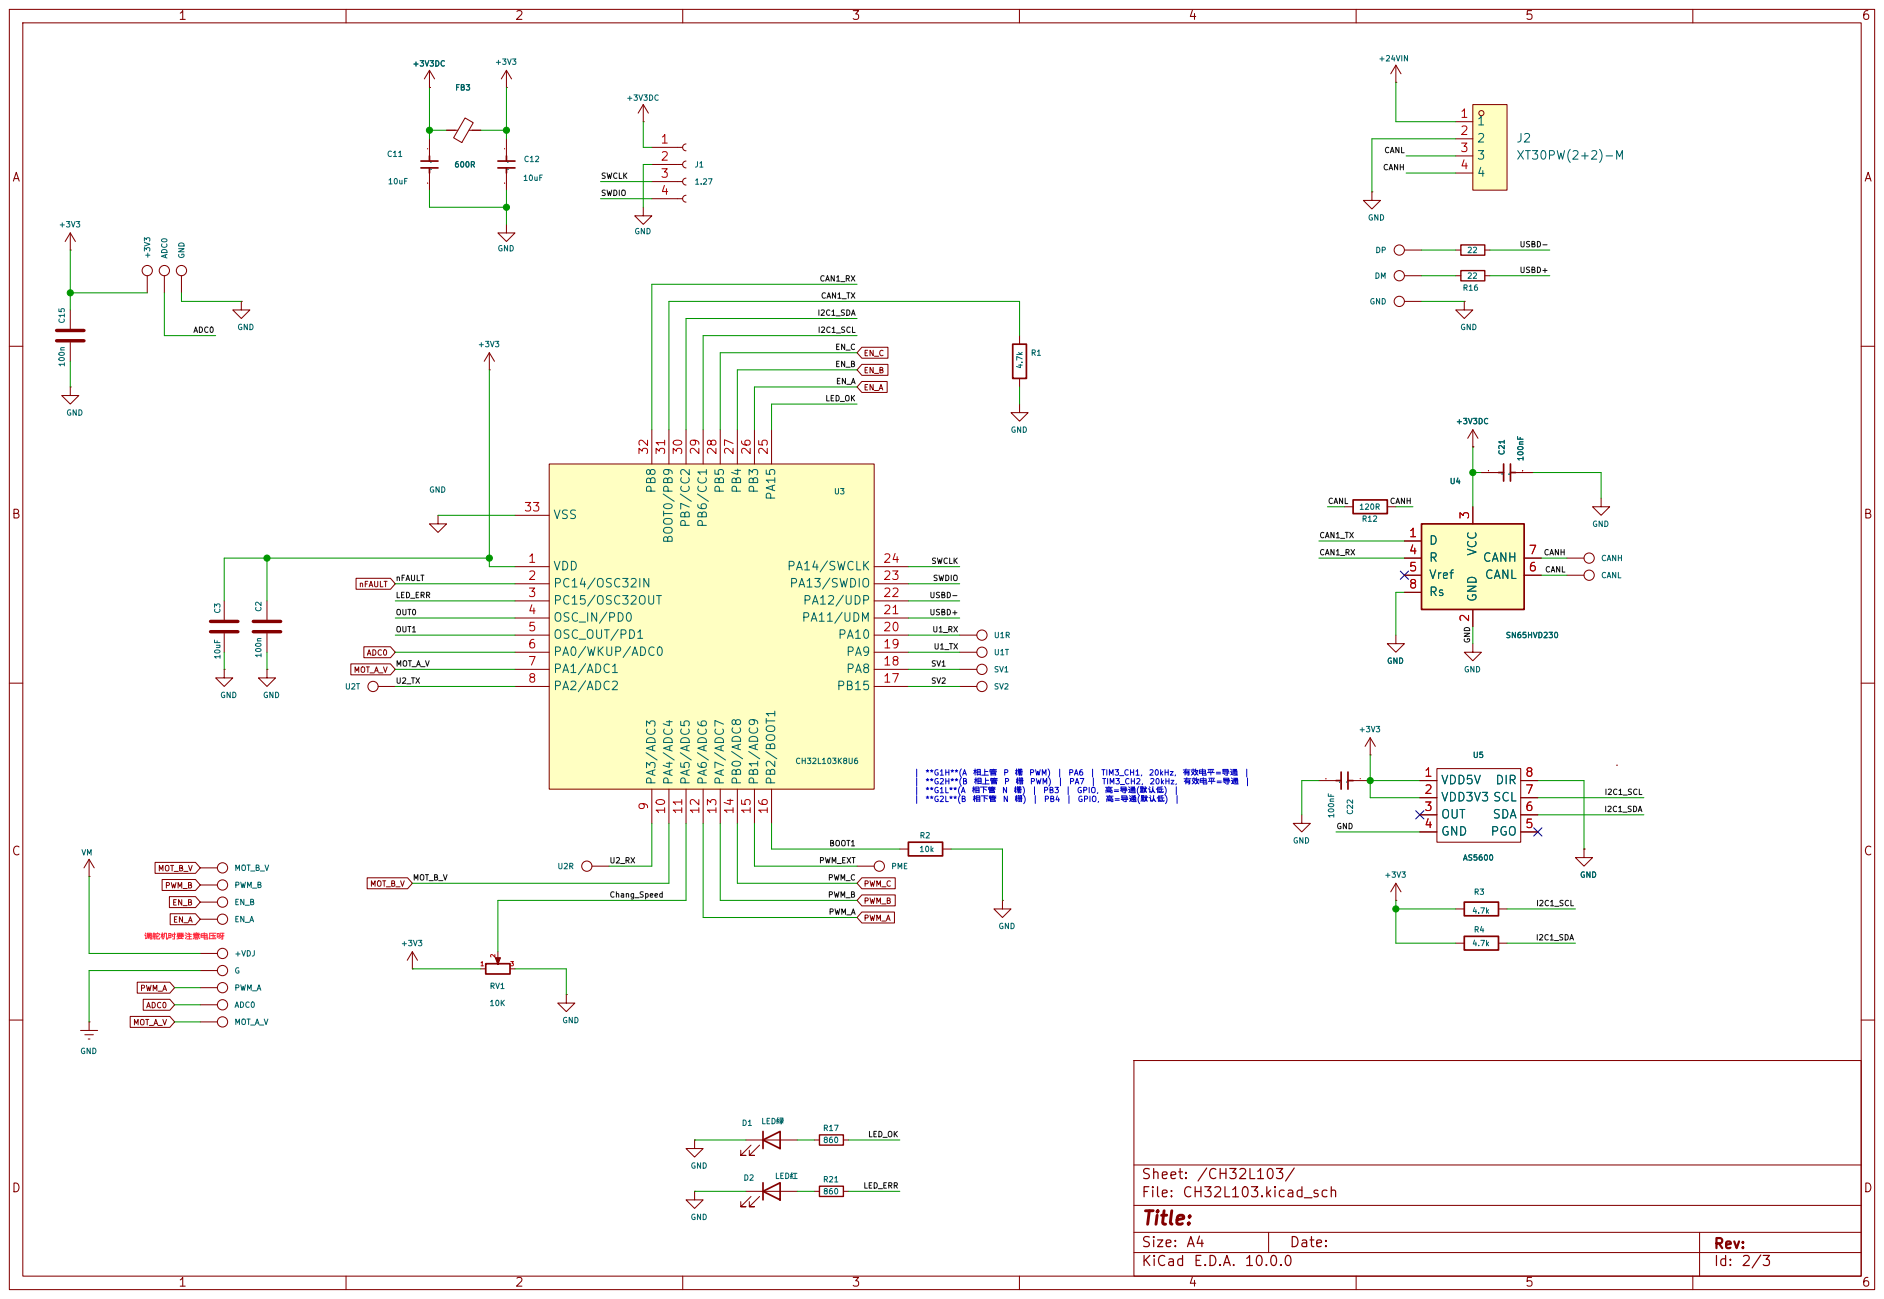
[picture p11: page 2]

9 PA4/ADC4 10 PA5/ADC5 11 PA6/ADC6 12 PA7/ADC7 13 PB0/ADC8 14 PB1/ADC9 15 PB2/BOOT1 16 PB15 17 PA8 18 PA9 19 PA10 20 PA11/UDM 21 PA12/UDP 22 PA13/SWDIO 23 PA14/SWCLK 24 PA15 25 PB3 26 PB4 27 PB5 28 PB6/CC1 29 PB7/CC2 30 BOOT0/PB9 31 PB8 32

**G1H**(A 相上管 P 栅 PWM) | PA6 | TIM3_CH1, 20kHz, 有效电平=导通
**G2H**(B 相上管 P 栅 PWM) | PA7 | TIM3_CH2, 20kHz, 有效电平=导通
**G1L**(A 相下管 N 栅) | PB3 | GPIO, 高=导通(默认低)
**G2L**(B 相下管 N 栅) | PB4 | GPIO, 高=导通(默认低)
PWM_EXT LED_ERR

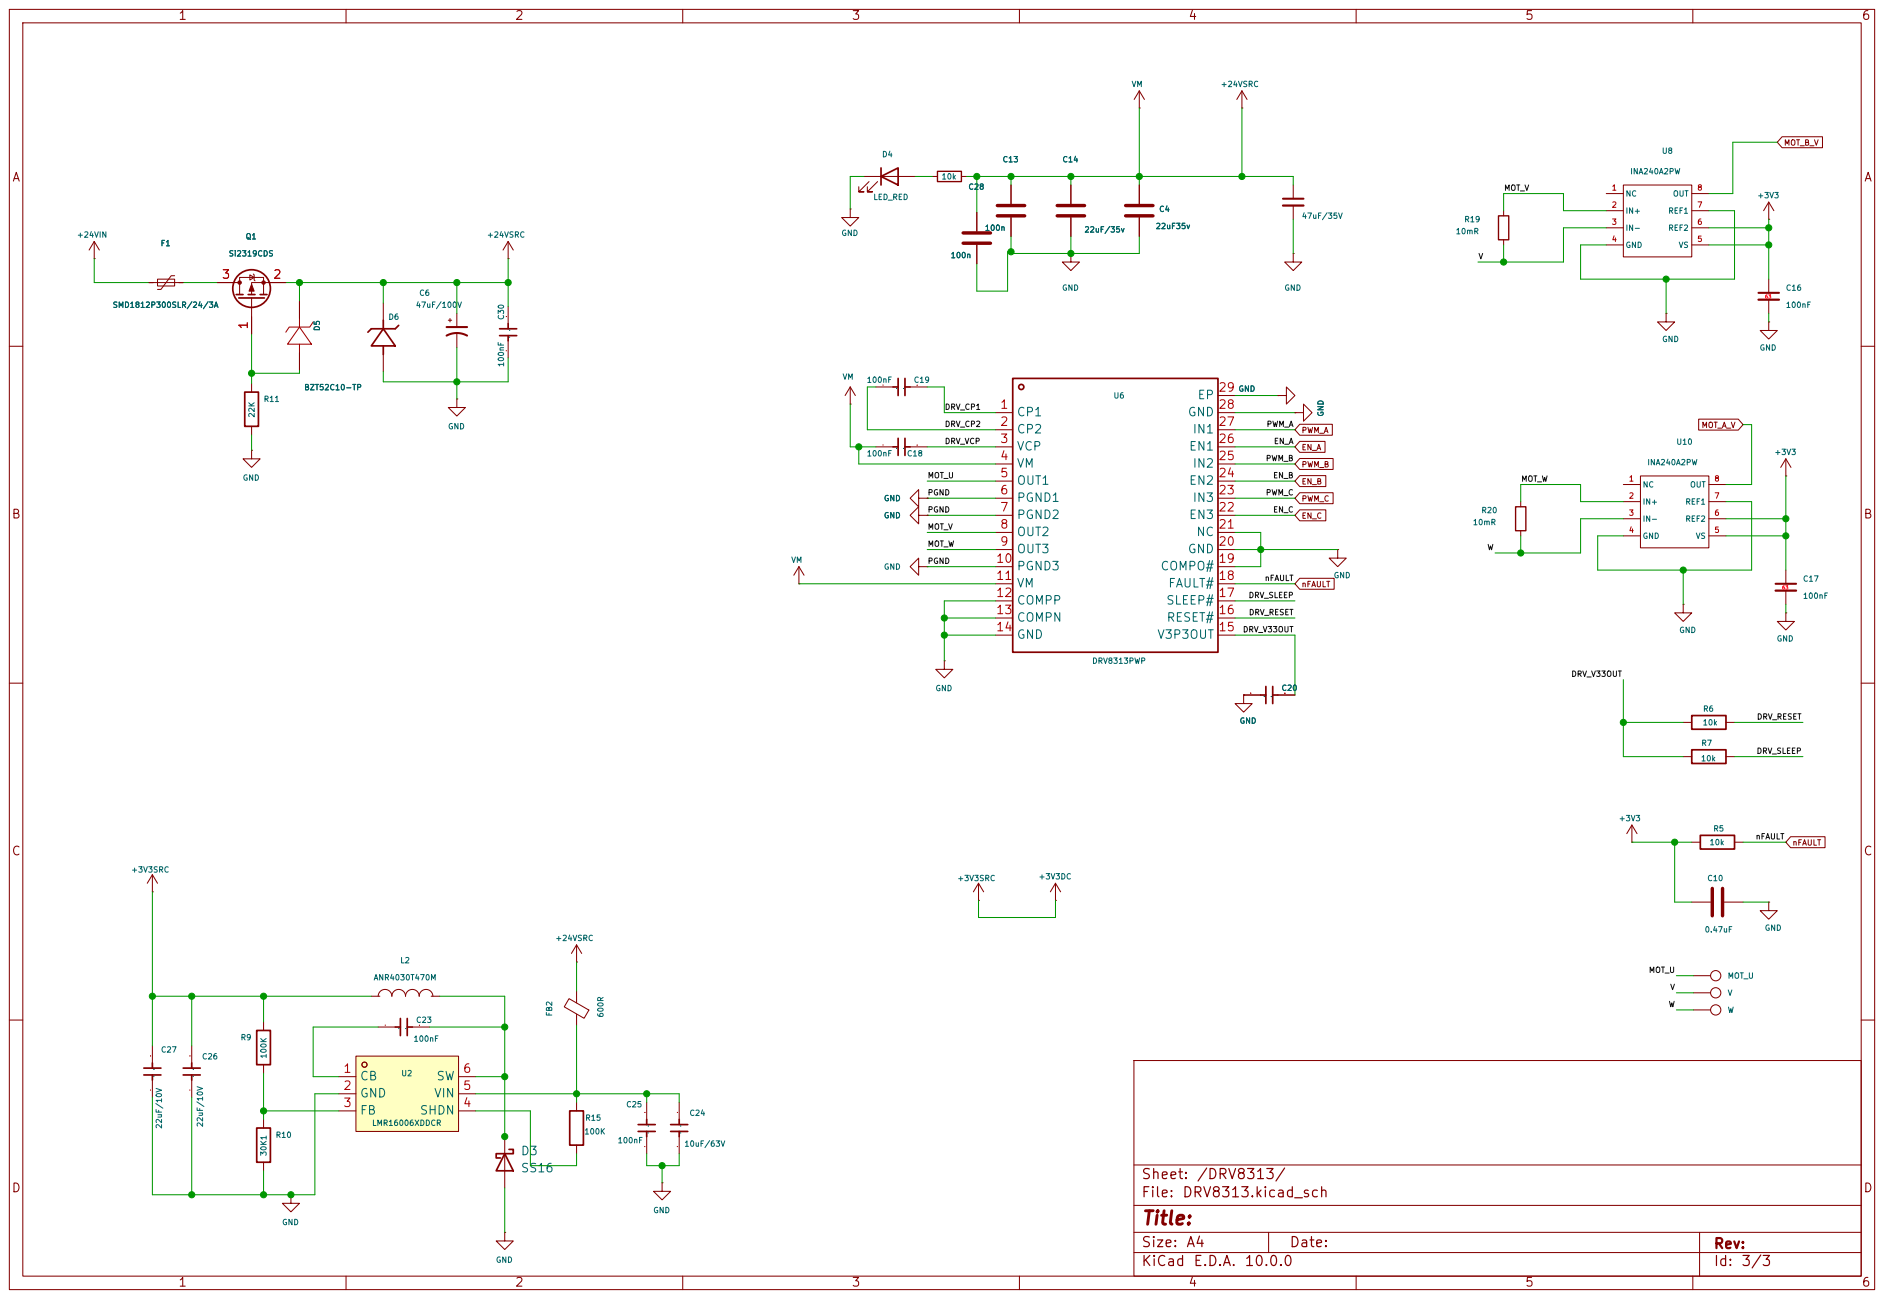
[picture p12: page 3]
