bjthemost-hub/l103-drv8313-as5600/hardware/L103_CANUSB_DRV8313.kicad_pcb

## KiCad design hardware/L103_CANUSB_DRV8313.kicad_pcb (2026-10-27)

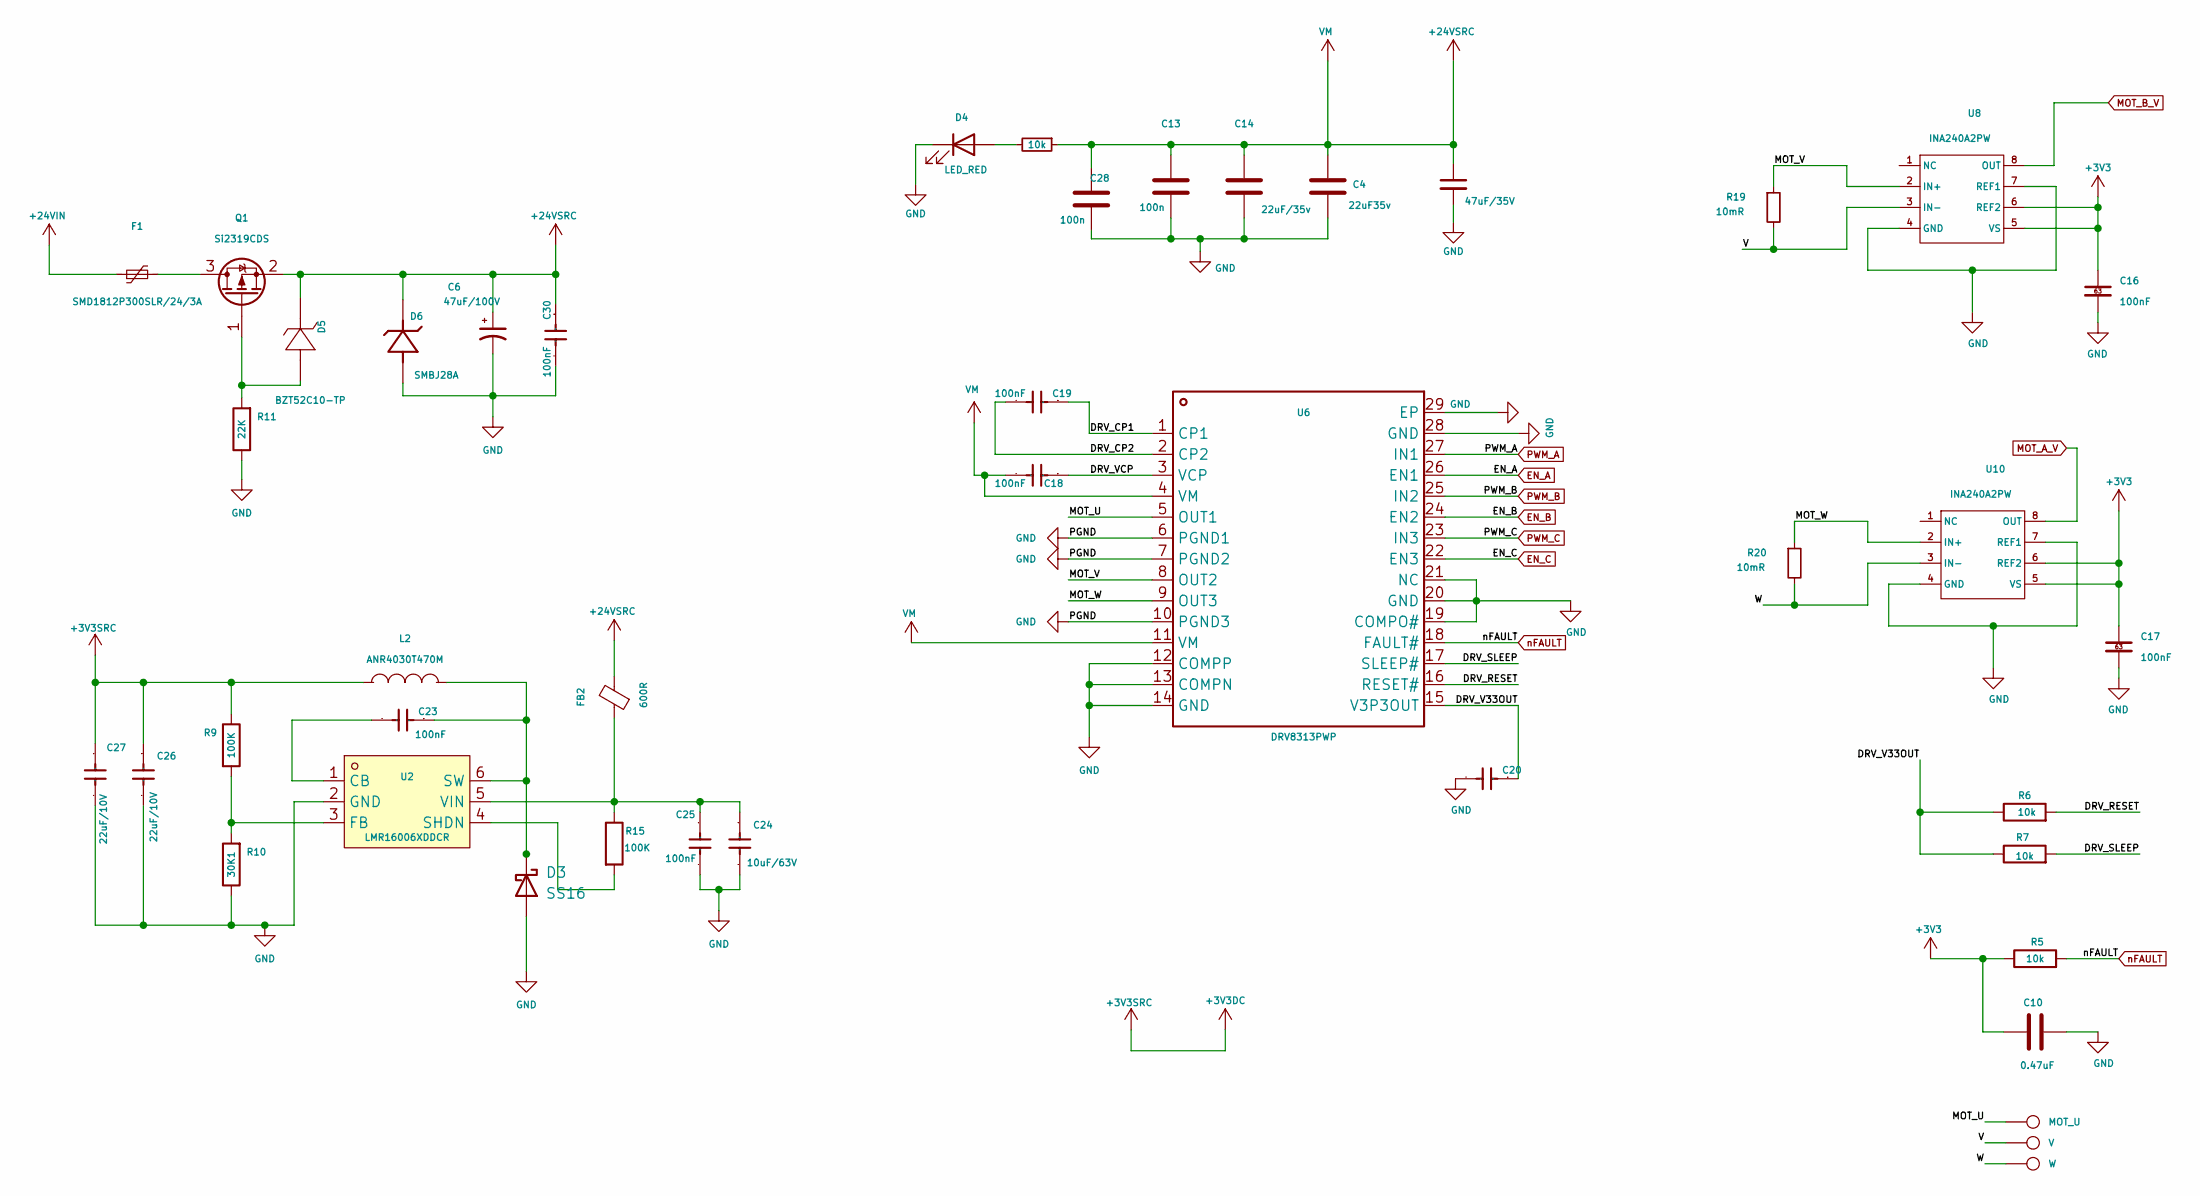
[picture p13: schematic DRV8313.kicad_sch]

Parts:
C4: 22uF35v; C_0805_2012Metric
C5: 47uF/35V; C_1206_3216Metric
C6: 47uF/100V; C_2220_5750Metric
C10: 0.47uF; C_0603_1608Metric
C13, C28: 100n; C_0603_1608Metric
C14: 22uF/35v; C_0805_2012Metric
C16, C17, C18, C19, C23, C25, C30: 100nF; C_0603_1608Metric
C20: 1Uf; C_0603_1608Metric
C24: 10uF/63V; C_0805_2012Metric
C26, C27: 22uF/10V; C_0805_2012Metric
D3: SS16; D_SMA
D4: LED_RED; LED_0603_1608Metric
D5: BZT52C10-TP; BZT52C16S; ZENER VOLTAGE(NOM) 10V; ZENER VOLTAGE(RANGE) 9.4V~10.6V; MANUFACTURERPART BZT52C10-TP; LCSC PART NAME 耐压:10V 电流:0.2uA
D6: SMBJ28A; D_SMB; BREAKDOWN VOLTAGE 28.9V; MANUFACTURER PART SMBJ28A; LCSC PART NAME SMBJ28A
F1: SMD1812P300SLR/24/3A; L_1812_4532Metric
FB2: 600R; L_0805_2012Metric
L2: ANR4030T470M; L_APV_ANR4030; MPN ANR4030T470M; LCSC Part C6364808
Q1: Si2319CDS; SOT-23
R5, R6, R7, R25: 10k; R_0603_1608Metric
R9, R15: 100K; R_0603_1608Metric
R10: 30K1; R_0603_1608Metric
R11: 22K; R_0603_1608Metric
R19, R20: 10mR; R_0805_2012Metric
TP28: MOT_U; TestPoint_Loop_D2.50mm_Drill1.0mm
TP29: V; TestPoint_Loop_D2.50mm_Drill1.0mm
TP30: W; TestPoint_Loop_D2.50mm_Drill1.0mm
U2: LMR16006XDDCR; SOT-23-6; MPN LMR16006XDDCR; LCSC Part C87080
U6: DRV8313PWP; HTSSOP-28-1EP_4.4x9.7mm_P0.65mm_EP2.85x5.4mm_ThermalVias
U8, U10: INA240A2PW; TSSOP-8_4.4x3mm_P0.65mm

Connections:
+3V3: C10.1, C16.1, C17.1, R5.1, U8.5 (VS), U8.6 (REF2), U10.5 (VS), U10.6 (REF2); also elsewhere on the board
+3V3DC: C26.1, C27.1, L2.1, R9.1; also elsewhere on the board
+24VIN: F1.1; also elsewhere on the board
+24VSRC: C4.1, C5.1, C6.1, C13.1, C14.1, C18.2, C28.1, C30.1, D5.1 (C), D6.1 (K), FB2.2, Q1.2 (S), R25.1, U6.4 (VM), U6.11 (VM); also elsewhere on the board
/DRV8313/DRV_CP1: C19.1, U6.1 (CP1)
/DRV8313/DRV_CP2: C19.2, U6.2 (CP2)
/DRV8313/DRV_RESET: R6.2, U6.16 (RESET#)
/DRV8313/DRV_SLEEP: R7.2, U6.17 (SLEEP#)
/DRV8313/DRV_V33OUT: C20.1, R6.1, R7.1, U6.15 (V3P3OUT)
/DRV8313/DRV_VCP: C18.1, U6.3 (VCP)
/DRV8313/MOT_U: TP28.1 (1_1), U6.5 (OUT1)
/DRV8313/MOT_V: R19.1, U6.8 (OUT2), U8.2 (IN+)
/DRV8313/MOT_W: R20.1, U6.9 (OUT3), U10.2 (IN+)
/DRV8313/V: R19.2, TP29.1 (1_1), U8.3 (IN-)
/DRV8313/W: R20.2, TP30.1 (1_1), U10.3 (IN-)
EN_A: U6.26 (EN1); also elsewhere on the board
EN_B: U6.24 (EN2); also elsewhere on the board
EN_C: U6.22 (EN3); also elsewhere on the board
GND: C4.2, C5.2, C6.2, C10.2, C13.2, C14.2, C16.2, C17.2, C20.2, C24.2, C25.2, C26.2, C27.2, C28.2, C30.2, D3.2 (A), D4.1 (K), D6.2 (A), R10.1, R11.1, U2.2 (GND), U6.6 (PGND1), U6.7 (PGND2), U6.10 (PGND3), U6.12 (COMPP), U6.13 (COMPN), U6.14 (GND), U6.19 (COMPO#), U6.20 (GND), U6.21 (NC), U6.28 (GND), U6.29 (EP), U8.4 (GND), U8.7 (REF1), U10.4 (GND), U10.7 (REF1); also elsewhere on the board
MOT_A_V: U10.8 (OUT); also elsewhere on the board
MOT_B_V: U8.8 (OUT); also elsewhere on the board
unnamed: C23.1, D3.1 (K), L2.2, U2.6 (SW)
unnamed: D4.2 (A), R25.2
unnamed: D5.2 (A), Q1.1 (G), R11.2
unnamed: F1.2, Q1.3 (D)
unnamed: C23.2, U2.1 (CB)
unnamed: R9.2, R10.2, U2.3 (FB)
unnamed: R15.2, U2.4 (SHDN)
unnamed: C24.1, C25.1, FB2.1, R15.1, U2.5 (VIN)
PWM_A: U6.27 (IN1); also elsewhere on the board
PWM_B: U6.25 (IN2); also elsewhere on the board
PWM_C: U6.23 (IN3); also elsewhere on the board
nFAULT: R5.2, U6.18 (FAULT#); also elsewhere on the board

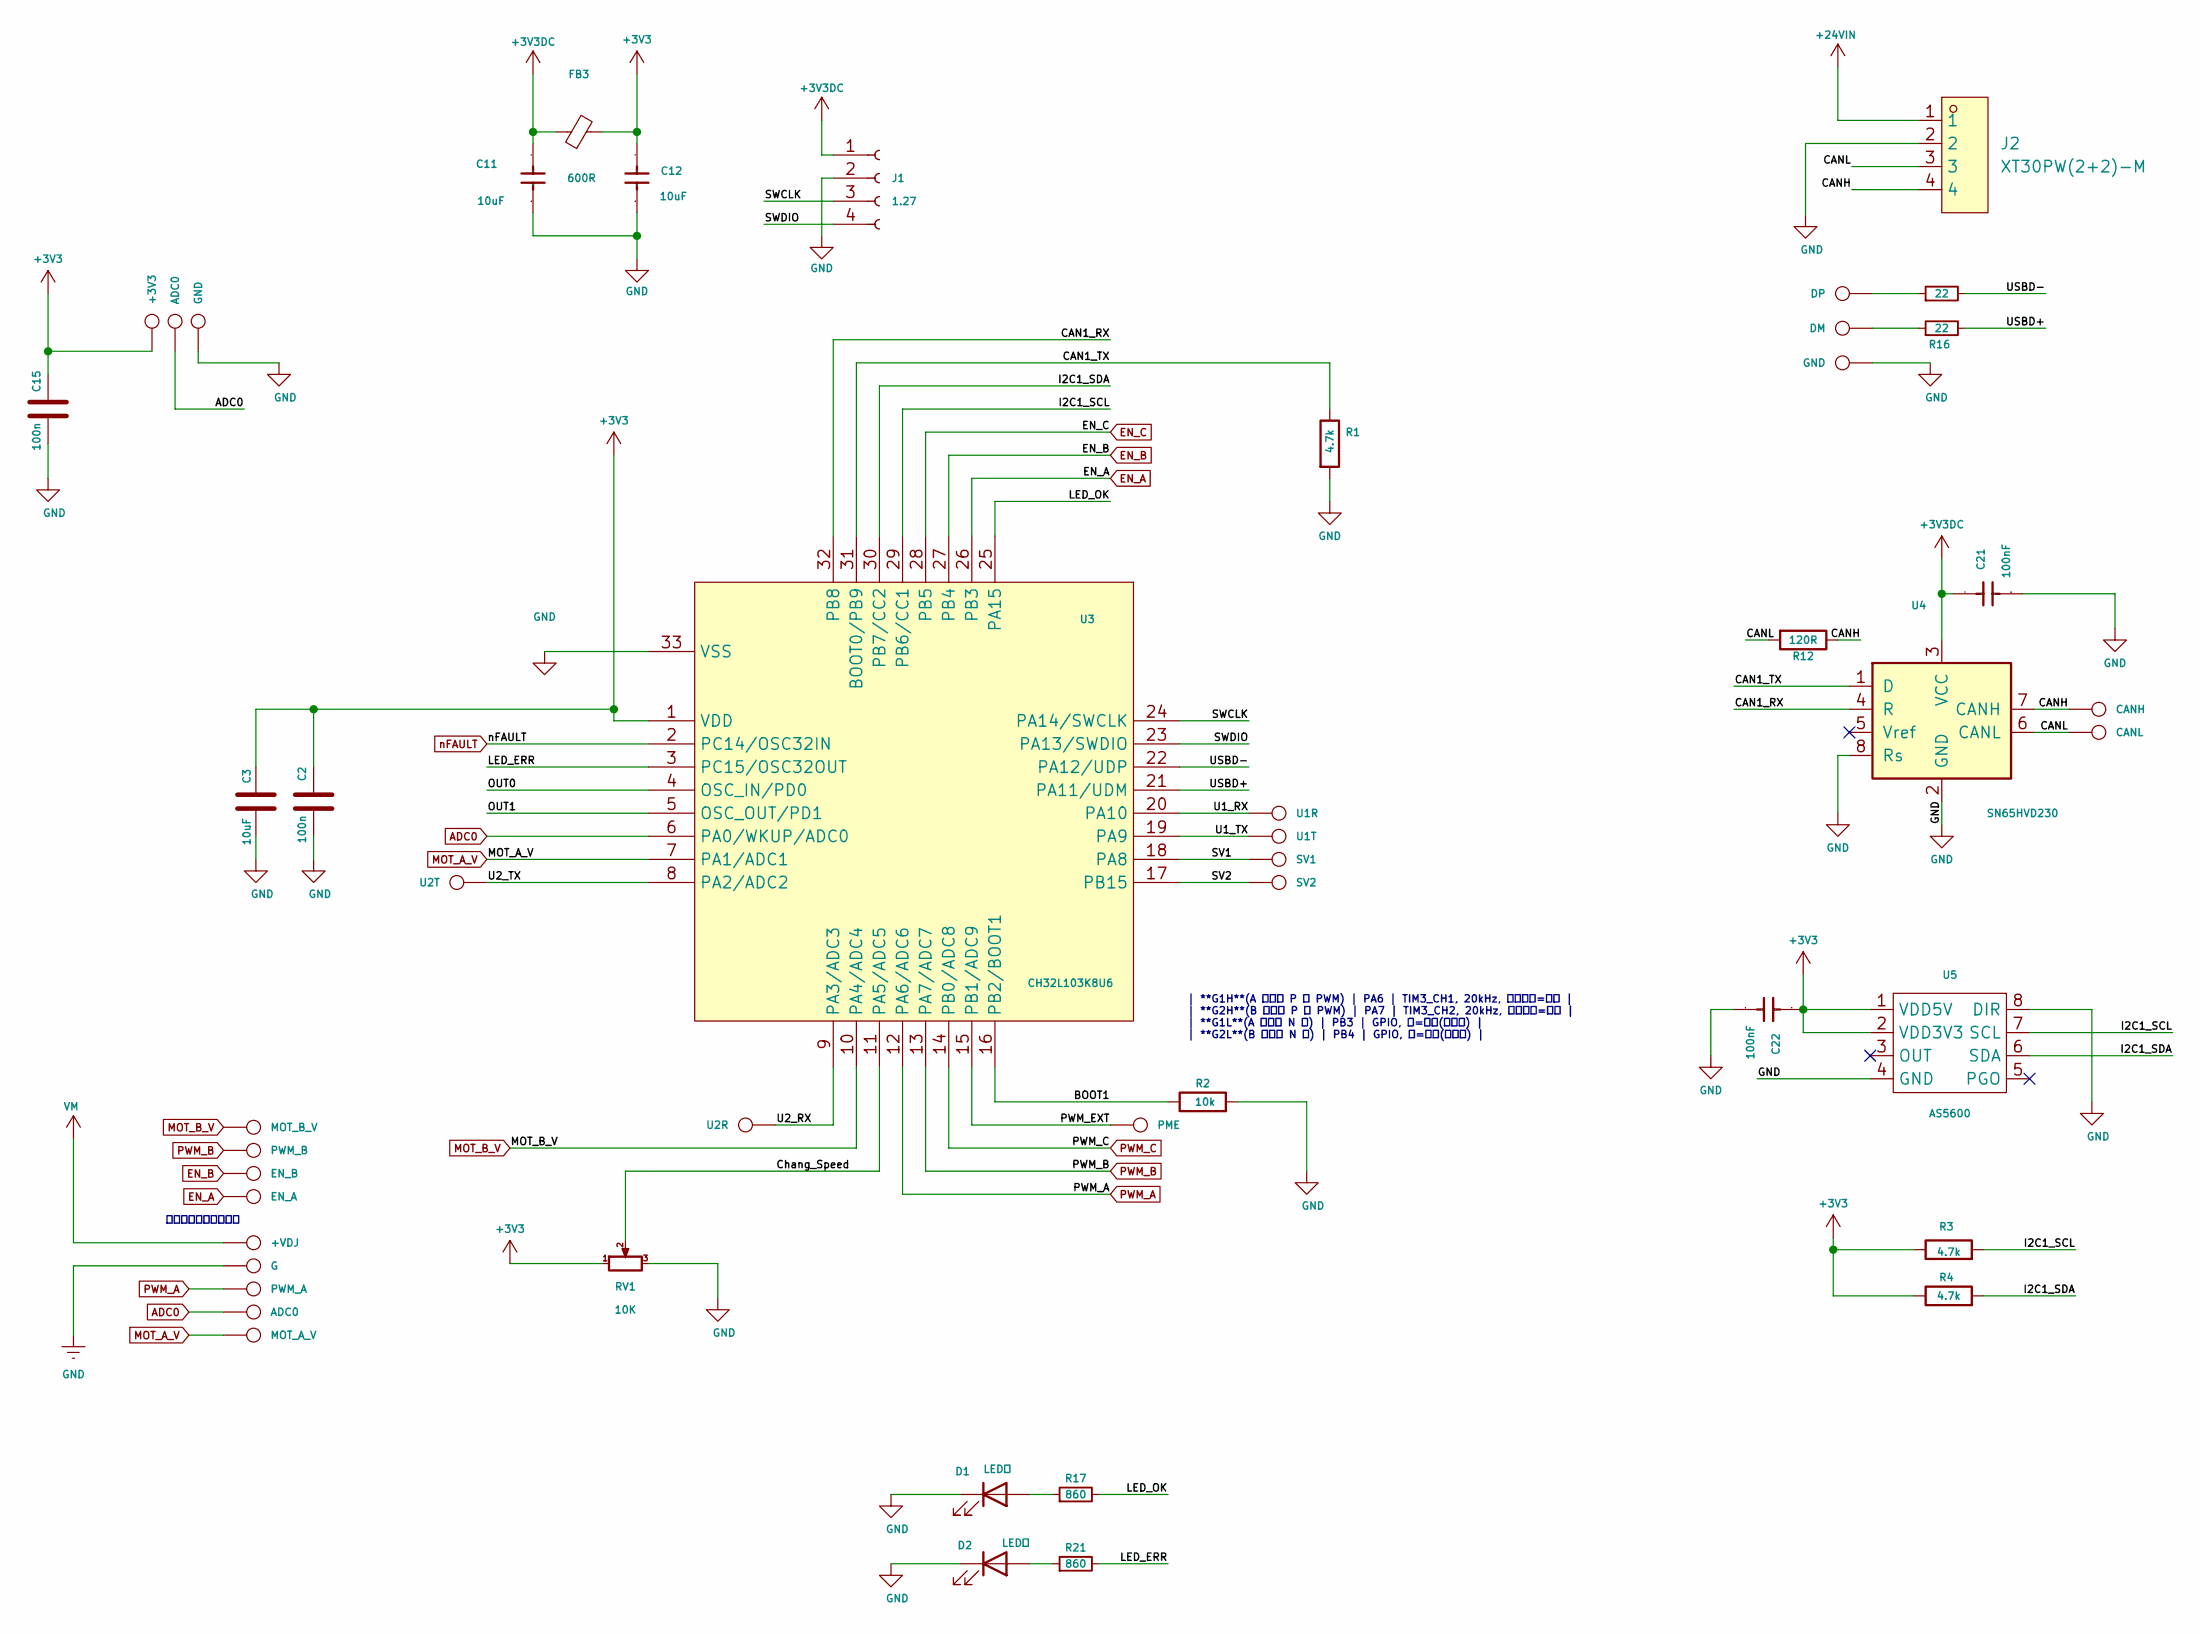
[picture p14: schematic CH32L103.kicad_sch]

Parts:
C2, C15: 100n; C_0603_1608Metric
C3, C11, C12: 10uF; C_0603_1608Metric
C21, C22: 100nF; C_0603_1608Metric
D1: LED绿; LED_0603_GREEN
D2: LED红; LED_0603_RED
FB3: 600R; L_0603_1608Metric
J1: 1.27; PinHeader_1x04_P1.27mm_Vertical
J2: XT30PW(2+2)-M; CONN-TH_4P-XT30PW-M; MPN XT30PW(2+2)-M.G.B; LCSC Part C19268030
R1, R3, R4: 4.7k; R_0603_1608Metric
R2: 10k; R_0603_1608Metric
R12: 120R; R_0805_2012Metric
R14, R16: 22; R_0603_1608Metric
R17, R21: 860; R_0603_1608Metric
RV1: 10K; Potentiometer_Alps_RK09K_Single_Vertical
TP1: SV2; TestPoint_Pad_D1.5mm_Z
TP2: SV1; TestPoint_Pad_D1.5mm_Z
TP3: MOT_B_V; TestPoint_Pad_D1.5mm_Z
TP4: PWM_B; TestPoint_Pad_D1.5mm_Z
TP5: U2T; TestPoint_Pad_D1.5mm_Z
TP6: U2R; TestPoint_Pad_D1.5mm_Z
TP7: PME; TestPoint_Pad_D1.5mm_Z
TP8: U1R; TestPoint_Pad_D1.5mm_Z
TP9: U1T; TestPoint_Pad_D1.5mm_Z
TP11: DP; TestPoint_Pad_D1.5mm_Z
TP12: DM; TestPoint_Pad_D1.5mm_Z
TP13, TP25: GND; TestPoint_Pad_D1.5mm_Z
TP14: EN_B; TestPoint_Pad_D1.5mm_Z
TP15: EN_A; TestPoint_Pad_D1.5mm_Z
TP16: PWM_A; TestPoint_Pad_D1.5mm_Z
TP17, TP24: ADC0; TestPoint_Pad_D1.5mm_Z
TP18: MOT_A_V; TestPoint_Pad_D1.5mm_Z
TP19: +VDJ; TestPoint_Pad_D1.5mm_Z
TP20: G; TestPoint_Pad_D1.5mm_Z
TP23: +3V3; TestPoint_Pad_D1.5mm_Z
TP26: CANH; TestPoint_Pad_D1.5mm_Z
TP27: CANL; TestPoint_Pad_D1.5mm_Z
U3: CH32L103K8U6; QFN-32-1EP_4x4mm_P0.4mm_EP2.65x2.65mm
U4: SN65HVD230; SOIC-8_3.9x4.9mm_P1.27mm
U5: AS5600; SOIC-8_3.9x4.9mm_P1.27mm

Connections:
+3V3: C2.1, C3.1, C12.2, C15.1, C22.2, FB3.2, R3.1, R4.1, RV1.1, TP23.1 (1_1), U3.1 (VDD), U5.1 (VDD5V), U5.2 (VDD3V3); also elsewhere on the board
+3V3DC: C11.2, C21.2, FB3.1, J1.1, U4.3 (VCC); also elsewhere on the board
+24VIN: J2.1; also elsewhere on the board
+24VSRC: TP19.1 (1_1); also elsewhere on the board
/CH32L103/BOOT1: R2.1, U3.16 (PB2/BOOT1)
/CH32L103/CAN1_RX: U3.32 (PB8), U4.4 (R)
/CH32L103/CAN1_TX: R1.1, U3.31 (BOOT0/PB9), U4.1 (D)
/CH32L103/CANH: J2.4, R12.1, TP26.1 (1_1), U4.7 (CANH)
/CH32L103/CANL: J2.3, R12.2, TP27.1 (1_1), U4.6 (CANL)
/CH32L103/Chang_Speed: RV1.2, U3.11 (PA5/ADC5)
/CH32L103/I2C1_SCL: R3.2, U3.29 (PB6/CC1), U5.7 (SCL)
/CH32L103/I2C1_SDA: R4.2, U3.30 (PB7/CC2), U5.6 (SDA)
/CH32L103/LED_ERR: R21.2, U3.3 (PC15/OSC32OUT)
/CH32L103/LED_OK: R17.2, U3.25 (PA15)
/CH32L103/OUT0: U3.4 (OSC_IN/PD0)
/CH32L103/OUT1: U3.5 (OSC_OUT/PD1)
/CH32L103/PWM_EXT: TP7.1 (1_1), U3.15 (PB1/ADC9)
/CH32L103/SV1: TP2.1 (1_1), U3.18 (PA8)
/CH32L103/SV2: TP1.1 (1_1), U3.17 (PB15)
/CH32L103/SWCLK: J1.3, U3.24 (PA14/SWCLK)
/CH32L103/SWDIO: J1.4, U3.23 (PA13/SWDIO)
/CH32L103/U1_RX: TP8.1 (1_1), U3.20 (PA10)
/CH32L103/U1_TX: TP9.1 (1_1), U3.19 (PA9)
/CH32L103/U2_RX: TP6.1 (1_1), U3.9 (PA3/ADC3)
/CH32L103/U2_TX: TP5.1 (1_1), U3.8 (PA2/ADC2)
/CH32L103/USBD+: R16.2, U3.21 (PA11/UDM)
/CH32L103/USBD-: R14.2, U3.22 (PA12/UDP)
ADC0: TP17.1 (1_1), TP24.1 (1_1), U3.6 (PA0/WKUP/ADC0)
EN_A: TP15.1 (1_1), U3.26 (PB3); also elsewhere on the board
EN_B: TP14.1 (1_1), U3.27 (PB4); also elsewhere on the board
EN_C: U3.28 (PB5); also elsewhere on the board
GND: C2.2, C3.2, C11.1, C12.1, C15.2, C21.1, C22.1, D1.1 (K), D2.1 (K), J1.2, J2.2, R1.2, R2.2, RV1.3, TP13.1 (1_1), TP20.1 (1_1), TP25.1 (1_1), U3.33 (VSS), U4.2 (GND), U4.8 (Rs), U5.4 (GND), U5.8 (DIR); also elsewhere on the board
MOT_A_V: TP18.1 (1_1), U3.7 (PA1/ADC1); also elsewhere on the board
MOT_B_V: TP3.1 (1_1), U3.10 (PA4/ADC4); also elsewhere on the board
unnamed: D1.2 (A), R17.1
unnamed: D2.2 (A), R21.1
unnamed: R14.1, TP11.1 (1_1)
unnamed: R16.1, TP12.1 (1_1)
PWM_A: TP16.1 (1_1), U3.12 (PA6/ADC6); also elsewhere on the board
PWM_B: TP4.1 (1_1), U3.13 (PA7/ADC7); also elsewhere on the board
PWM_C: U3.14 (PB0/ADC8); also elsewhere on the board
nFAULT: U3.2 (PC14/OSC32IN); also elsewhere on the board

Notes on the sheet:
| **G1H**(A 相上管 P 栅 PWM) | PA6 | TIM3_CH1, 20kHz, 有效电平=导通 | | **G2H**(B 相上管 P 栅 PWM) | PA7 | TIM3_CH2, 20kHz, 有效电平=导通 | | **G1L**(A 相下管 N 栅) | PB3 | GPIO, 高=导通(默认低) | | **G2L**(B 相下管 N 栅) | PB4 | GPIO, 高=导通(默认低) |
调舵机时要注意电压呀

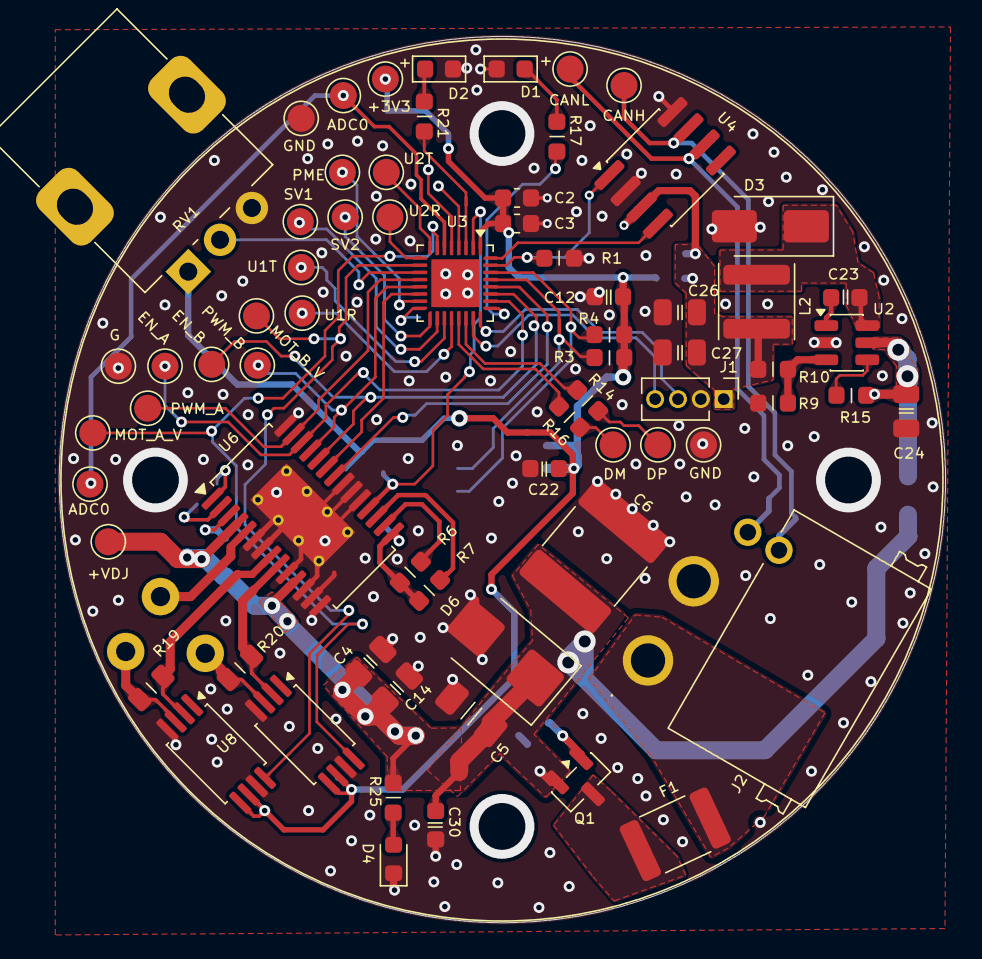
[picture p15: board L103_CANUSB_DRV8313.kicad_pcb from above]

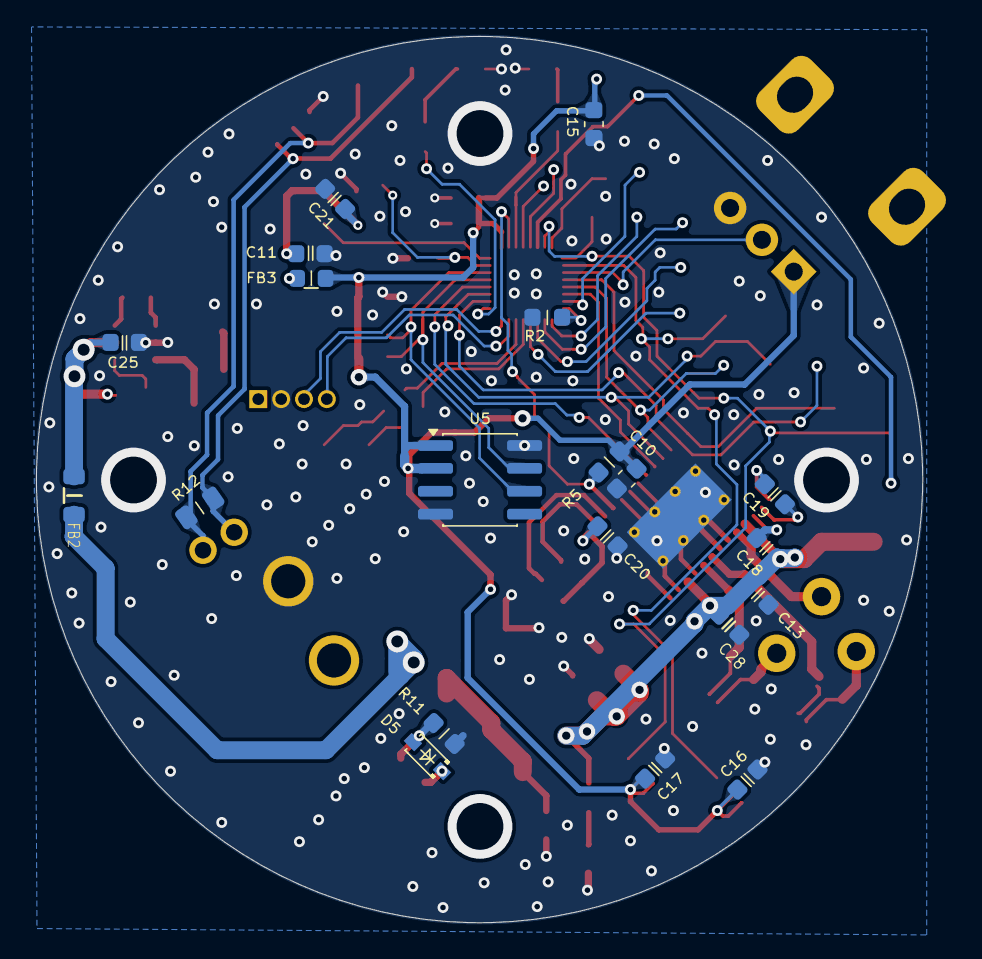
[picture p16: board L103_CANUSB_DRV8313.kicad_pcb from below]

Board: 2 copper layers, 49.2 x 49.2 mm, 92 parts (20 on the bottom side), 59 nets.
